JitterCompany/KicadComponents/3D/SRP3212A.stp

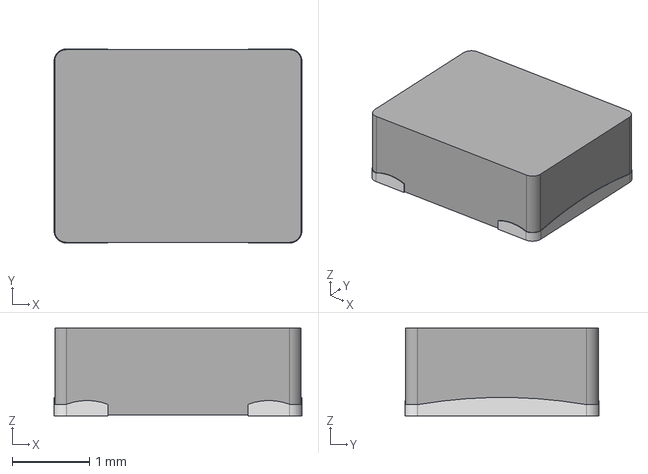
[picture p1: CAD file, 2026-11-06]
3D/SRP3212A.stp
3.22 x 2.52 x 1.14 mm
