JitterCompany/KicadComponents/3D/Hirose_FH12-40S-0.5SH_1x40-1MP_P0.50mm_Horizontal.step

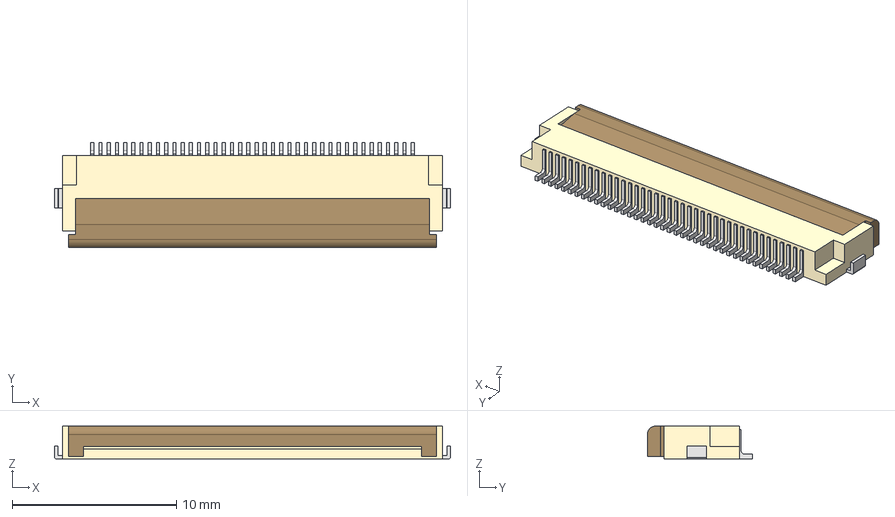
[picture p2: CAD file, 2026-08-26]
3D/Hirose_FH12-40S-0.5SH_1x40-1MP_P0.50mm_Horizontal.step
24.1 x 6.40 x 2.00 mm
lock
pins
