JitterCompany/KicadComponents/3D/Wurth_microSD_693072010801.stp

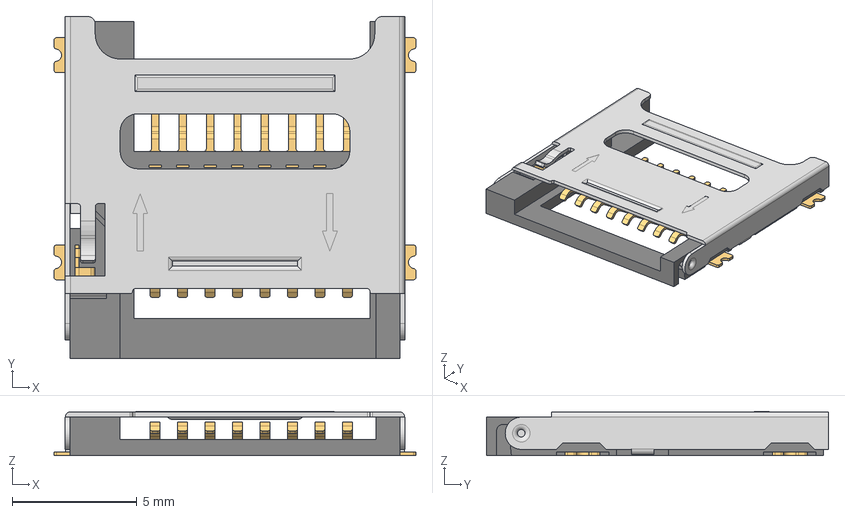
[picture p3: CAD file, 2026-08-25]
3D/Wurth_microSD_693072010801.stp
14.5 x 13.7 x 1.77 mm
693072010801_PIN x 8
693072010801_PATTE x 3
693072010801_CACHE
693072010801_PATTE_SPE
