JitterCompany/KicadComponents/3D/PT-1340P-P10-PQ.step

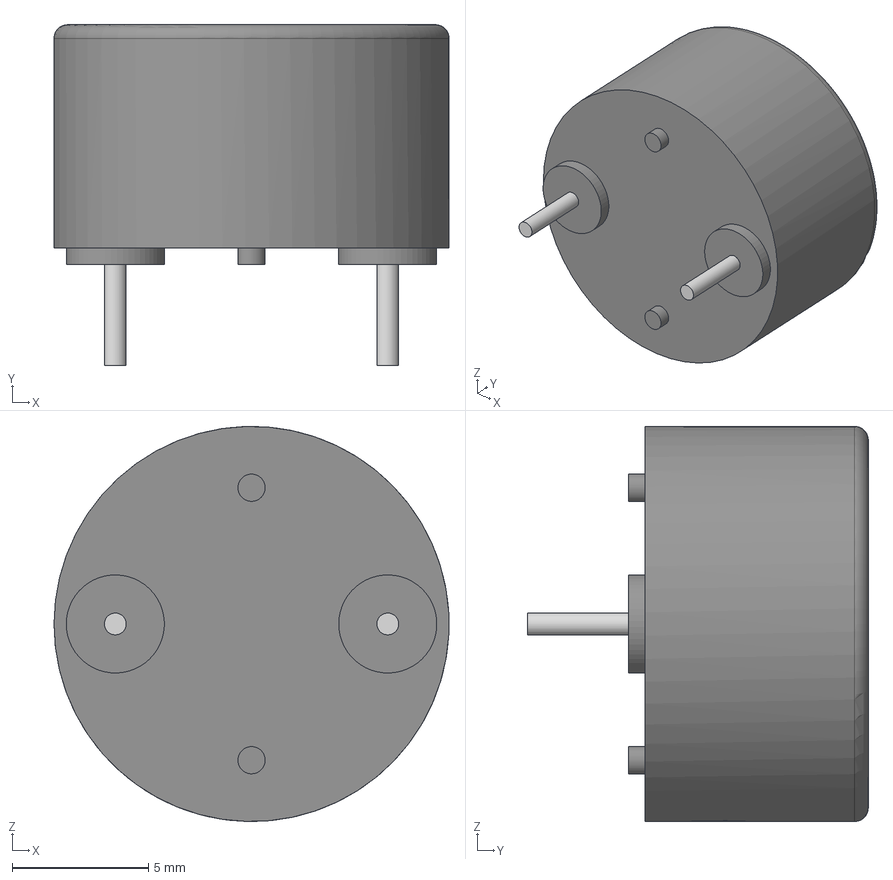
[picture p4: CAD file, 2026-08-25]
3D/PT-1340P-P10-PQ.step
14.5 x 12.5 x 14.5 mm
