JitterCompany/KicadComponents/3D/DHVQFN-14.step

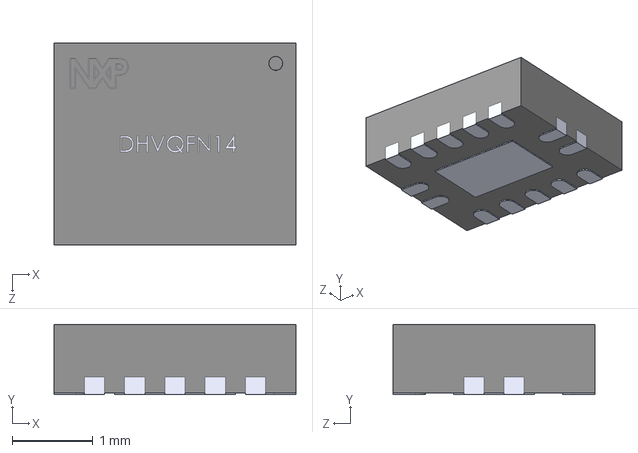
[picture p5: CAD file, 2026-08-25]
3D/DHVQFN-14.step
3.00 x 0.87 x 2.50 mm
