JitterCompany/KicadComponents/3D/M12A-08PFFP-SF8001.stp

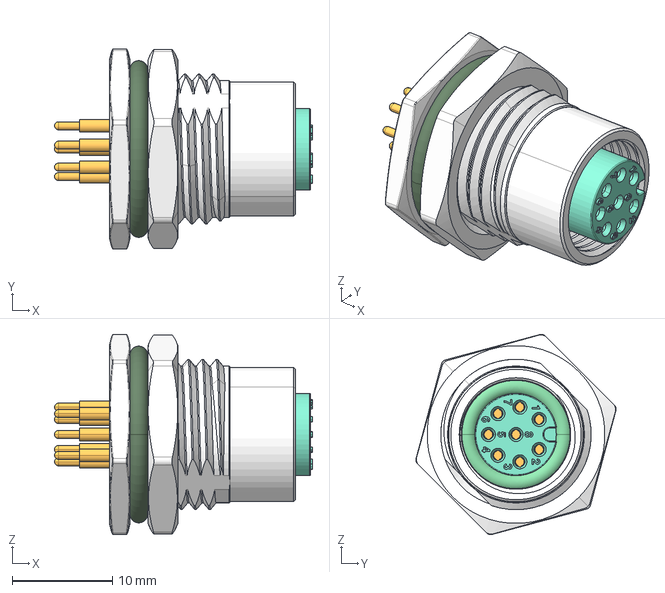
[picture p6: CAD file, 2026-08-17]
3D/M12A-08PFFP-SF8001.stp
25.7 x 20.0 x 20.0 mm
