JitterCompany/KicadComponents/3D/WE-CNSW_1206_CNSW.stp

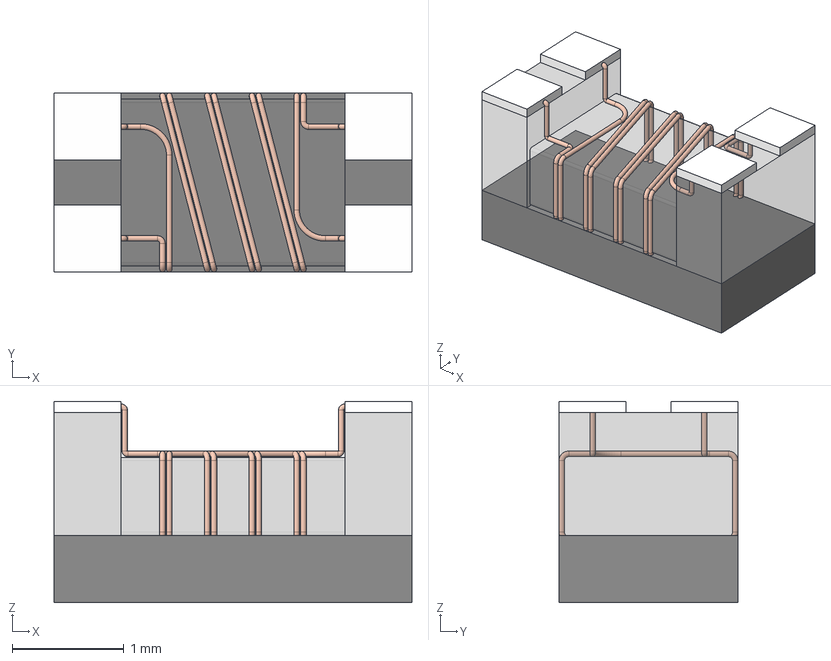
[picture p7: CAD file, 2026-08-17]
3D/WE-CNSW_1206_CNSW.stp
3.20 x 1.60 x 1.80 mm
Gehäuse
Boden
L飆fl踄he x 4
