JitterCompany/KicadComponents/3D/M12A-05PFFP-SF8001.step

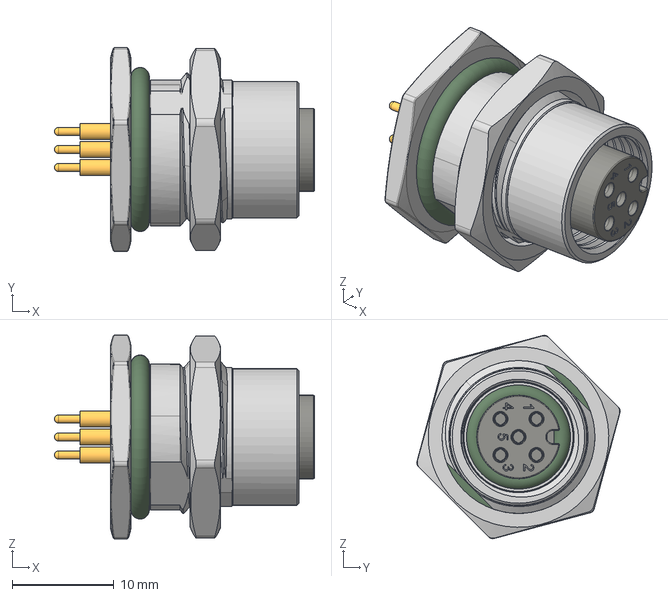
[picture p8: CAD file, 2026-08-17]
3D/M12A-05PFFP-SF8001.step
25.5 x 20.0 x 20.0 mm
