JitterCompany/KicadComponents/3D/U.FL_Hirose_U.FL-R-SMT-1_Vertical.step

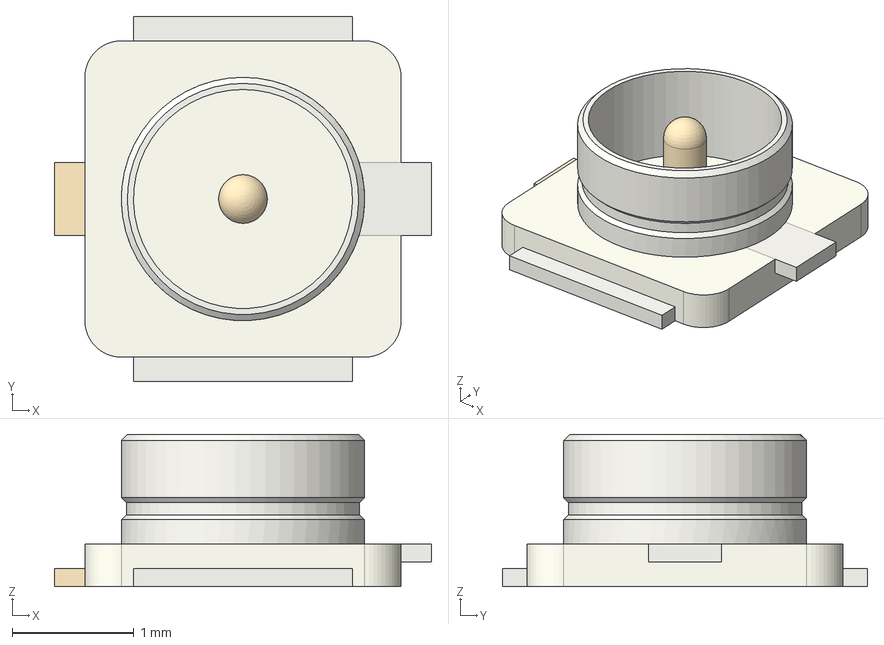
[picture p9: CAD file, 2026-08-17]
3D/U.FL_Hirose_U.FL-R-SMT-1_Vertical.step
3.10 x 3.00 x 1.25 mm
