JitterCompany/KicadComponents/3D/YMCP002AA.step

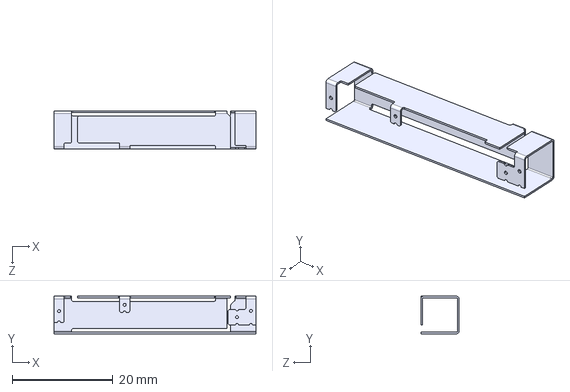
[picture p10: CAD file, 2026-08-17]
3D/YMCP002AA.step
40.0 x 7.43 x 7.60 mm
