JitterCompany/KicadComponents/3D/M12B-05PFFP-SF8001.stp

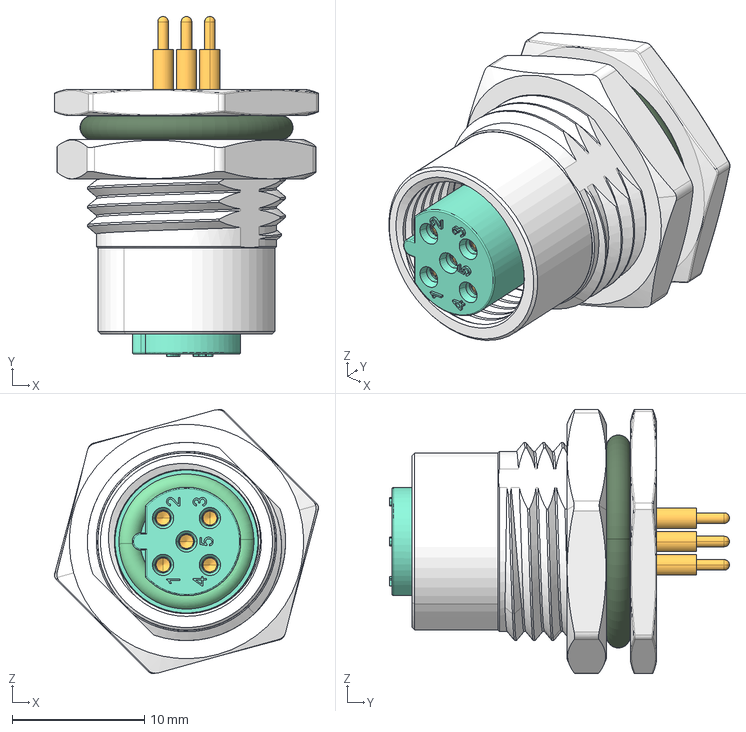
[picture p11: CAD file, 2026-08-17]
3D/M12B-05PFFP-SF8001.stp
20.0 x 25.7 x 20.0 mm
