JitterCompany/KicadComponents/3D/Quectel_EG915N.STEP

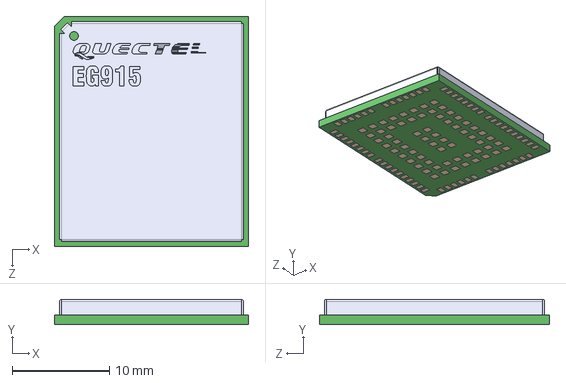
[picture p12: CAD file, 2026-08-17]
3D/Quectel_EG915N.STEP
19.9 x 2.60 x 23.6 mm
