JitterCompany/KicadComponents/3D/WE-MAPI-5030.stp

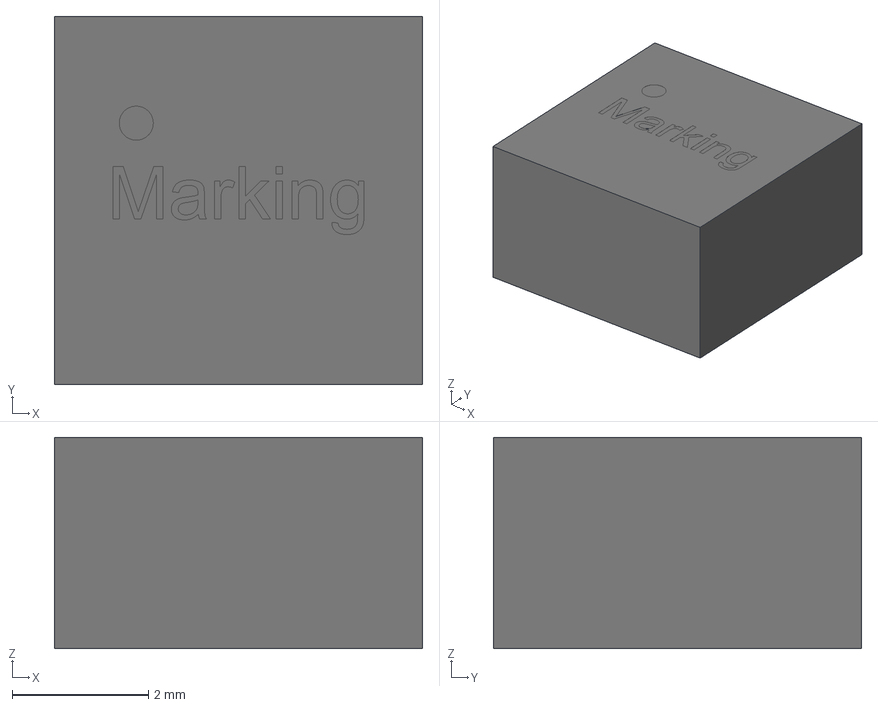
[picture p13: CAD file, 2026-08-17]
3D/WE-MAPI-5030.stp
5.40 x 5.40 x 3.10 mm
body_SSMC_5030
land_pattern x 2
