JitterCompany/KicadComponents/3D/DGN0008G_VSSOP-8_EP.stp

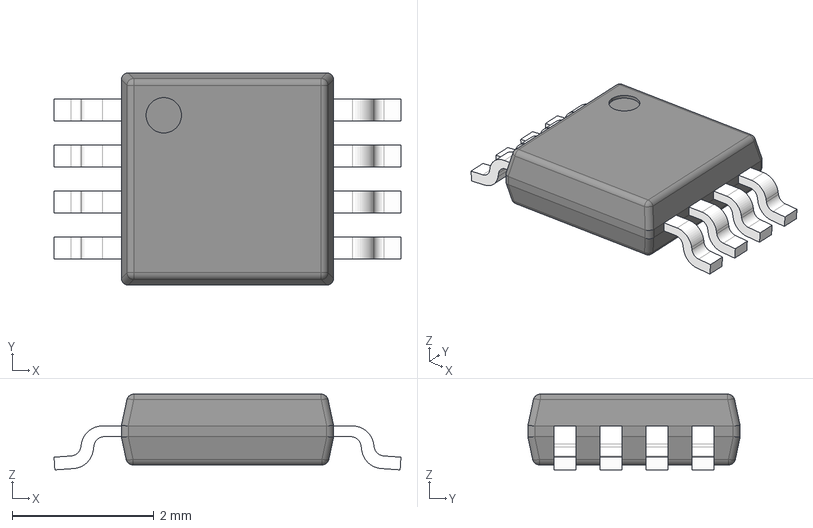
[picture p15: CAD file, 2026-08-17]
3D/DGN0008G_VSSOP-8_EP.stp
4.90 x 3.00 x 1.07 mm
BODY-DGN0008G
LEAD-DGN0008G x 8
PIN1_DGN0008G
DAP_DGN0008G
