JitterCompany/KicadComponents/3D/MSBS-05PFFP-SF8001.stp

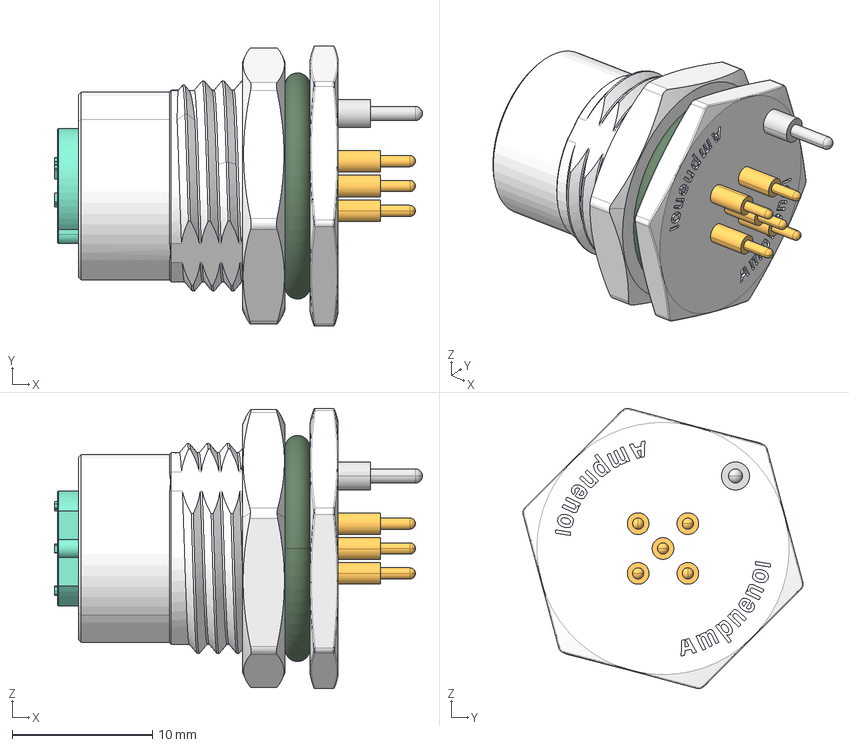
[picture p16: CAD file, 2026-08-17]
3D/MSBS-05PFFP-SF8001.stp
26.2 x 20.0 x 20.0 mm
