JitterCompany/KicadComponents/3D/SOT-363_SC-70-6.step

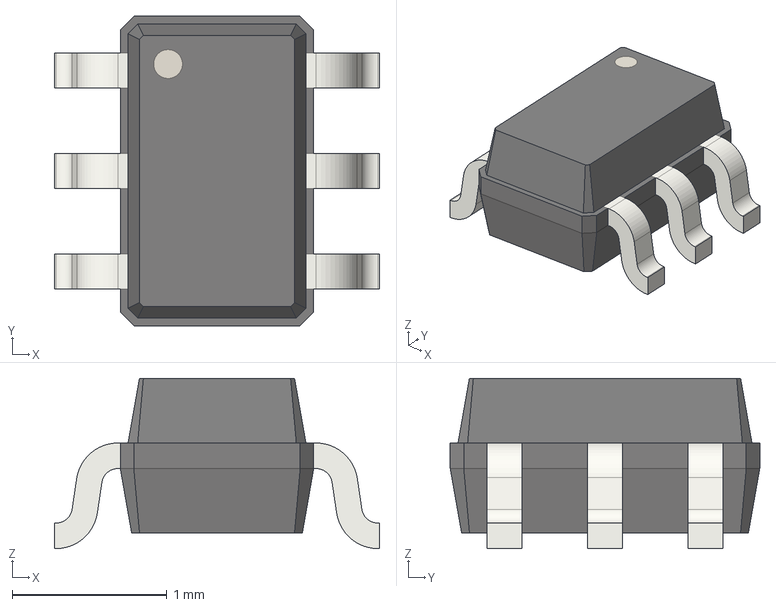
[picture p17: CAD file, 2026-08-17]
3D/SOT-363_SC-70-6.step
2.10 x 2.00 x 1.10 mm
