JitterCompany/KicadComponents/3D/samtec_clm-110-02-l-d.stp

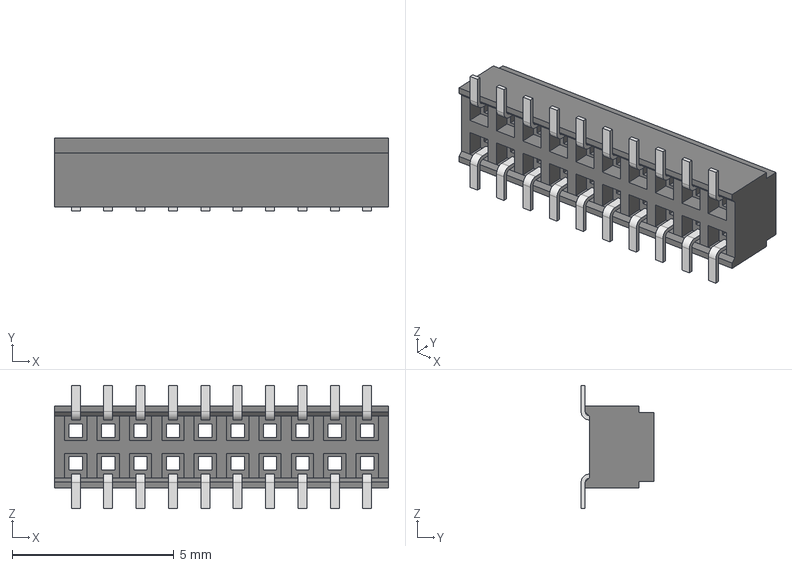
[picture p18: CAD file, 2026-08-17]
3D/samtec_clm-110-02-l-d.stp
10.3 x 2.25 x 3.81 mm
