JitterCompany/KicadComponents/3D/TO-269AA.step

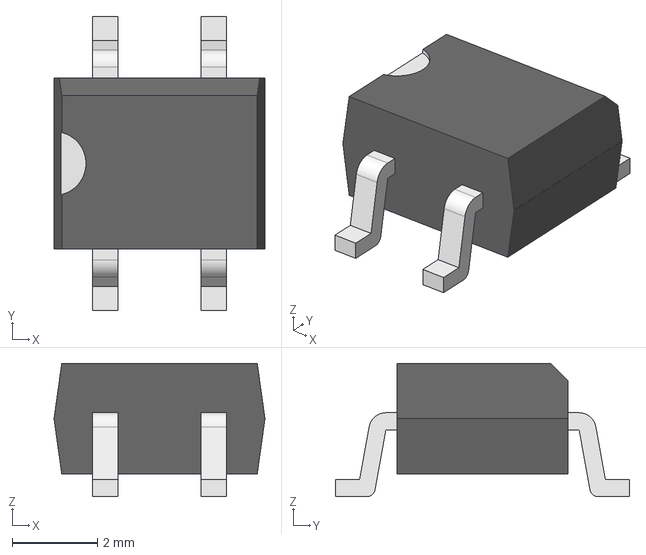
[picture p19: CAD file, 2026-08-17]
3D/TO-269AA.step
4.95 x 6.90 x 3.13 mm
