JitterCompany/KicadComponents/3D/GCT_USB4120-03-C_REVA.step

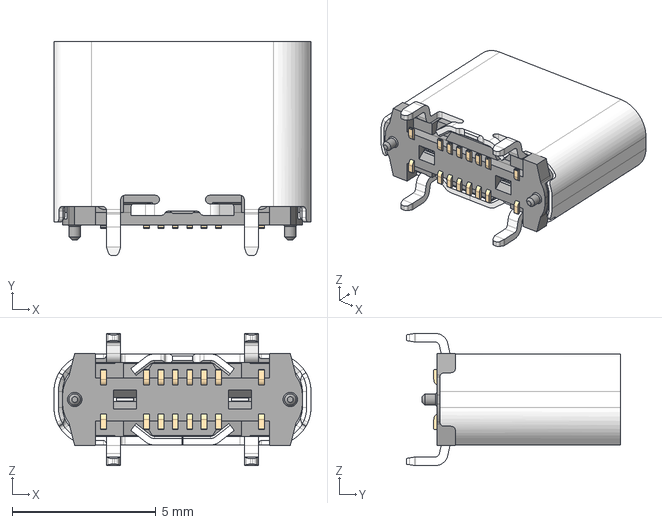
[picture p20: CAD file, 2025-04-25]
3D/GCT_USB4120-03-C_REVA.step
8.94 x 7.45 x 4.60 mm
