JitterCompany/KicadComponents/3D/PreciDip_811_6P.step

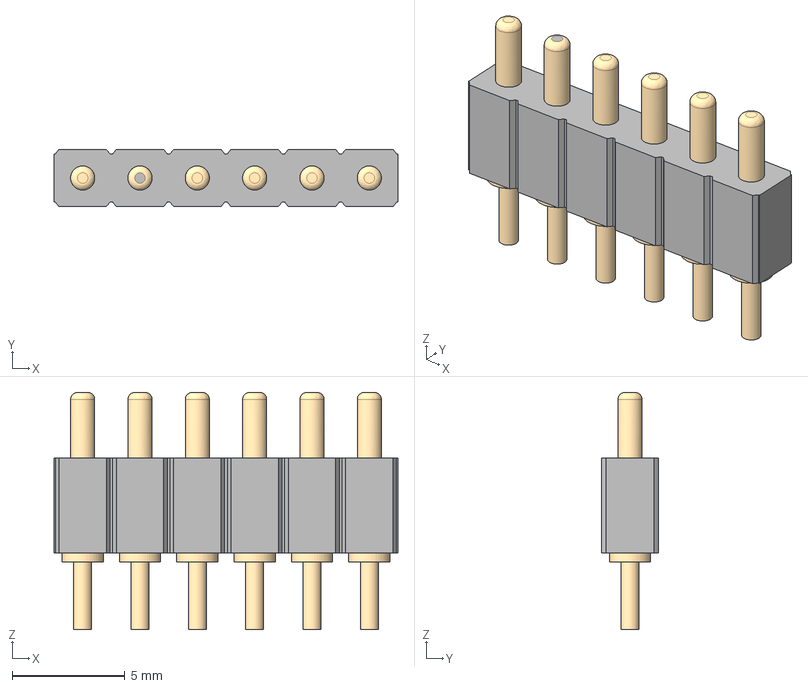
[picture p21: CAD file, 2025-04-25]
3D/PreciDip_811_6P.step
15.2 x 2.54 x 10.5 mm
