JitterCompany/KicadComponents/3D/Wurth_WR_WTB_66100811622_1x08_P2.54mm_Vertical.stp

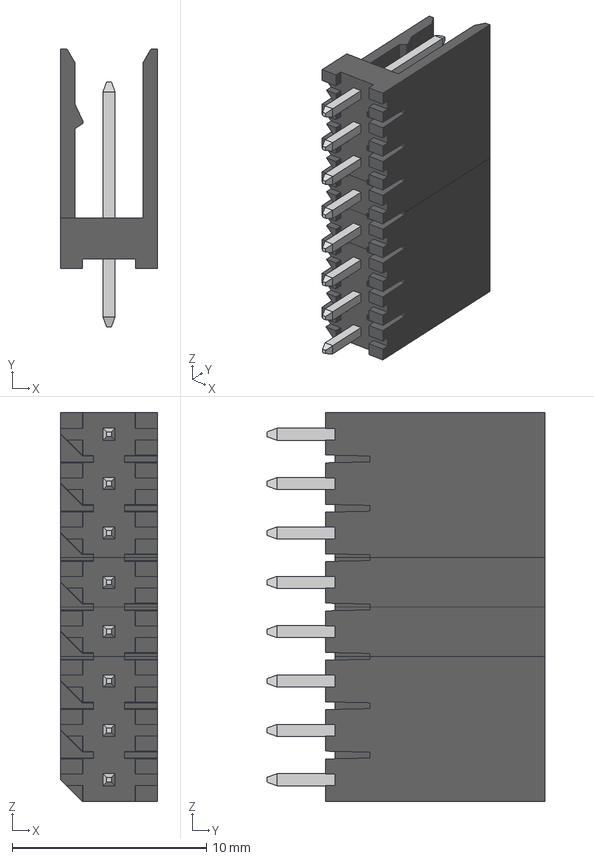
[picture p22: CAD file, 2025-04-25]
3D/Wurth_WR_WTB_66100811622_1x08_P2.54mm_Vertical.stp
5.00 x 14.3 x 20.0 mm
6610xx11622_07_20_DX
6610xx11622_07_20_SX
