JitterCompany/KicadComponents/3D/C&K_KMR7_button.step

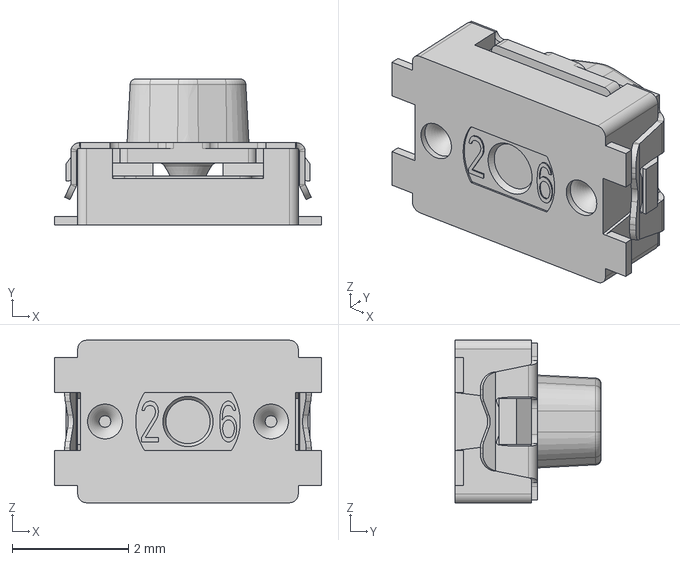
[picture p23: CAD file, 2025-04-25]
3D/C&K_KMR7_button.step
4.60 x 2.52 x 2.80 mm
