JitterCompany/KicadComponents/3D/Wurth_WR_WTB_66100211622_1x02_P2.54mm_Vertical.stp

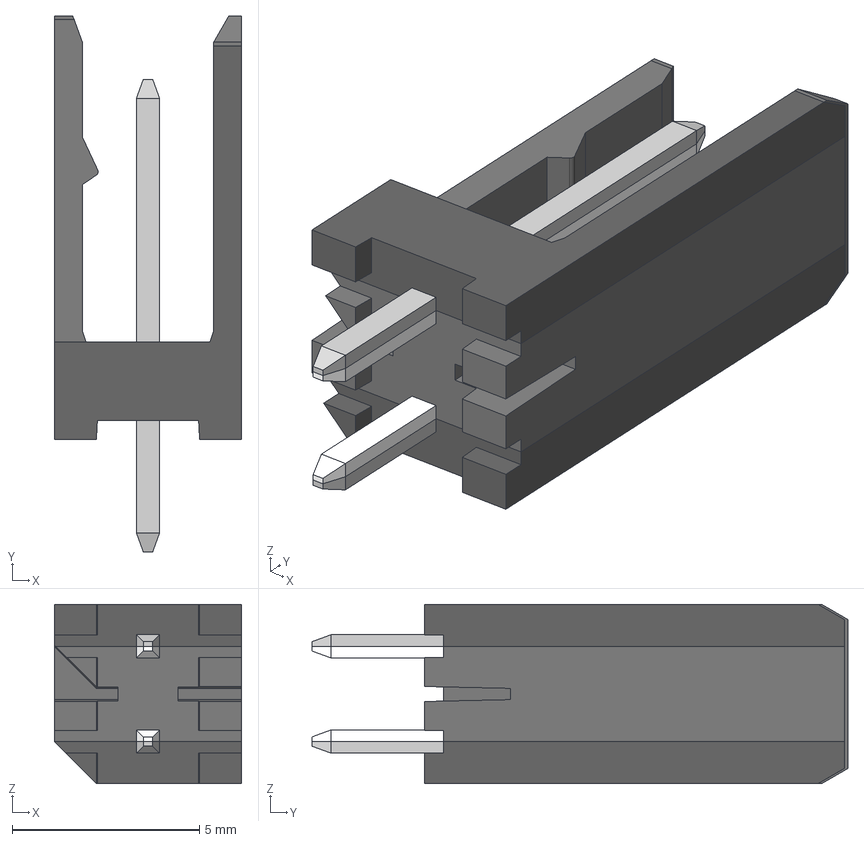
[picture p24: CAD file, 2025-04-25]
3D/Wurth_WR_WTB_66100211622_1x02_P2.54mm_Vertical.stp
5.00 x 14.3 x 4.78 mm
6610xx11622_02_06_DX
6610xx11622_02_06_SX
66100211622_Patch
