JitterCompany/KicadComponents/3D/MDT0320ASHH-MULTI.step

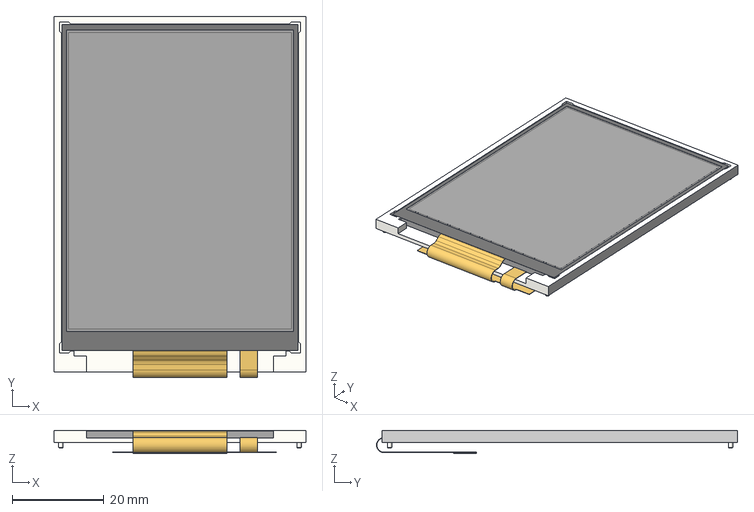
[picture p25: CAD file, 2025-04-25]
3D/MDT0320ASHH-MULTI.step
55.0 x 78.8 x 5.05 mm
