JitterCompany/KicadComponents/3D/WE_691313510002.stp

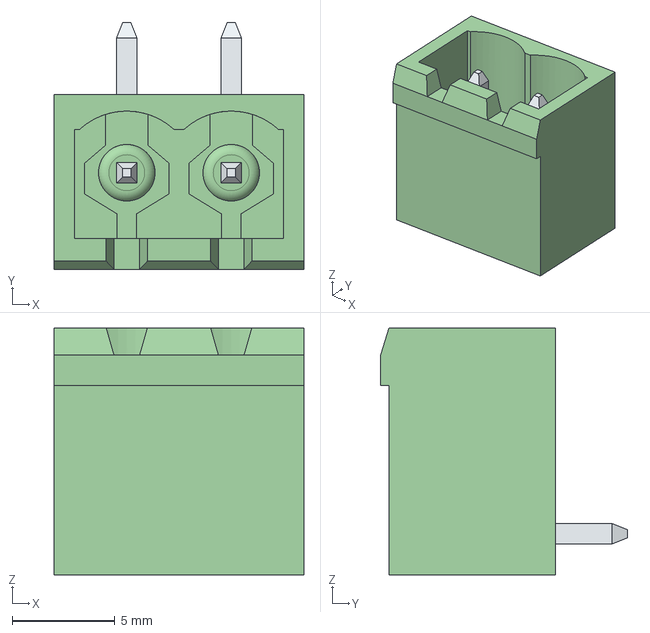
[picture p26: CAD file, 2025-04-25]
3D/WE_691313510002.stp
12.2 x 12.0 x 12.0 mm
6913135100xx_PIN x 2
