JitterCompany/KicadComponents/3D/ABS06-32.768KHZ-T.STEP

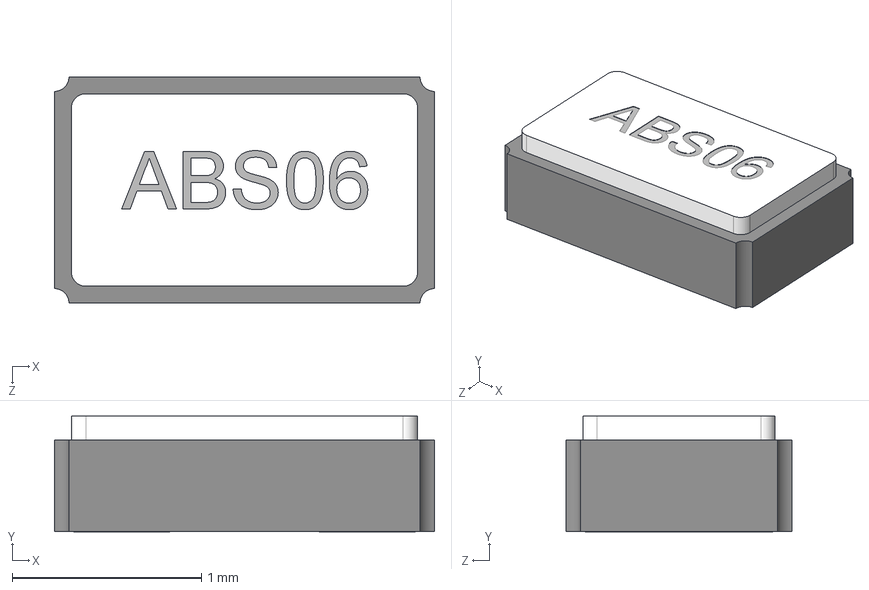
[picture p27: CAD file, 2025-04-25]
3D/ABS06-32.768KHZ-T.STEP
2.01 x 0.612 x 1.19 mm
