JitterCompany/KicadComponents/3D/Wurth_WR_WTB_66100511622_1x05_P2.54mm_Vertical.stp

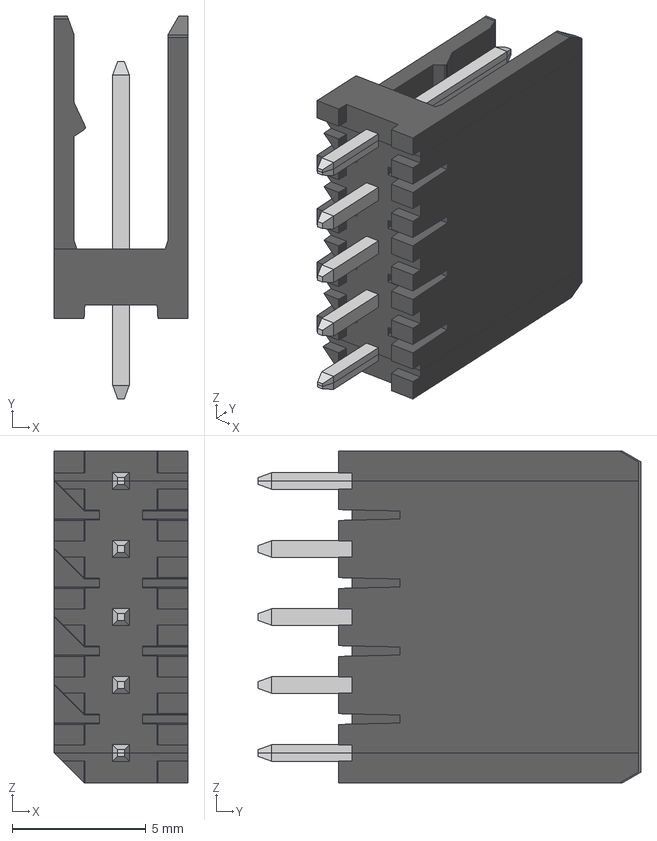
[picture p28: CAD file, 2025-04-25]
3D/Wurth_WR_WTB_66100511622_1x05_P2.54mm_Vertical.stp
5.00 x 14.3 x 12.4 mm
6610xx11622_02_06_DX
6610xx11622_02_06_SX
66100511622_Patch
