JitterCompany/KicadComponents/3D/TISP4015L1AJR-S.stp

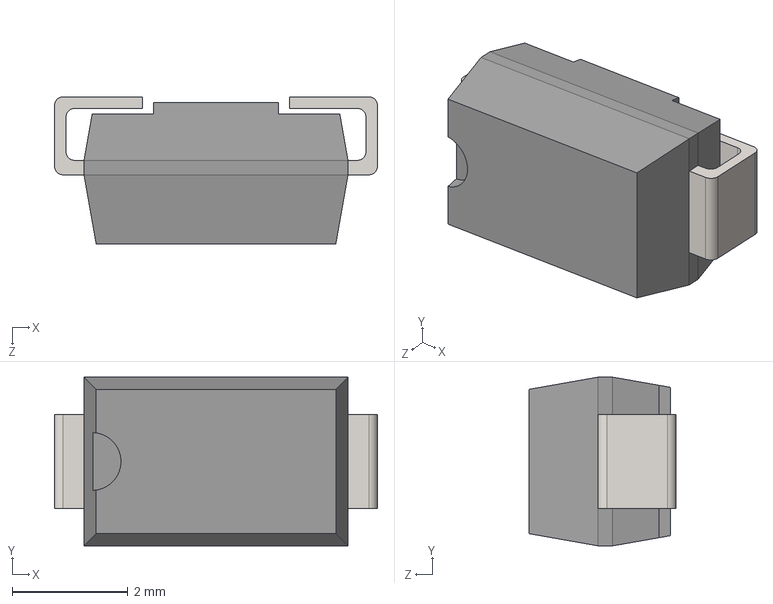
[picture p29: CAD file, 2025-04-25]
3D/TISP4015L1AJR-S.stp
5.59 x 2.92 x 2.55 mm
