JitterCompany/KicadComponents/3D/potmeter_bourns_3352H-1.STEP

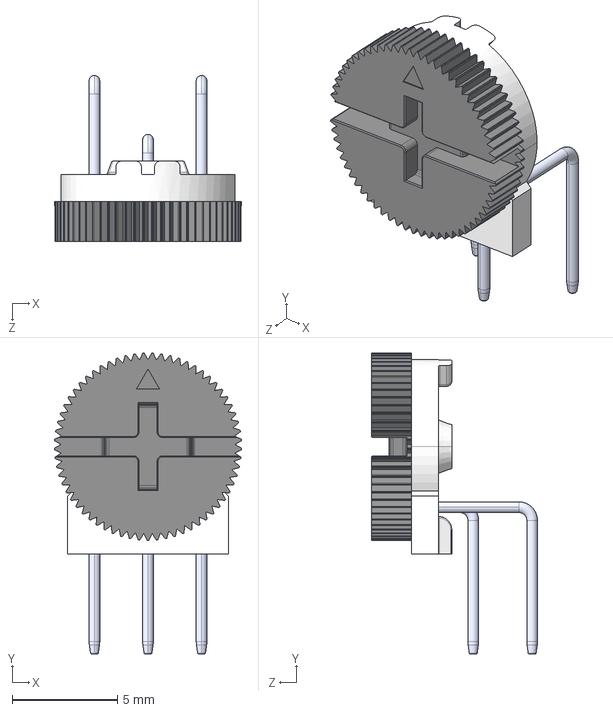
[picture p30: CAD file, 2025-04-25]
3D/potmeter_bourns_3352H-1.STEP
8.89 x 14.3 x 7.87 mm
