JitterCompany/KicadComponents/3D/SRP1050_inductor.step

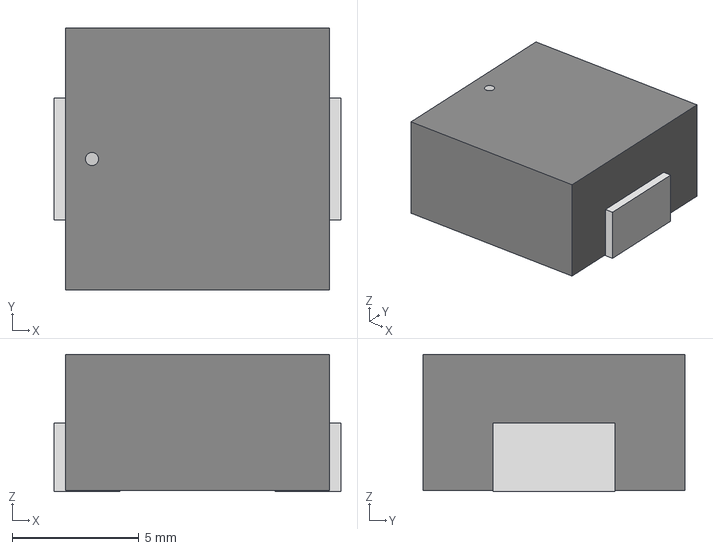
[picture p31: CAD file, 2025-04-25]
3D/SRP1050_inductor.step
11.3 x 10.3 x 5.41 mm
