JitterCompany/KicadComponents/3D/HDMI_A.stp

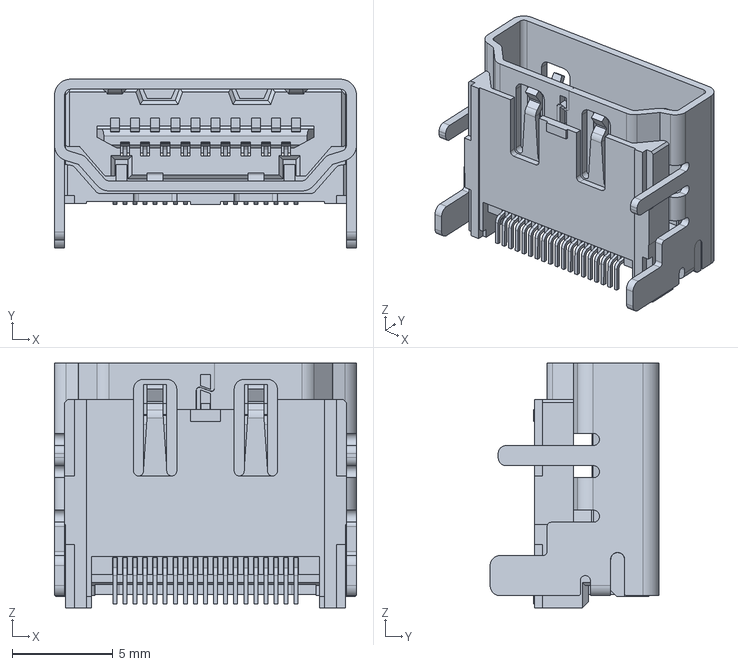
[picture p32: CAD file, 2025-04-25]
3D/HDMI_A.stp
15.0 x 8.38 x 12.2 mm
