JitterCompany/KicadComponents/3D/tqfp32-5x5.step

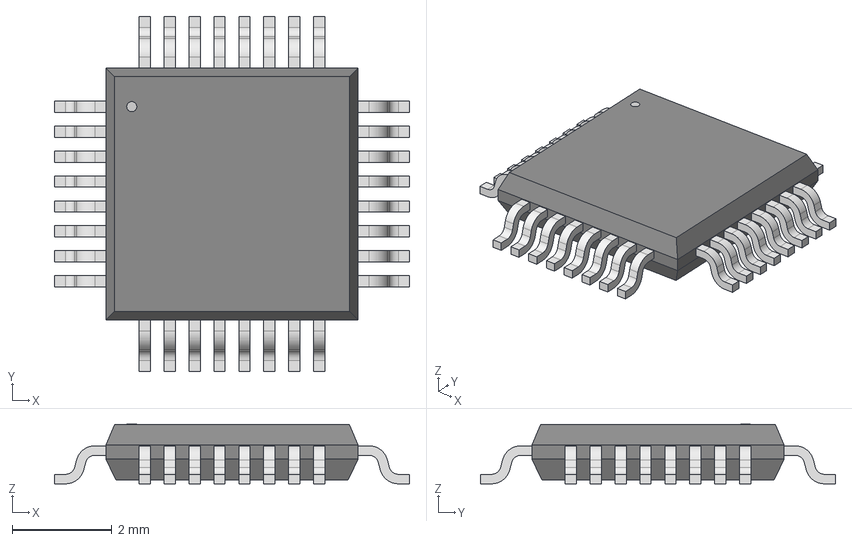
[picture p33: CAD file, 2025-04-25]
3D/tqfp32-5x5.step
7.11 x 7.11 x 1.20 mm
