JitterCompany/KicadComponents/3D/STLINK-V3MODS.stp

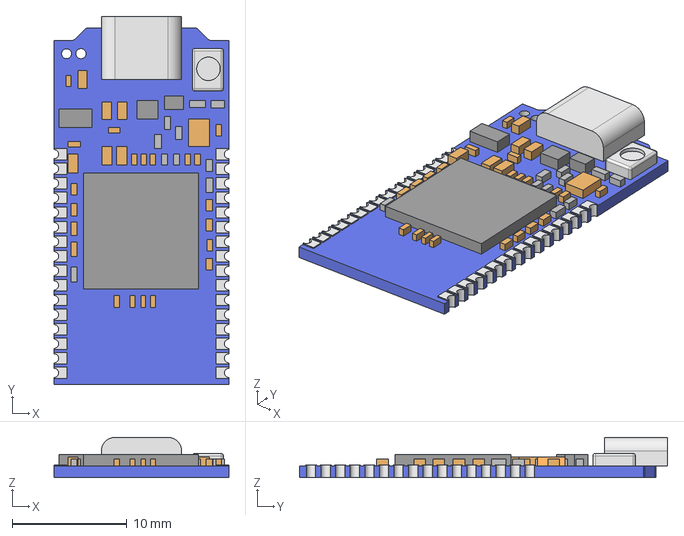
[picture p34: CAD file, 2025-04-25]
3D/STLINK-V3MODS.stp
15.2 x 32.1 x 3.50 mm
