JitterCompany/KicadComponents/3D/sot-323FL.step

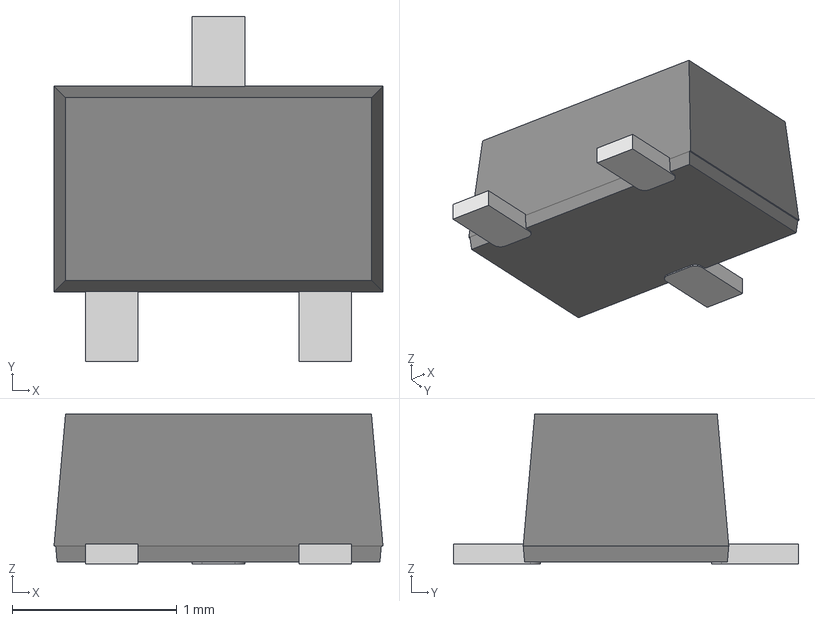
[picture p35: CAD file, 2025-04-25]
3D/sot-323FL.step
2.00 x 2.10 x 0.91 mm
3D_Model_UMT3F-prt0
3D_Model_UMT3F-prt1
3D_Model_UMT3F-prt2
3D_Model_UMT3F-prt3
