JitterCompany/KicadComponents/3D/CON-SMA-EDGE-S.step

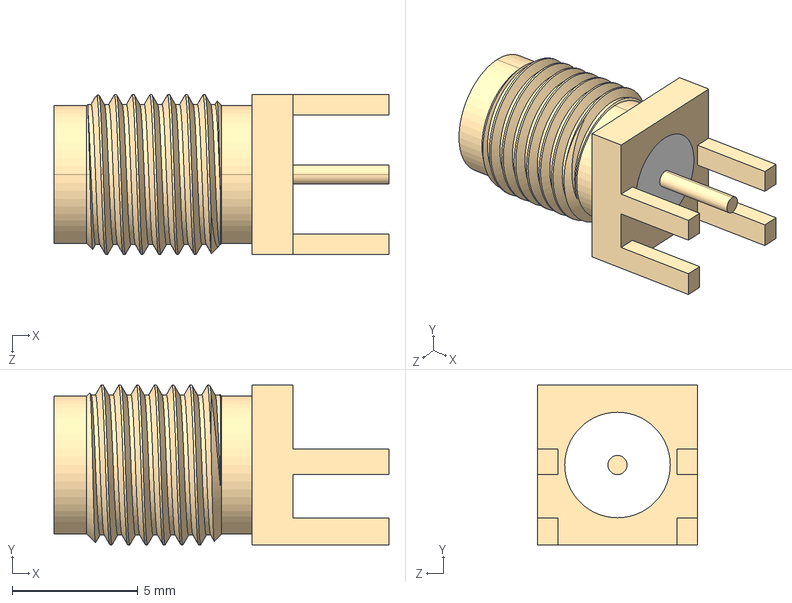
[picture p36: CAD file, 2025-04-25]
3D/CON-SMA-EDGE-S.step
13.3 x 6.35 x 6.35 mm
