JitterCompany/KicadComponents/3D/BatteryHolder_Keystone_PN2894.STEP

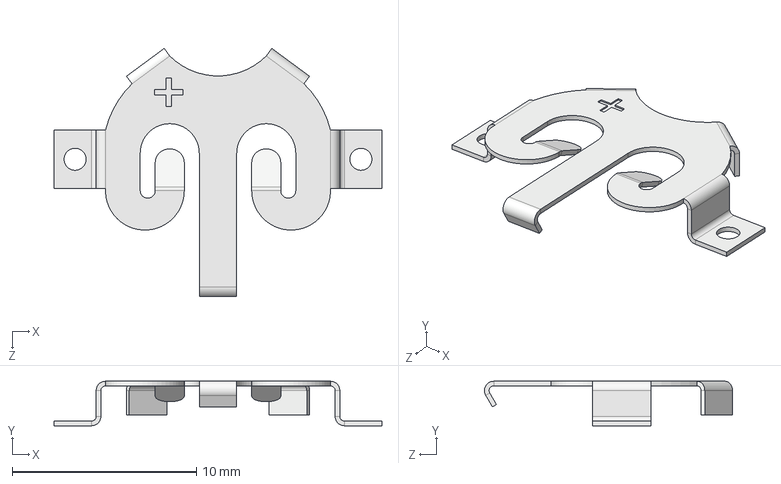
[picture p37: CAD file, 2025-04-25]
3D/BatteryHolder_Keystone_PN2894.STEP
17.8 x 2.42 x 13.5 mm
