JitterCompany/KicadComponents/3D/Stocko_MKS_2853-6-0-303_1x3_P2.50mm_Horizontal.step

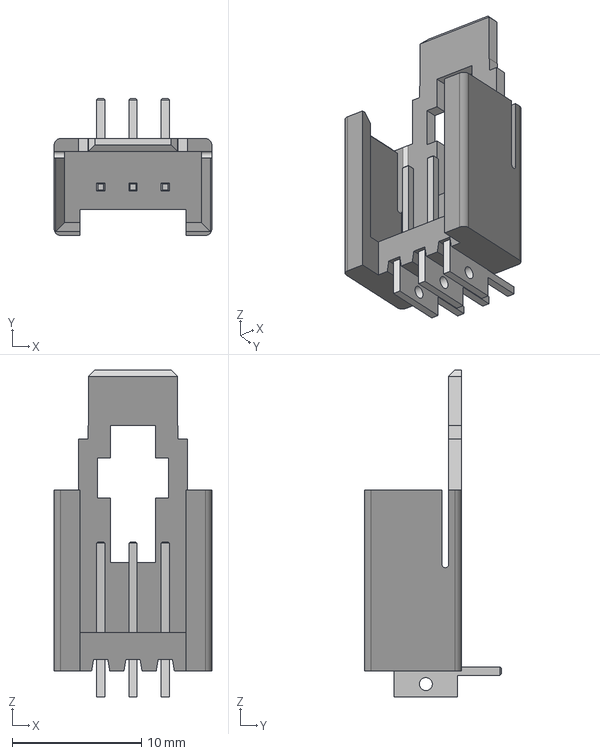
[picture p38: CAD file, 2024-08-22]
3D/Stocko_MKS_2853-6-0-303_1x3_P2.50mm_Horizontal.step
12.2 x 10.6 x 25.3 mm
