JitterCompany/KicadComponents/3D/JST_S10B-PH-SM4-TB.STEP

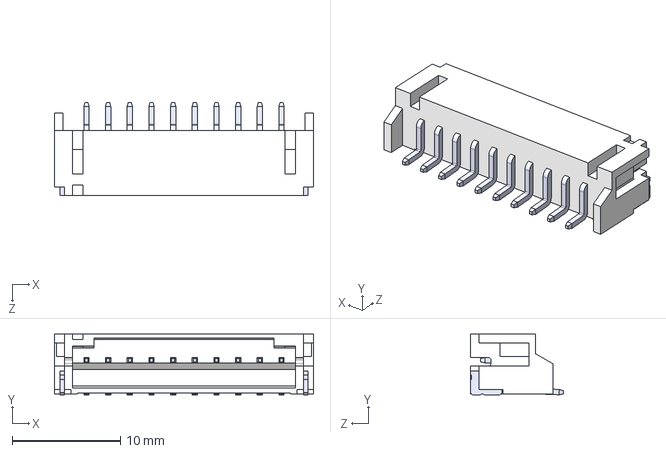
[picture p39: CAD file, 2024-08-22]
3D/JST_S10B-PH-SM4-TB.STEP
23.9 x 5.60 x 8.60 mm
