JitterCompany/KicadComponents/3D/FH12-20S-0.5SV.stp

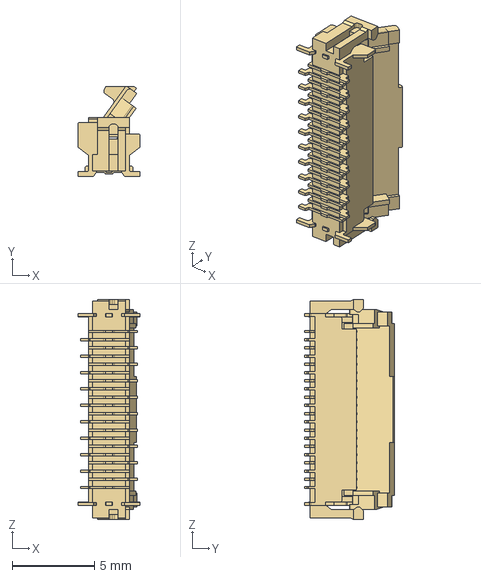
[picture p40: CAD file, 2024-08-22]
3D/FH12-20S-0.5SV.stp
3.80 x 5.50 x 13.4 mm
