JitterCompany/KicadComponents/3D/TE_5499786-1.stp

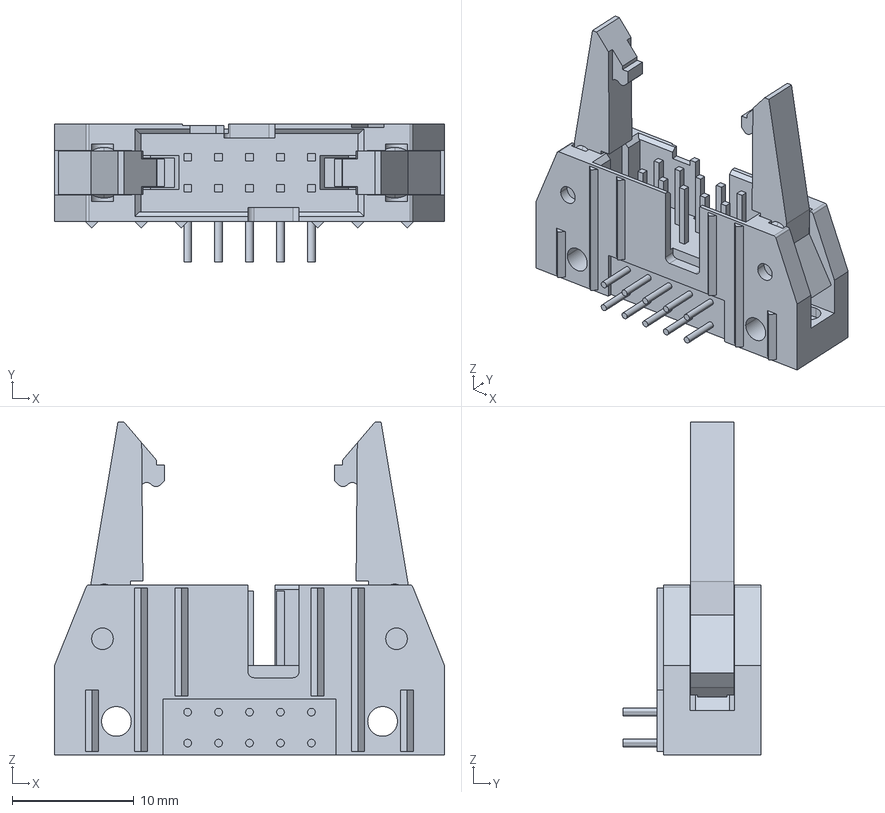
[picture p41: CAD file, 2024-08-13]
3D/TE_5499786-1.stp
32.0 x 11.3 x 27.3 mm
