JitterCompany/KicadComponents/3D/CSP6_BAL-UWB-01E3_STM.step

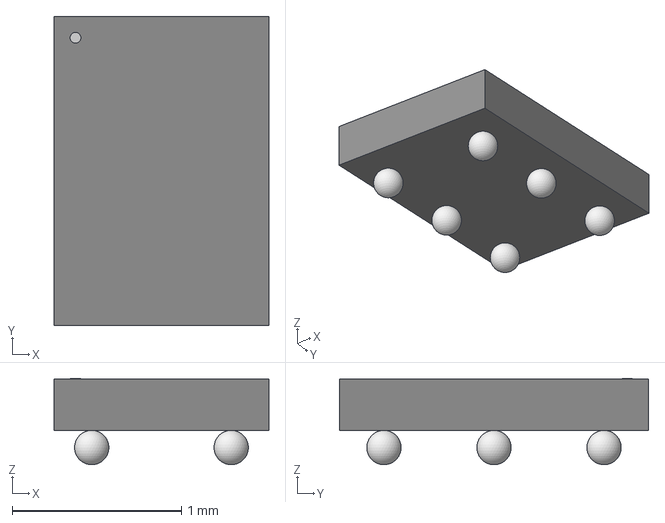
[picture p42: CAD file, 2024-08-13]
3D/CSP6_BAL-UWB-01E3_STM.step
1.27 x 1.83 x 0.511 mm
