JitterCompany/KicadComponents/3D/Stocko_MKS_2862-6-0-1212_1x12_P2.50mm_Horizontal.step

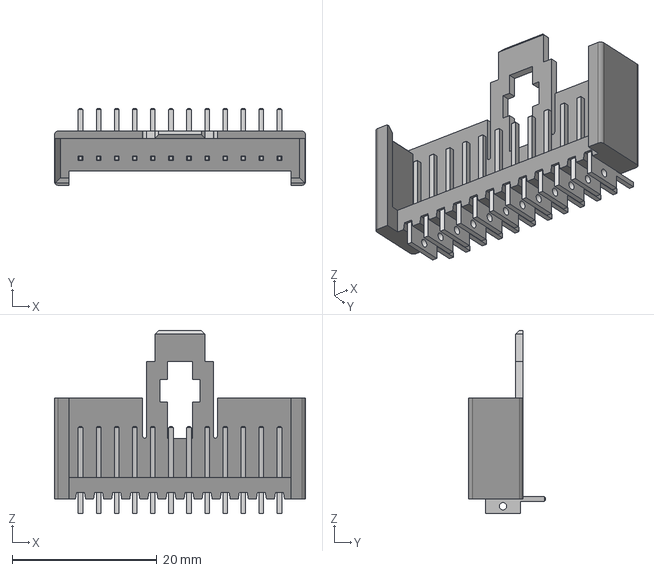
[picture p43: CAD file, 2024-08-13]
3D/Stocko_MKS_2862-6-0-1212_1x12_P2.50mm_Horizontal.step
34.7 x 10.6 x 25.3 mm
