JitterCompany/KicadComponents/3D/PTSM_0.5_2-HH0-2.5-SMD.STEP

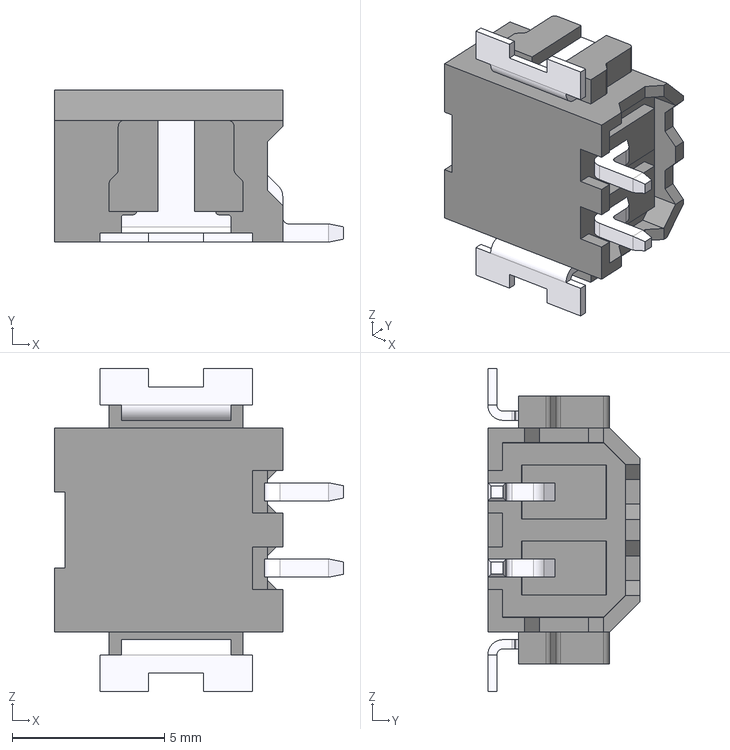
[picture p44: CAD file, 2024-08-13]
3D/PTSM_0.5_2-HH0-2.5-SMD.STEP
9.50 x 5.00 x 10.6 mm
