JitterCompany/KicadComponents/3D/TE_5-520314-5_1x05_P2.54mm_Horizontal.stp

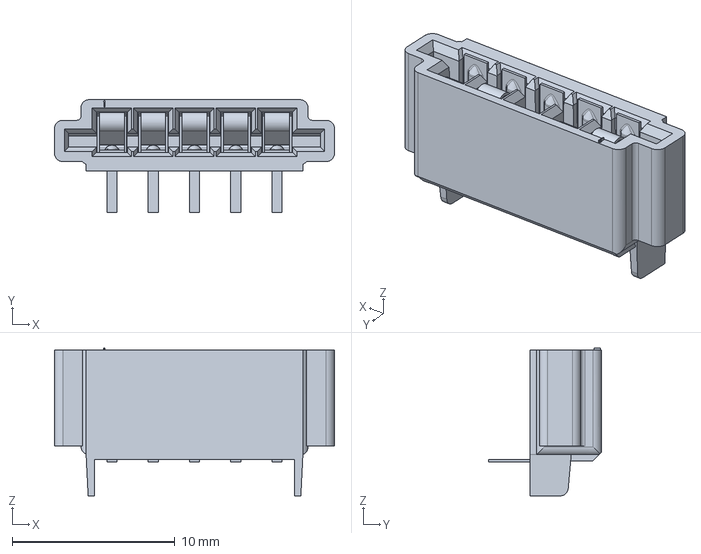
[picture p45: CAD file, 2024-08-13]
3D/TE_5-520314-5_1x05_P2.54mm_Horizontal.stp
17.2 x 6.93 x 9.09 mm
