JitterCompany/KicadComponents/3D/buzzer-sma-21-p17_5.stp

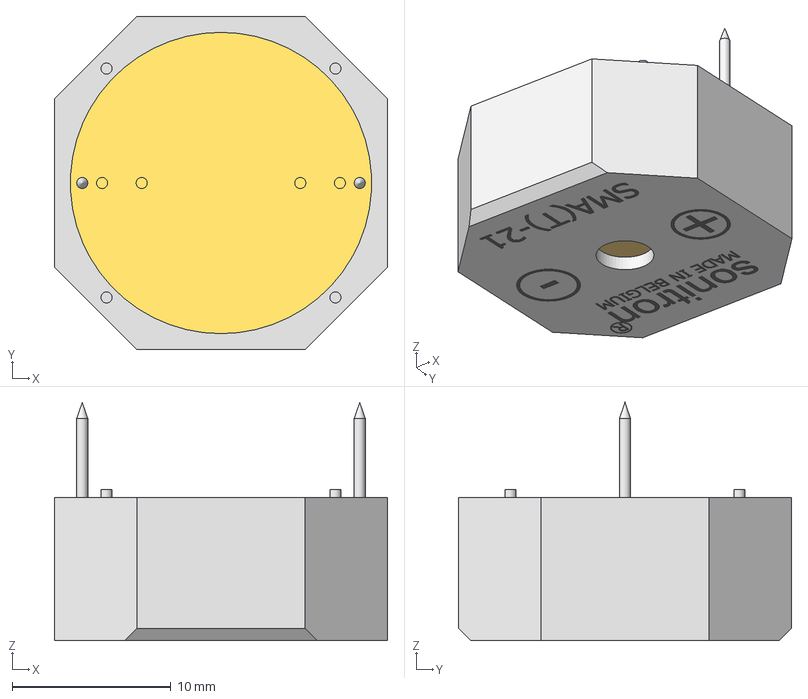
[picture p46: CAD file, 2024-08-13]
3D/buzzer-sma-21-p17_5.stp
21.0 x 21.0 x 15.0 mm
behuizing SMA21
Membraam
Print
Pin x 2
