JitterCompany/KicadComponents/3D/ESP32-S3-WROOM-2-N32R8V--3DModel-STEP-510211.STEP

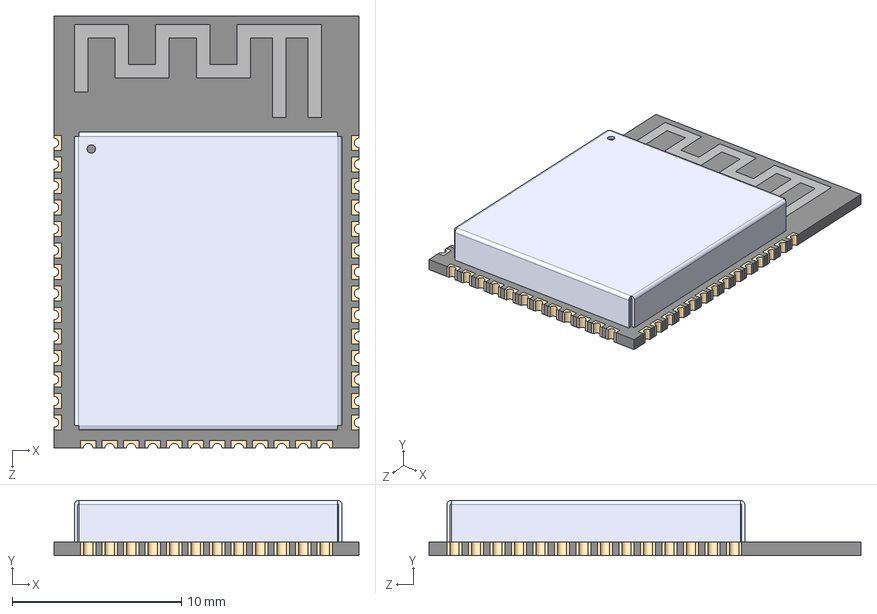
[picture p47: CAD file, 2024-08-13]
3D/ESP32-S3-WROOM-2-N32R8V--3DModel-STEP-510211.STEP
18.0 x 3.25 x 25.5 mm
