JitterCompany/KicadComponents/3D/switch_EVQ-PE104K.step

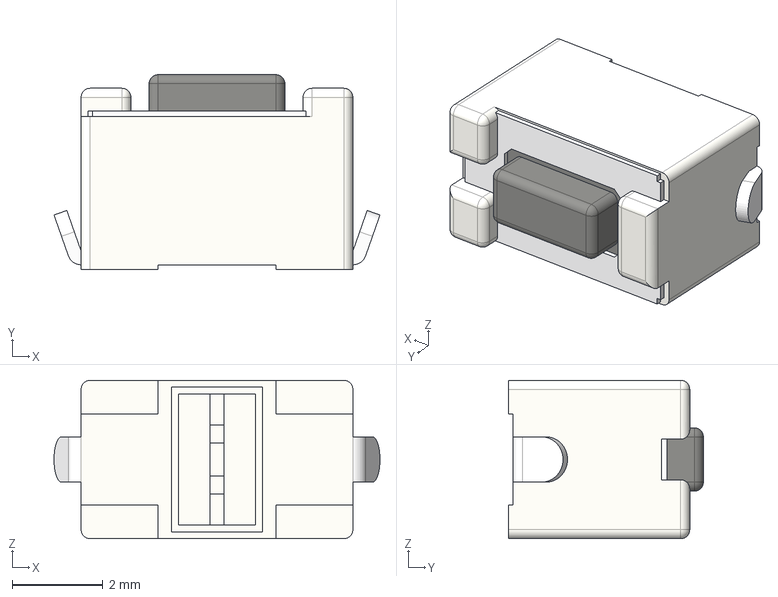
[picture p48: CAD file, 2024-08-13]
3D/switch_EVQ-PE104K.step
7.20 x 4.30 x 3.50 mm
