JitterCompany/KicadComponents/3D/Stocko_MKS_1854-6-0-404_1x4_P2.50mm_Vertical.step

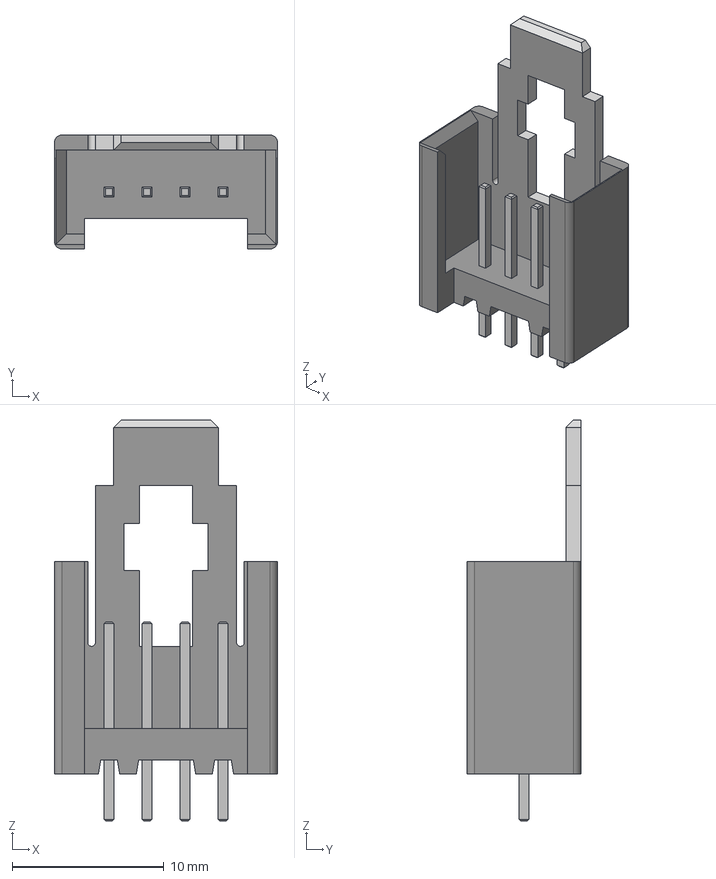
[picture p49: CAD file, 2024-08-13]
3D/Stocko_MKS_1854-6-0-404_1x4_P2.50mm_Vertical.step
14.7 x 7.50 x 26.4 mm
