JitterCompany/KicadComponents/3D/wago_237-102.stp

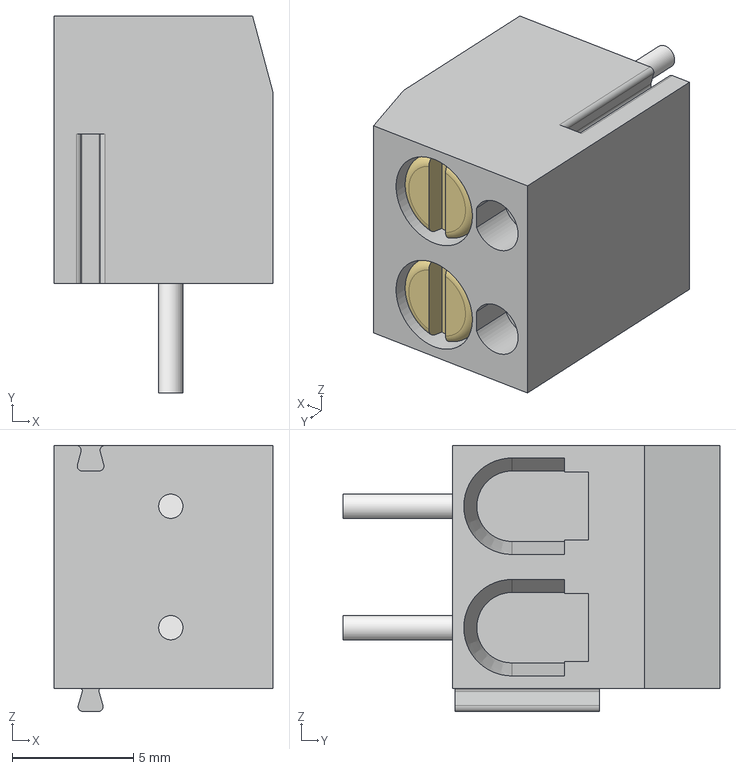
[picture p50: CAD file, 2024-08-13]
3D/wago_237-102.stp
9.00 x 15.5 x 10.9 mm
