JitterCompany/KicadComponents/3D/TE_6-520314-7_1x17_P2.54mm_Horizontal.stp

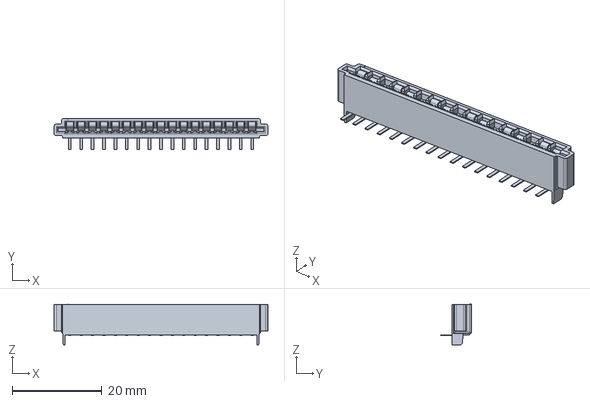
[picture p51: CAD file, 2024-08-13]
3D/TE_6-520314-7_1x17_P2.54mm_Horizontal.stp
47.7 x 6.93 x 9.09 mm
