JitterCompany/KicadComponents/3D/SCF4030-12-02.stp

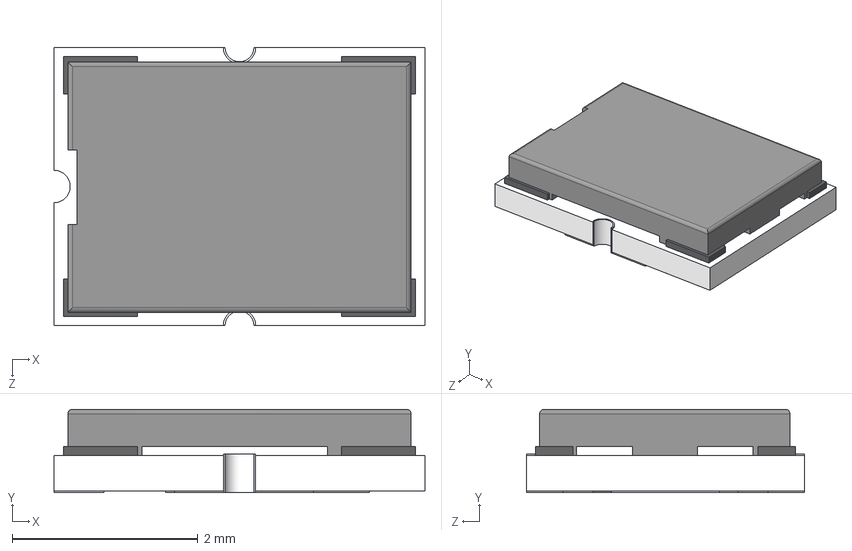
[picture p52: CAD file, 2024-02-19]
3D/SCF4030-12-02.stp
4.00 x 0.9 x 3.00 mm
奻裔
ｱｳｲｿｺｸﾅﾌ
價啣陔
籵謂1
ｱｳｲｿｺｸﾅﾌ2
籵謂2
左右电极背面 (2)
窪蝶1
窪蝶2
窪蝶3
窪蝶4
