JitterCompany/KicadComponents/3D/jitter_batt_clip_18650_clamped.step

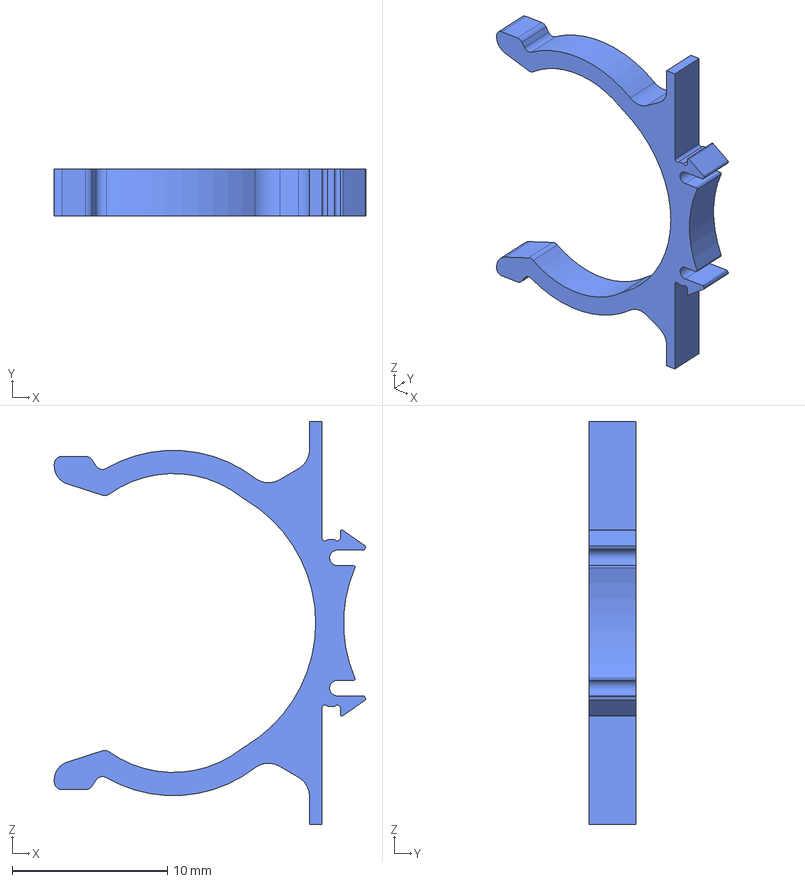
[picture p53: CAD file, 2024-02-19]
3D/jitter_batt_clip_18650_clamped.step
20.1 x 3.00 x 26.0 mm
