JitterCompany/KicadComponents/3D/TCO_Bourns_SA_series.step

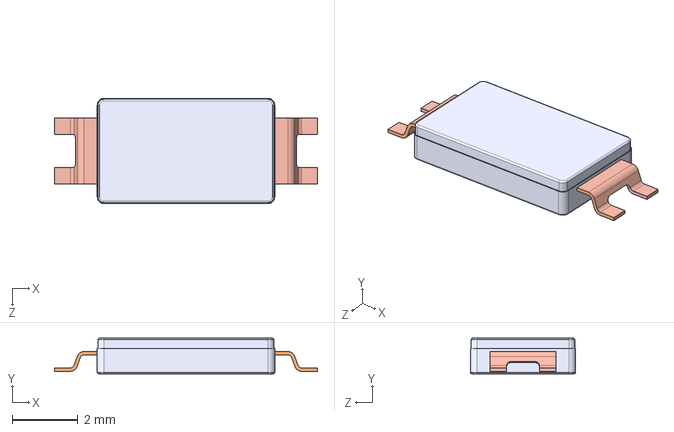
[picture p54: CAD file, 2024-02-19]
3D/TCO_Bourns_SA_series.step
8.00 x 1.09 x 3.20 mm
SA外形
SA外形図用_SA-PAT-01(製品部) x 2
