JitterCompany/KicadComponents/3D/TI_WSON8-DMS.step

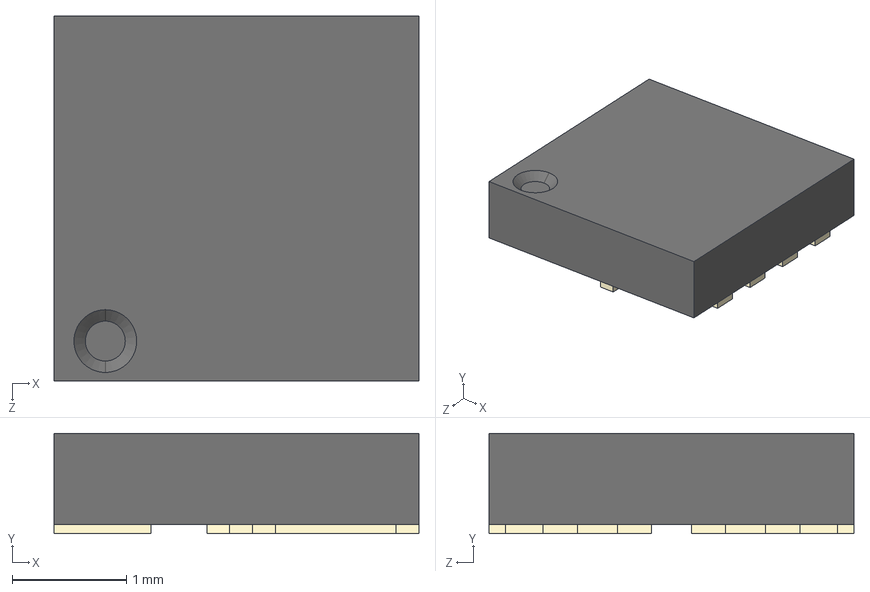
[picture p55: CAD file, 2024-02-19]
3D/TI_WSON8-DMS.step
3.20 x 0.88 x 3.20 mm
