JitterCompany/KicadComponents/3D/TI_VSON8-3x3.stp

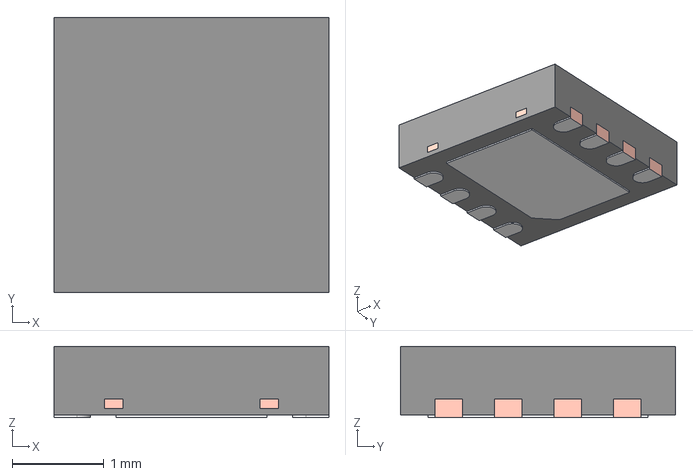
[picture p56: CAD file, 2024-02-19]
3D/TI_VSON8-3x3.stp
3.00 x 3.00 x 0.775 mm
BODY-SON
FRAME-DRB0008B
