JitterCompany/KicadComponents/3D/slc_connector_811-s1-004-30-014101.stp

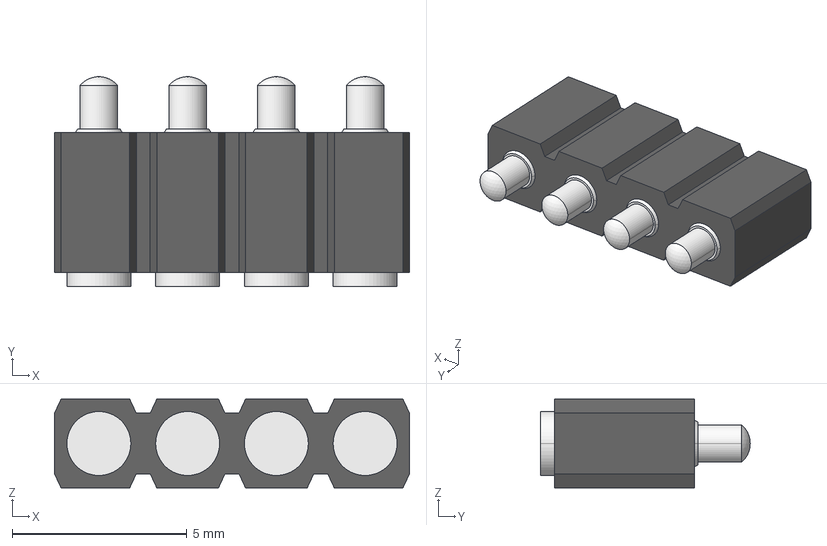
[picture p57: CAD file, 2024-02-19]
3D/slc_connector_811-s1-004-30-014101.stp
10.2 x 6.00 x 2.54 mm
