JitterCompany/KicadComponents/3D/contact_2mm.step

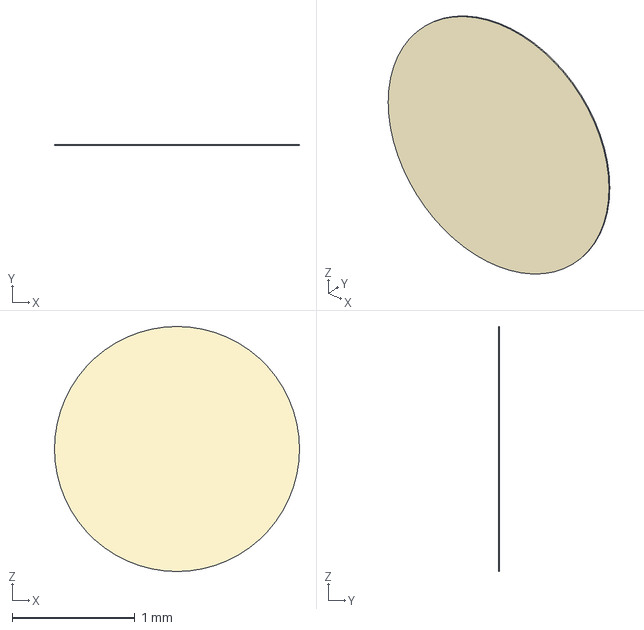
[picture p58: CAD file, 2024-02-19]
3D/contact_2mm.step
2.00 x 0.01 x 2.00 mm
