JitterCompany/KicadComponents/3D/SRP0512.stp

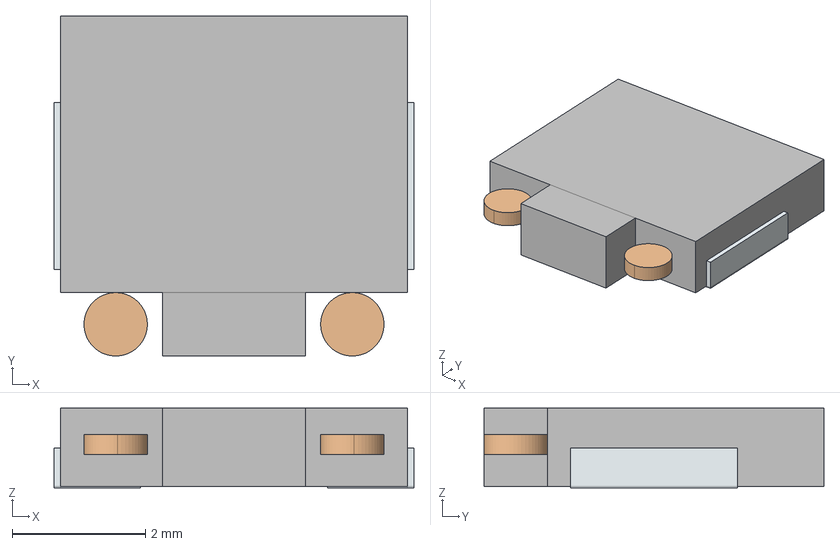
[picture p59: CAD file, 2024-02-02]
3D/SRP0512.stp
5.40 x 5.10 x 1.20 mm
solidBody
solidLead
solidBody1
