JitterCompany/KicadComponents/3D/Laird_BMI-S-202-F.STP

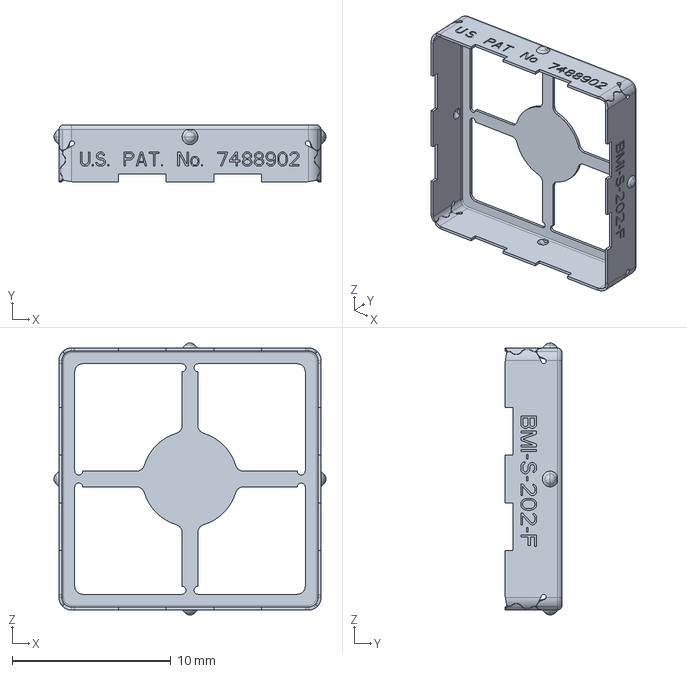
[picture p60: CAD file, 2024-02-02]
3D/Laird_BMI-S-202-F.STP
17.1 x 3.60 x 17.1 mm
