JitterCompany/KicadComponents/3D/TPD6F002DSVR.step

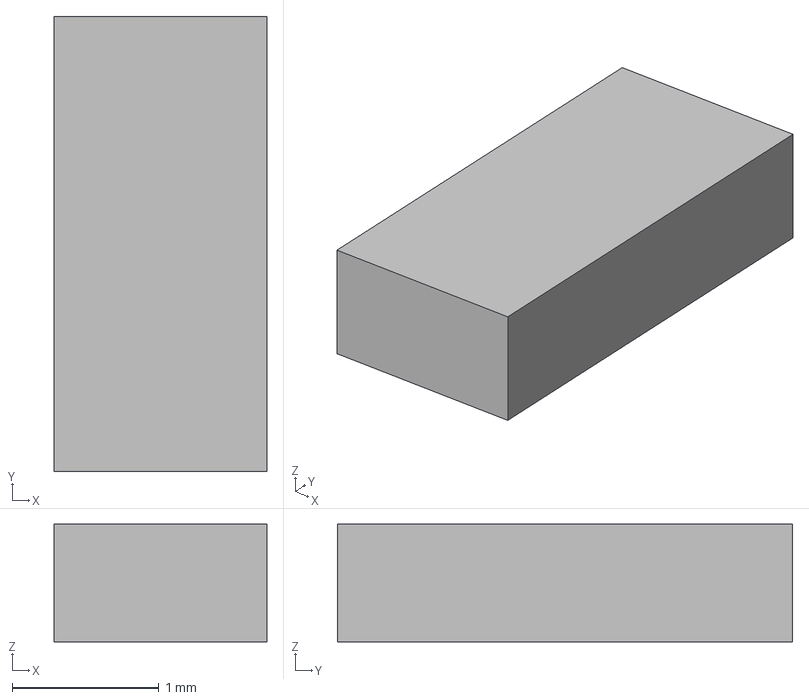
[picture p61: CAD file, 2023-09-15]
3D/TPD6F002DSVR.step
1.45 x 3.10 x 0.8 mm
