JitterCompany/KicadComponents/3D/WSON-12_3x1.35mm_P0.5mm.step

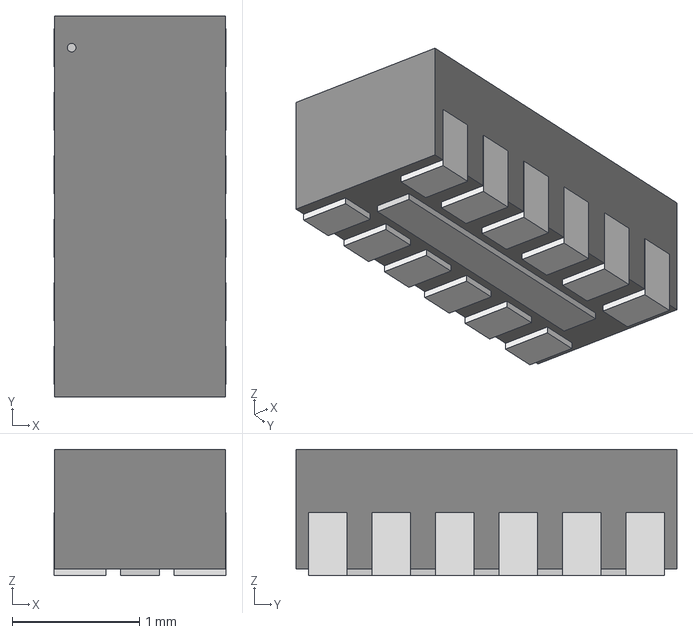
[picture p62: CAD file, 2023-09-15]
3D/WSON-12_3x1.35mm_P0.5mm.step
1.35 x 3.00 x 0.993 mm
