JitterCompany/KicadComponents/3D/vqfn-hr-29.step

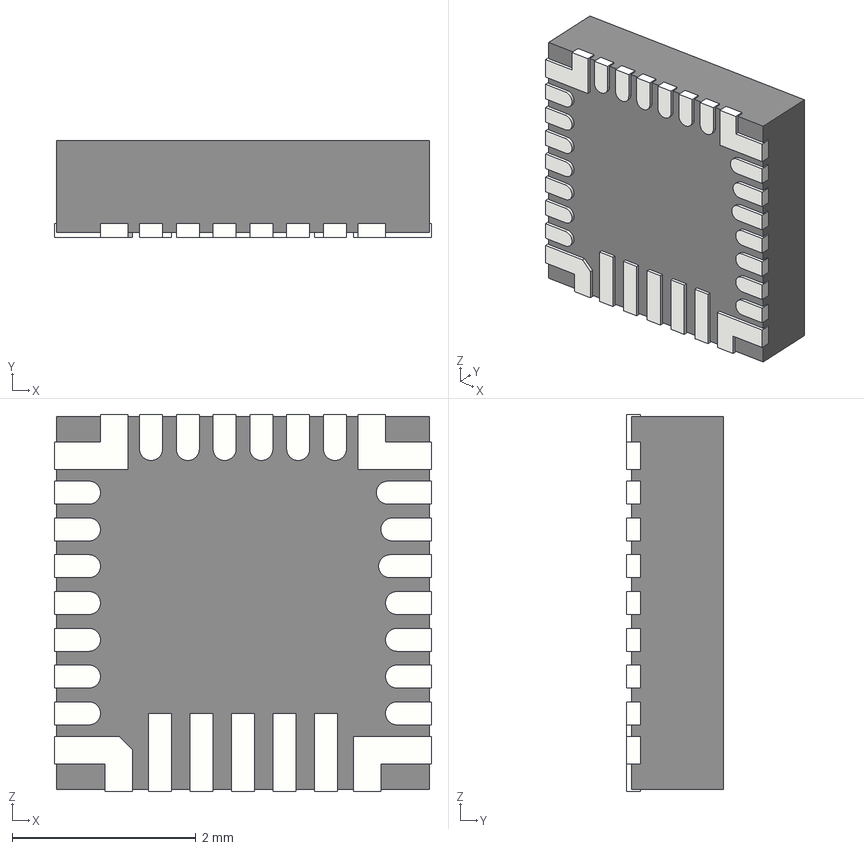
[picture p63: CAD file, 2023-09-11]
3D/vqfn-hr-29.step
4.10 x 1.05 x 4.10 mm
