JitterCompany/KicadComponents/3D/WSON8-8x6.step

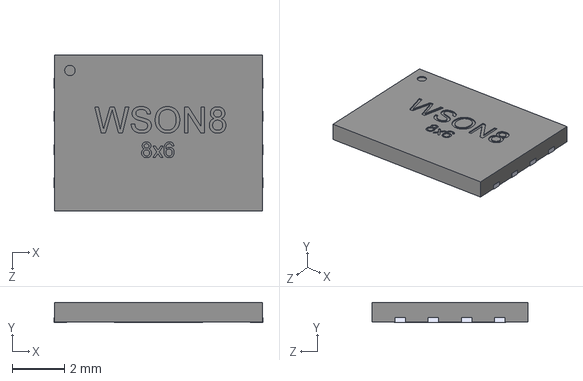
[picture p64: CAD file, 2023-09-11]
3D/WSON8-8x6.step
8.02 x 0.77 x 6.00 mm
