JitterCompany/KicadComponents/3D/Molex_FFC_527461071_1mm_10circuits.stp

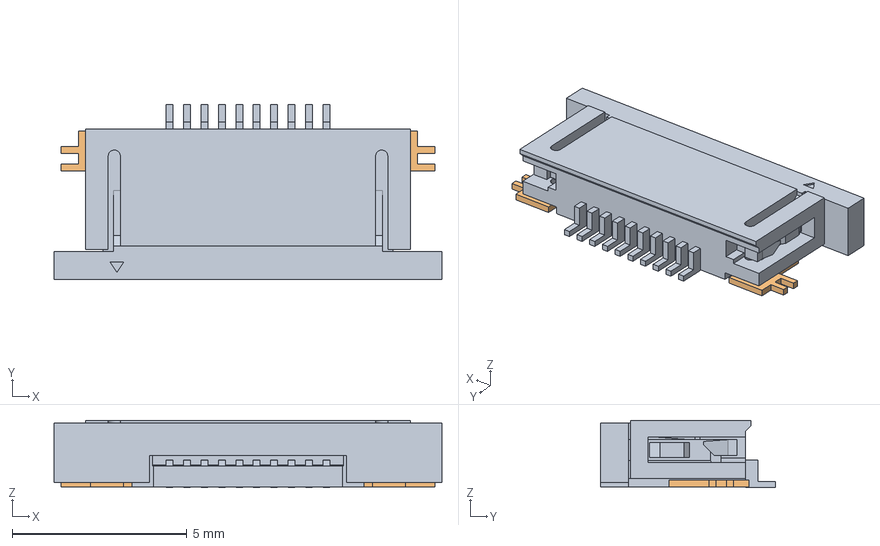
[picture p65: CAD file, 2023-09-11]
3D/Molex_FFC_527461071_1mm_10circuits.stp
11.1 x 5.00 x 1.92 mm
