JitterCompany/KicadComponents/3D/SOT-416.step

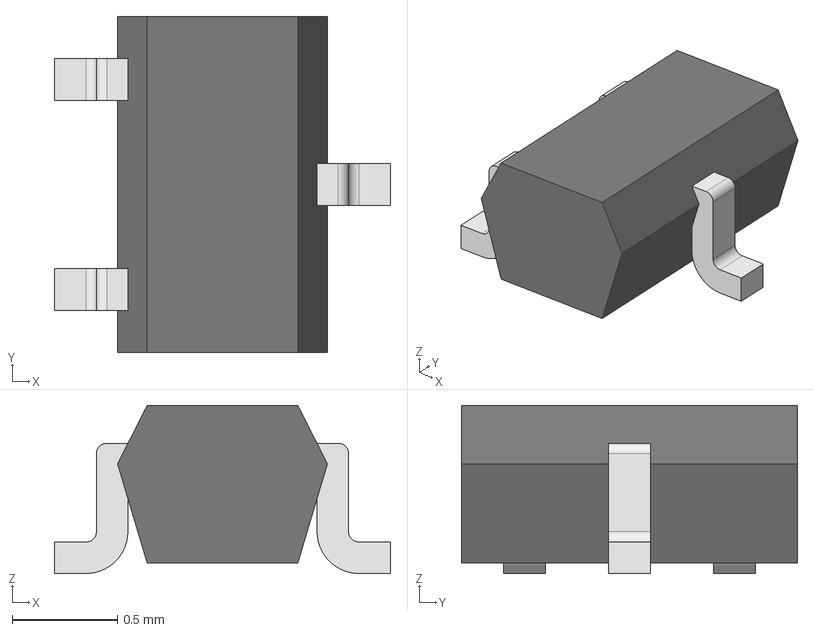
[picture p66: CAD file, 2023-09-11]
3D/SOT-416.step
1.60 x 1.60 x 0.8 mm
