JitterCompany/KicadComponents/3D/Amphenol_FFC_s10051922-1010elf_10circuits_lowprofile.stp

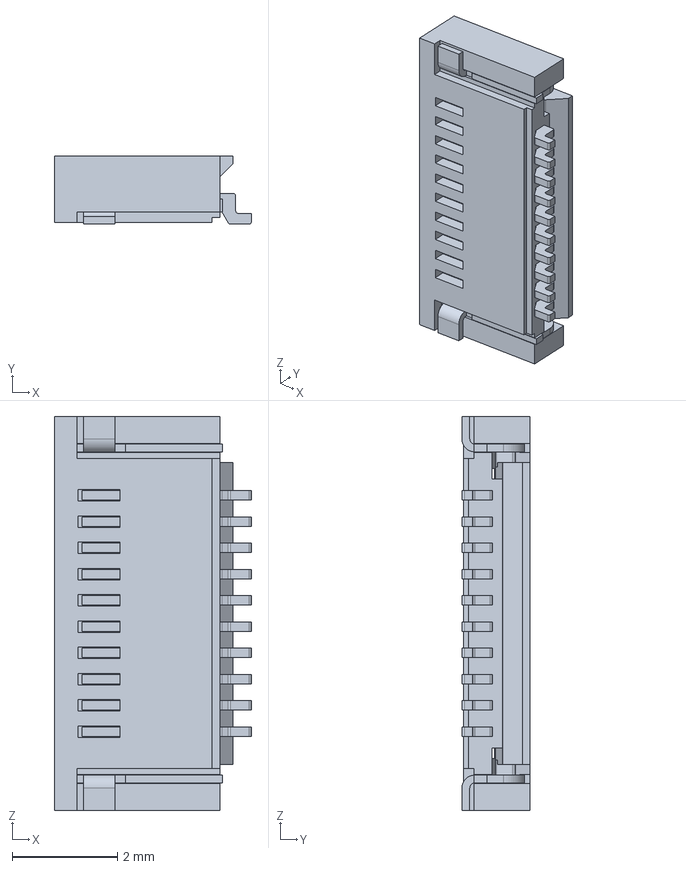
[picture p67: CAD file, 2023-09-11]
3D/Amphenol_FFC_s10051922-1010elf_10circuits_lowprofile.stp
3.75 x 1.30 x 7.50 mm
