JitterCompany/KicadComponents/3D/FH12-30S-0.5SV.stp

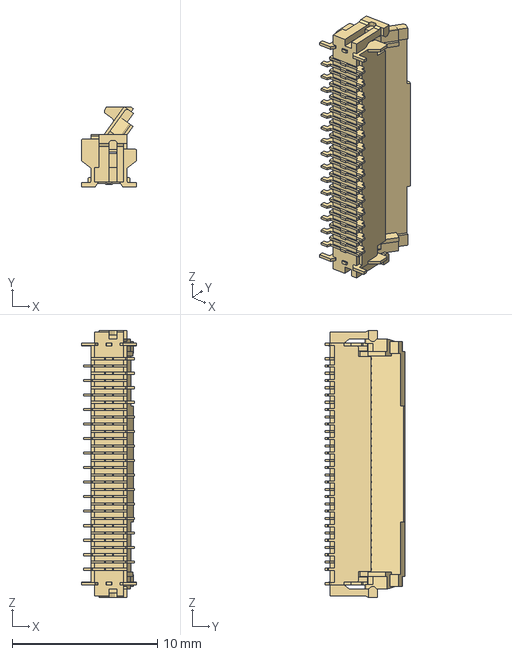
[picture p68: CAD file, 2023-09-11]
3D/FH12-30S-0.5SV.stp
3.80 x 5.50 x 18.4 mm
