JitterCompany/KicadComponents/3D/TE-1717445-6.step

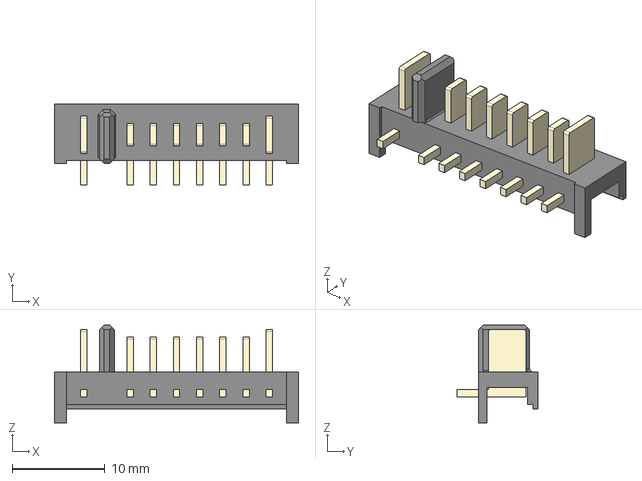
[picture p69: CAD file, 2023-06-01]
3D/TE-1717445-6.step
26.3 x 8.70 x 10.6 mm
