JitterCompany/KicadComponents/3D/Molex_436500304.step

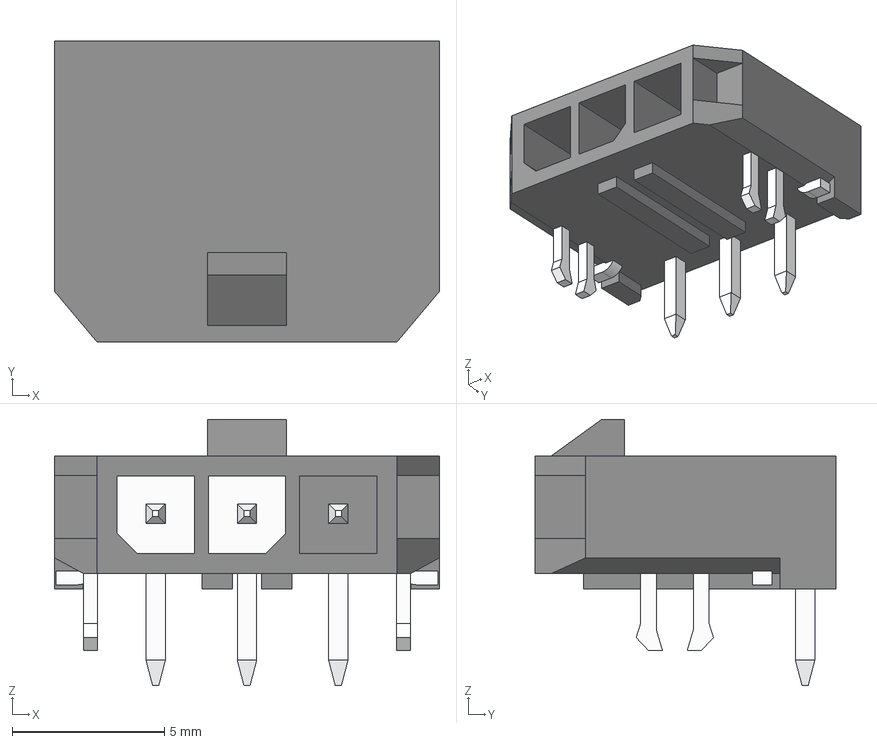
[picture p70: CAD file, 2023-06-01]
3D/Molex_436500304.step
12.7 x 9.90 x 8.75 mm
