JitterCompany/KicadComponents/3D/microSD_Wurth_693071010811.stp

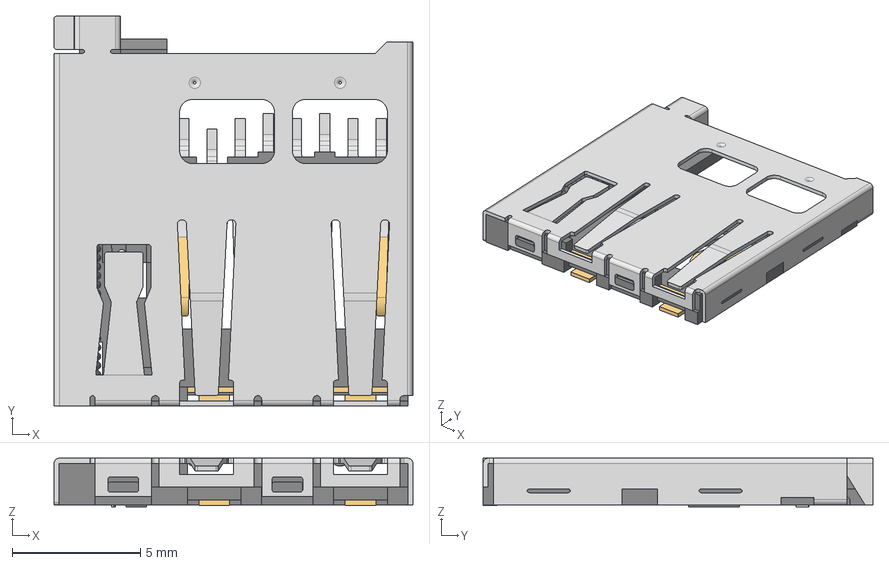
[picture p71: CAD file, 2023-06-01]
3D/microSD_Wurth_693071010811.stp
14.0 x 15.2 x 1.90 mm
693071010811_COULISSEAU
693071010811_CONTACT x 8
693071010811_AGRAPHE
693071010811_RESSORT
693071010811_CACHE
693071010811_LAME
693071010811_MASSE
