JitterCompany/KicadComponents/3D/MicroSD.stp

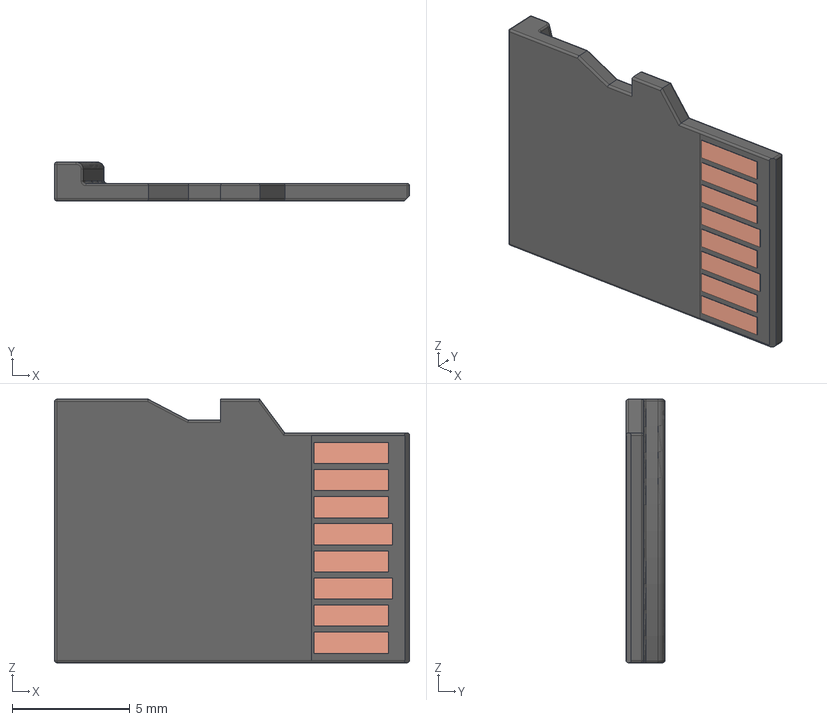
[picture p72: CAD file, 2023-06-01]
3D/MicroSD.stp
15.1 x 1.65 x 11.2 mm
