JitterCompany/KicadComponents/3D/PV2F240xx.stp

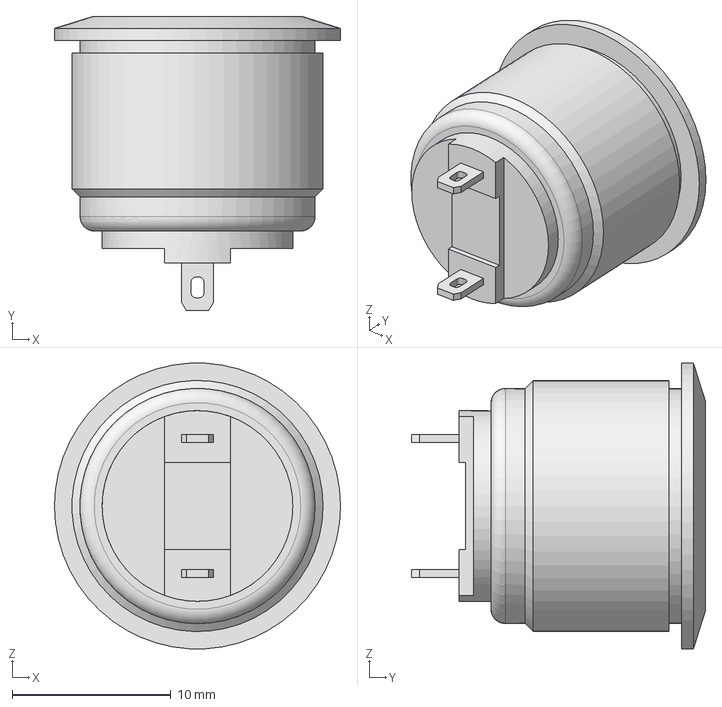
[picture p73: CAD file, 2023-05-31]
3D/PV2F240xx.stp
18.0 x 18.5 x 18.0 mm
