JitterCompany/KicadComponents/3D/harting_0919520X824741.STP

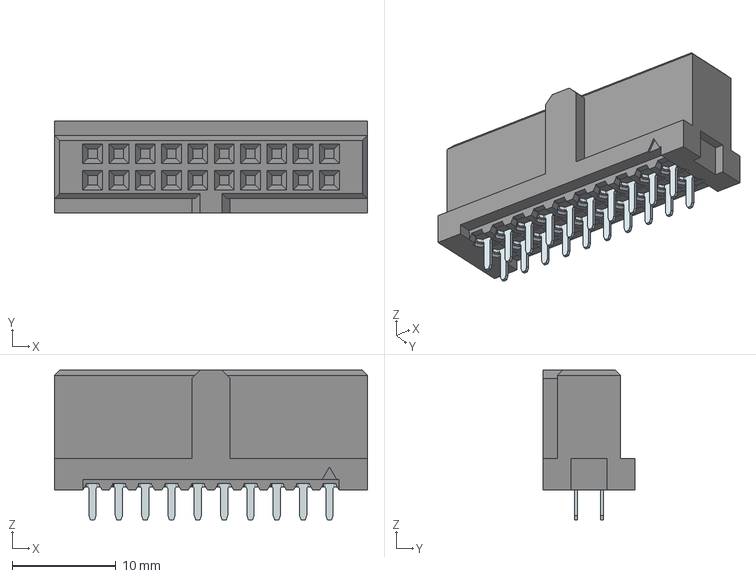
[picture p74: CAD file, 2023-05-31]
3D/harting_0919520X824741.STP
30.2 x 8.90 x 14.5 mm
