JitterCompany/KicadComponents/3D/Harting_09185206324.STP

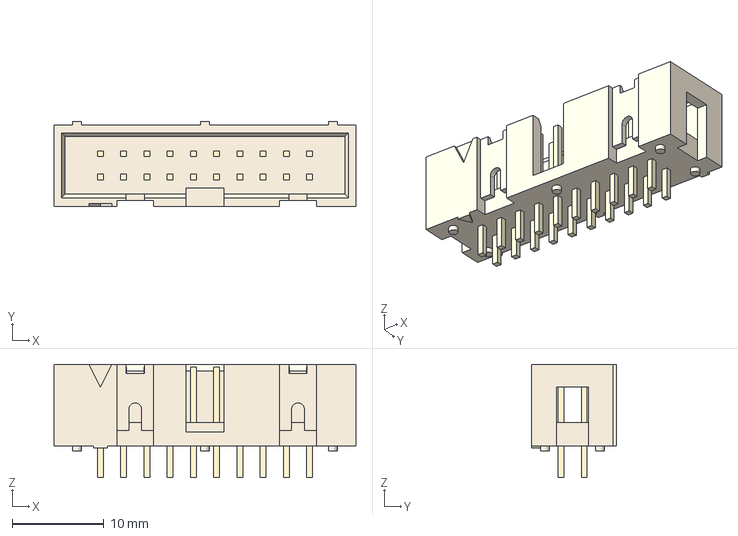
[picture p75: CAD file, 2023-05-31]
3D/Harting_09185206324.STP
33.0 x 9.30 x 12.3 mm
