JitterCompany/KicadComponents/3D/Harting_09185066324.STP

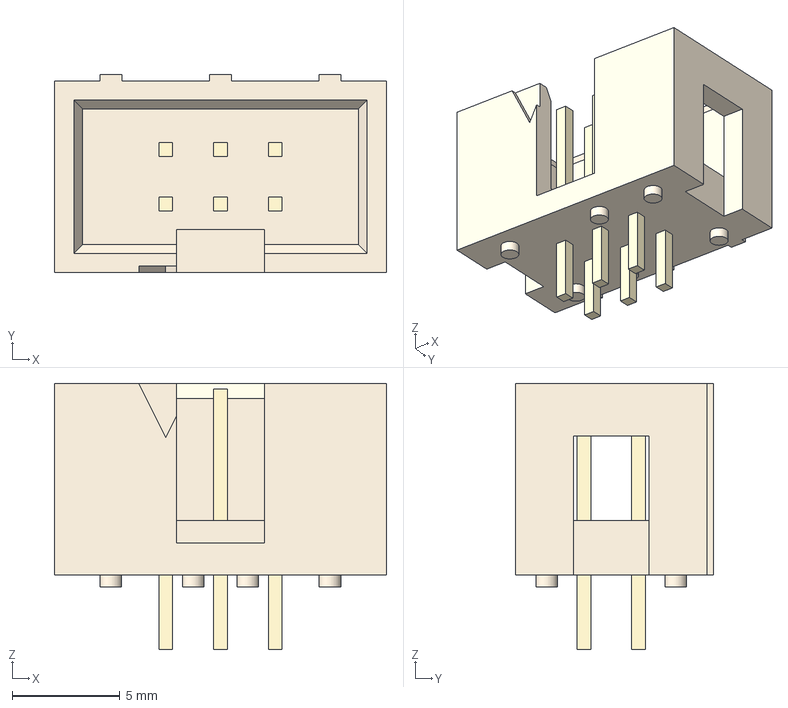
[picture p76: CAD file, 2023-05-31]
3D/Harting_09185066324.STP
15.4 x 9.20 x 12.3 mm
