JitterCompany/KicadComponents/3D/keystone_54_batteryclip_18650.step

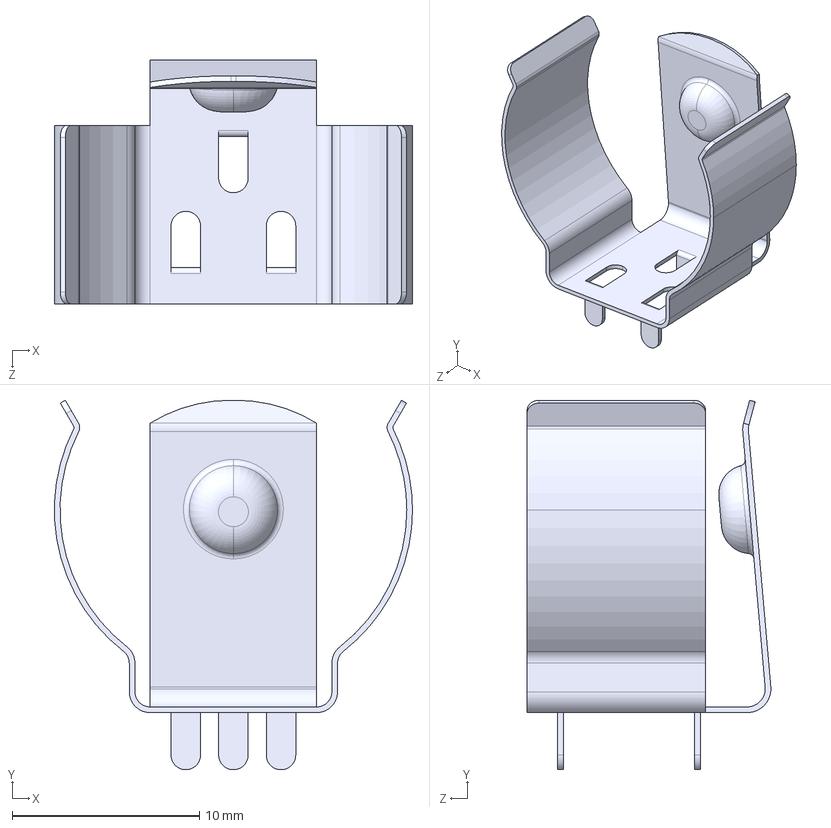
[picture p77: CAD file, 2023-05-12]
3D/keystone_54_batteryclip_18650.step
19.1 x 19.7 x 13.0 mm
