JitterCompany/KicadComponents/3D/keystone_57_re_preloaded.step

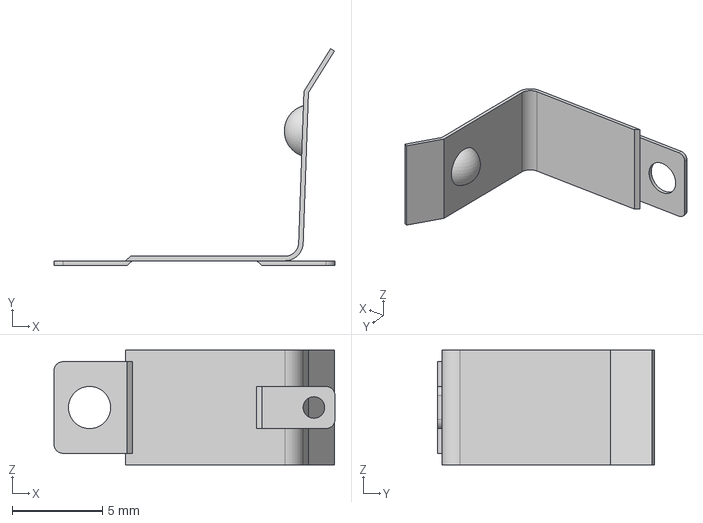
[picture p78: CAD file, 2023-05-12]
3D/keystone_57_re_preloaded.step
15.6 x 12.0 x 6.35 mm
