JitterCompany/KicadComponents/3D/FH12-30S-0.5SH.stp

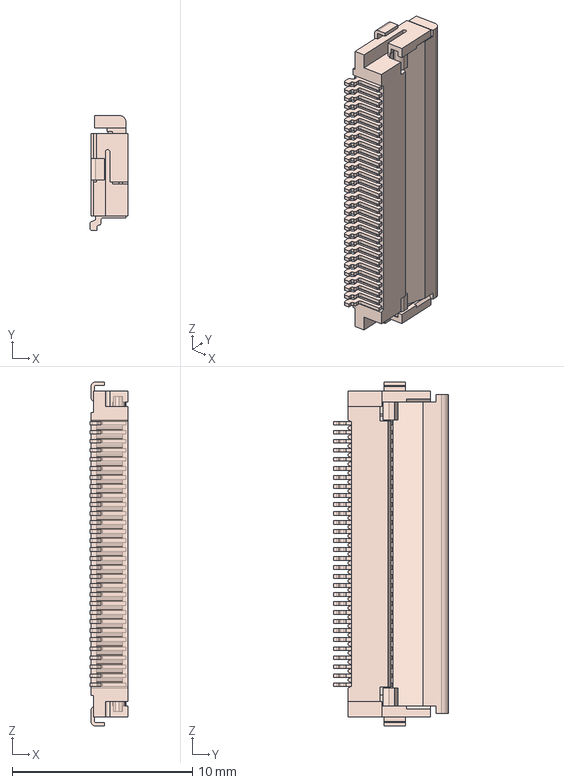
[picture p79: CAD file, 2023-05-12]
3D/FH12-30S-0.5SH.stp
2.10 x 6.40 x 19.1 mm
