JitterCompany/KicadComponents/3D/SIM8060-6-1-14-00-A.stp

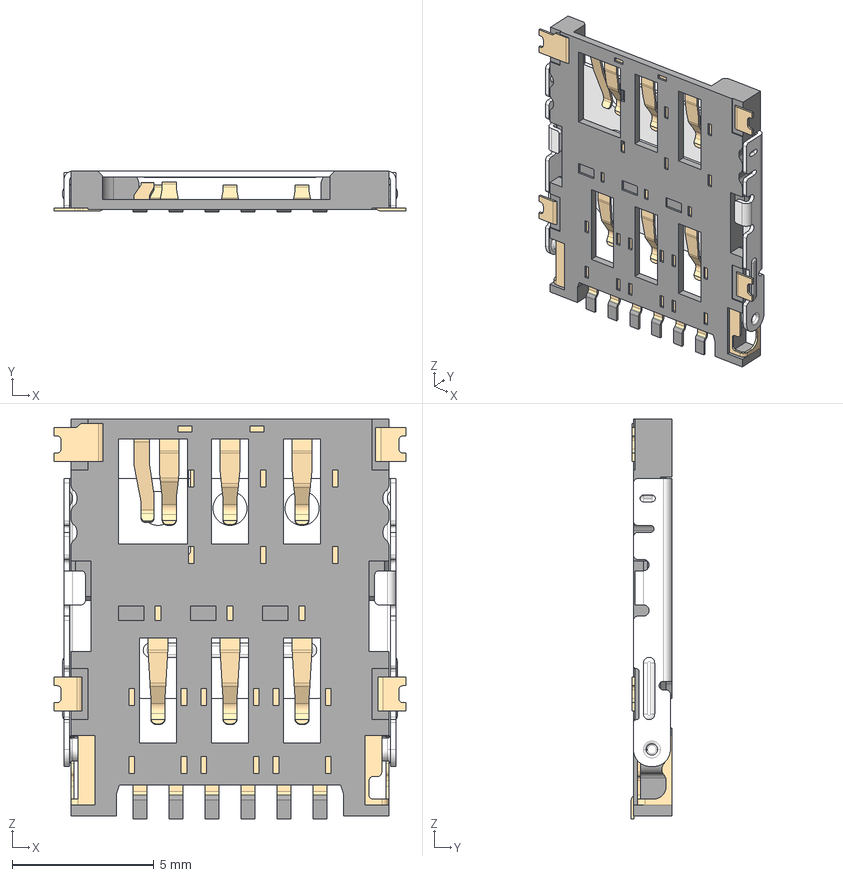
[picture p80: CAD file, 2023-02-02]
3D/SIM8060-6-1-14-00-A.stp
12.4 x 1.43 x 14.1 mm
SIM8060-6-1-14-00-A_PART2
SIM8060-6-1-14-00-A_PART1
