JitterCompany/KicadComponents/3D/relay_CUI__PR24-24V-900-1C.step

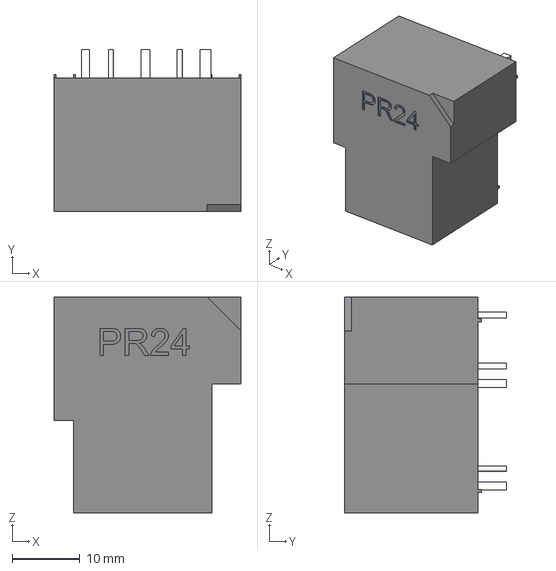
[picture p81: CAD file, 2023-02-02]
3D/relay_CUI__PR24-24V-900-1C.step
27.7 x 24.0 x 32.0 mm
