JitterCompany/KicadComponents/3D/Stocko_MKS_1853-6-0-303_1x3_P2.50mm_Vertical.step

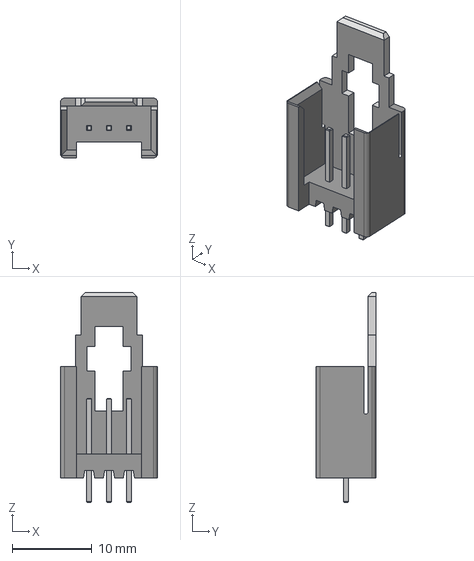
[picture p82: CAD file, 2023-02-02]
3D/Stocko_MKS_1853-6-0-303_1x3_P2.50mm_Vertical.step
12.2 x 7.50 x 26.4 mm
