JitterCompany/KicadComponents/3D/molex_705430003.stp

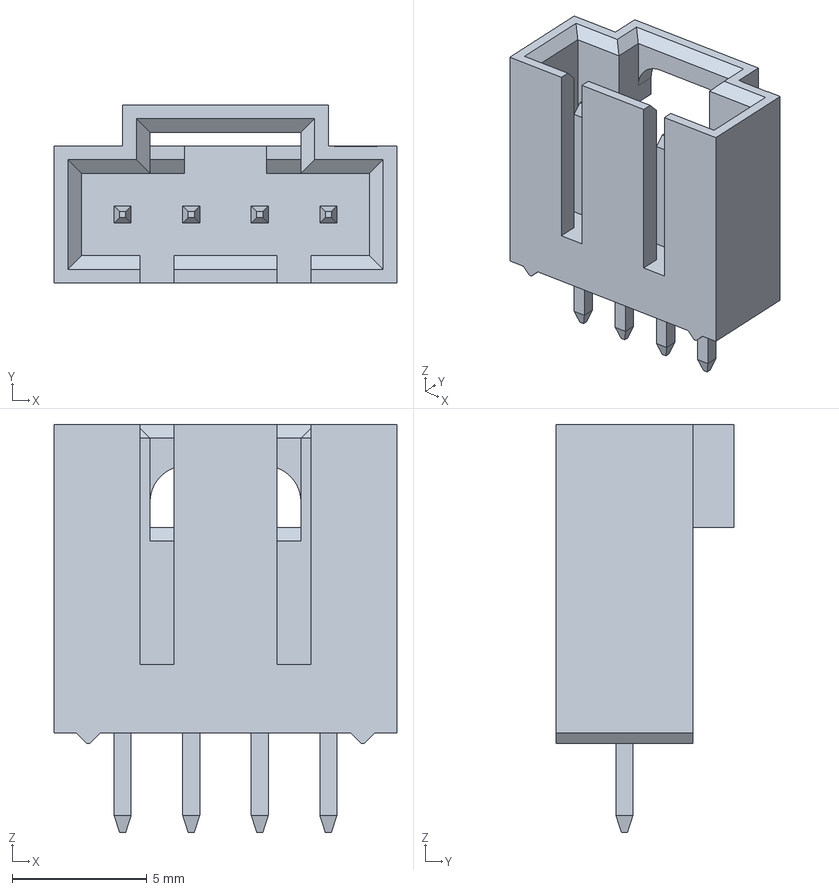
[picture p83: CAD file, 2023-02-02]
3D/molex_705430003.stp
12.7 x 6.60 x 15.1 mm
