JitterCompany/KicadComponents/3D/TE_8-188275-4.step

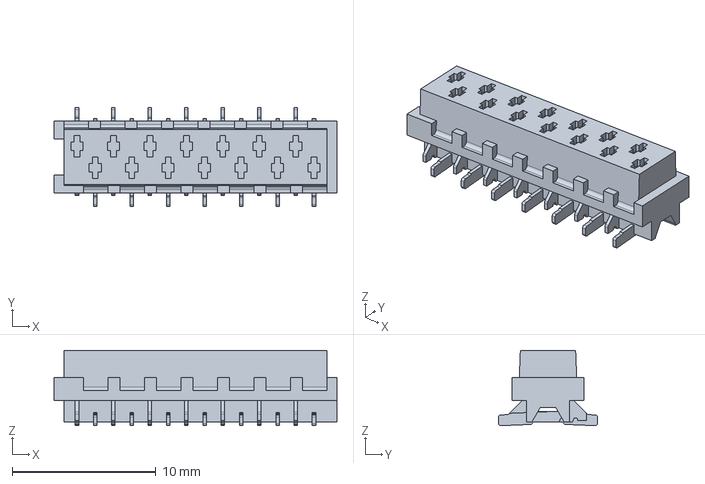
[picture p84: CAD file, 2023-02-02]
3D/TE_8-188275-4.step
19.7 x 6.90 x 5.25 mm
