JitterCompany/KicadComponents/3D/TE_640456-8.step

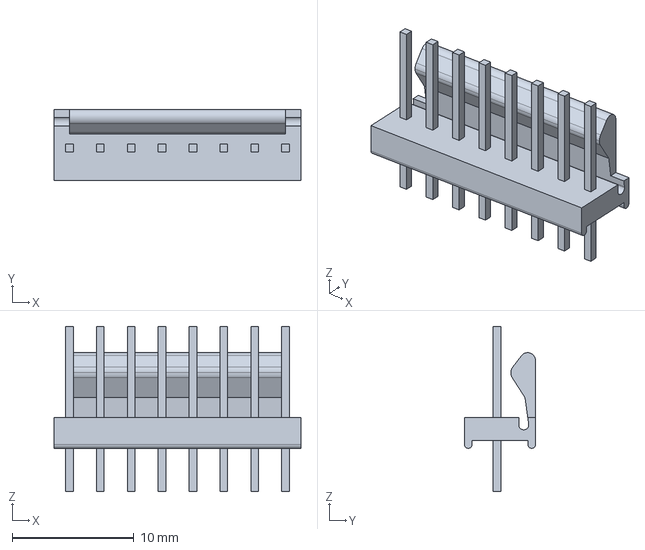
[picture p85: CAD file, 2023-02-02]
3D/TE_640456-8.step
20.3 x 5.84 x 13.6 mm
