JitterCompany/KicadComponents/3D/WE-TPC_5828.stp

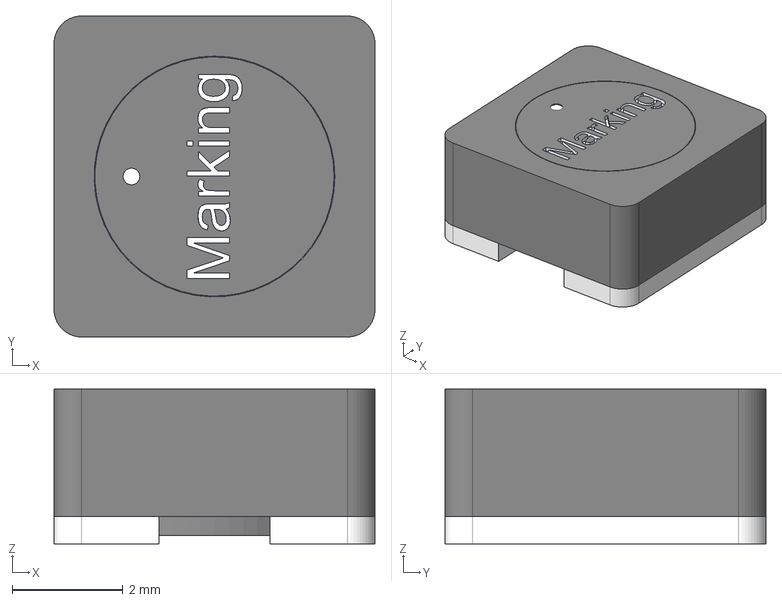
[picture p86: CAD file, 2023-02-02]
3D/WE-TPC_5828.stp
5.80 x 5.80 x 2.80 mm
