JitterCompany/KicadComponents/3D/ADS1284IRHFT.stp

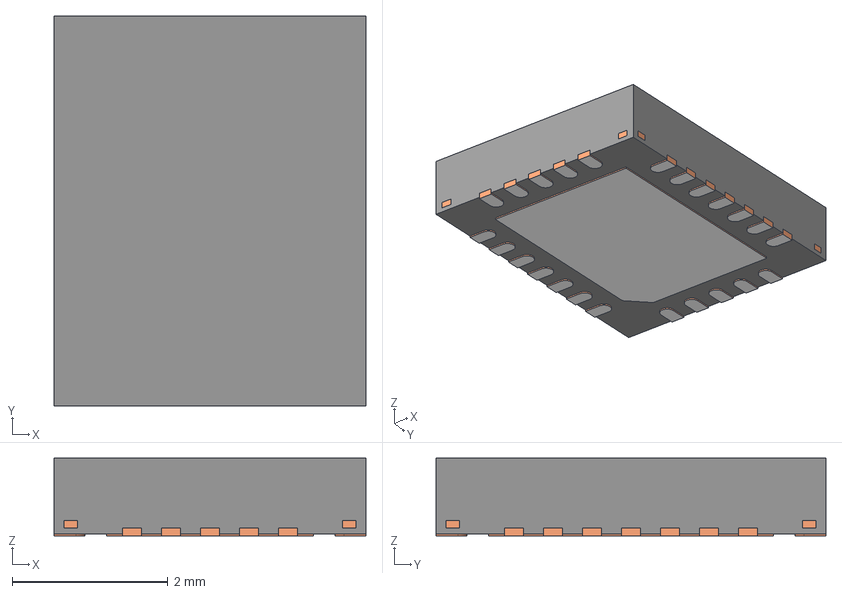
[picture p87: CAD file, 2022-12-05]
3D/ADS1284IRHFT.stp
4.00 x 5.00 x 1.00 mm
BODY-QFN
FRAME-RHF0024A
PIN1-ID
