JitterCompany/KicadComponents/3D/SN74LV125AD.step

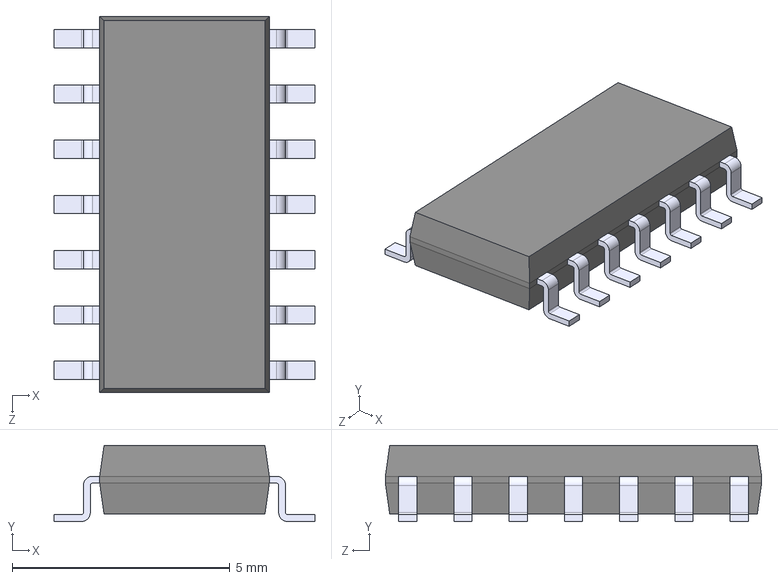
[picture p88: CAD file, 2022-12-05]
3D/SN74LV125AD.step
6.00 x 1.75 x 8.65 mm
