JitterCompany/KicadComponents/3D/SI1003.stp

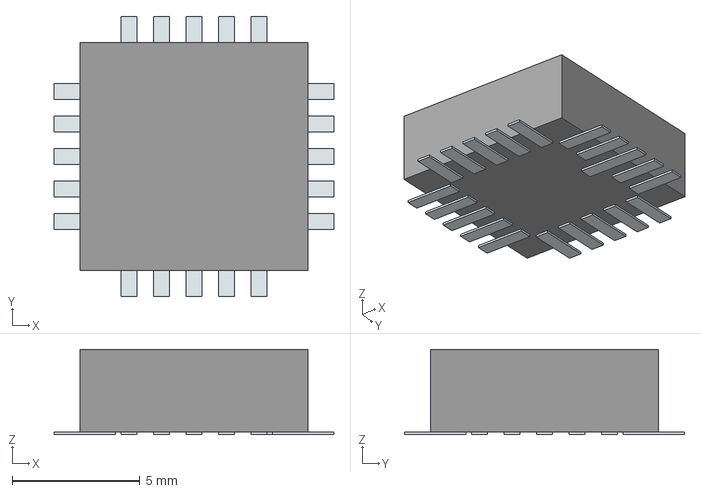
[picture p89: CAD file, 2022-12-05]
3D/SI1003.stp
10.9 x 10.9 x 3.34 mm
Pins
