JitterCompany/KicadComponents/3D/keystone_254_batteryclip_18650.STEP

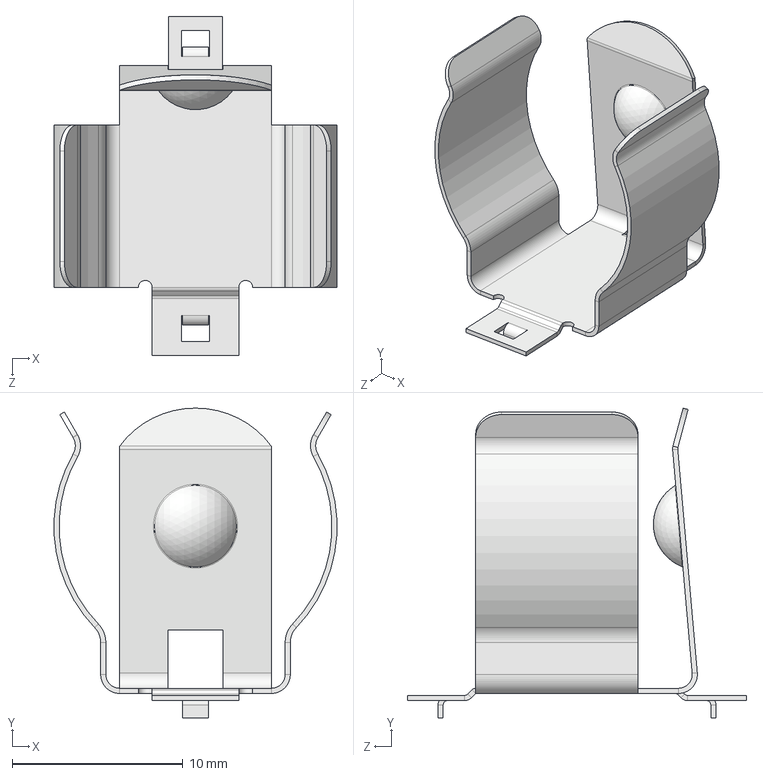
[picture p90: CAD file, 2022-09-07]
3D/keystone_254_batteryclip_18650.STEP
16.6 x 18.2 x 19.9 mm
