JitterCompany/KicadComponents/3D/MRJ-5381-M1.step

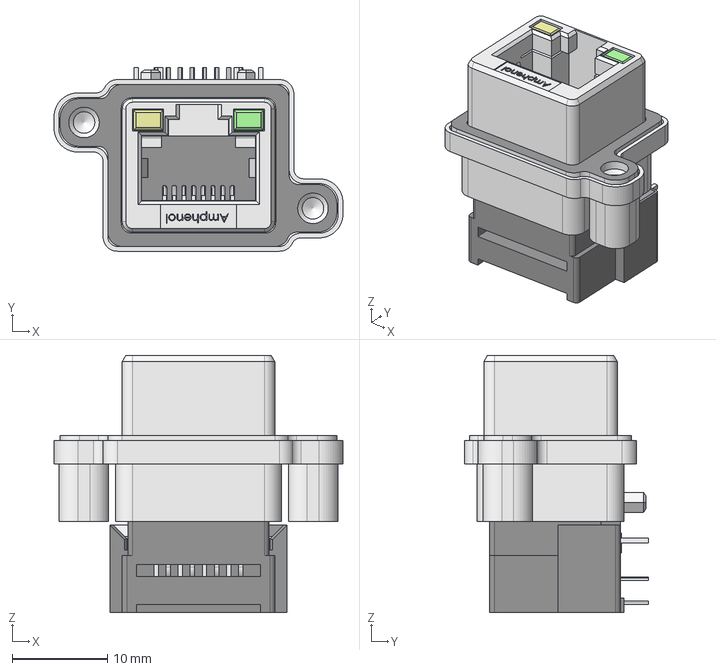
[picture p91: CAD file, 2022-09-07]
3D/MRJ-5381-M1.step
30.3 x 19.2 x 27.0 mm
