JitterCompany/KicadComponents/3D/DLM0NSN900HY2D_choke.STEP

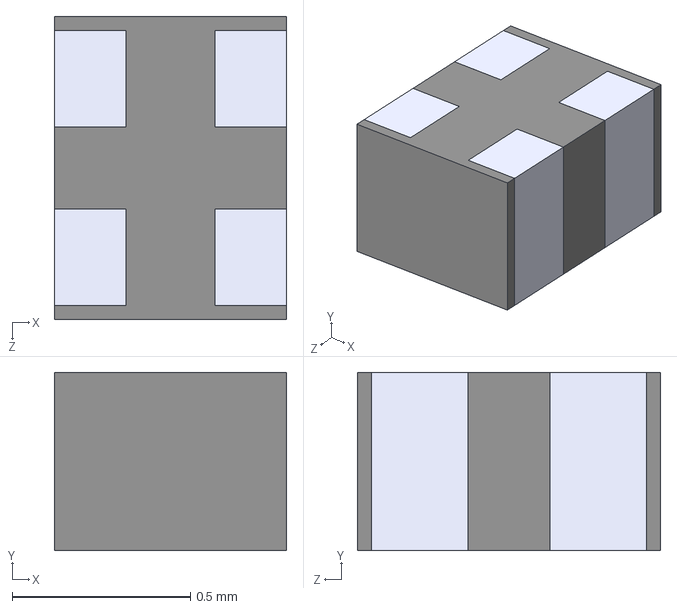
[picture p92: CAD file, 2022-09-07]
3D/DLM0NSN900HY2D_choke.STEP
0.65 x 0.5 x 0.85 mm
