JitterCompany/KicadComponents/3D/TE-1717478-1.stp

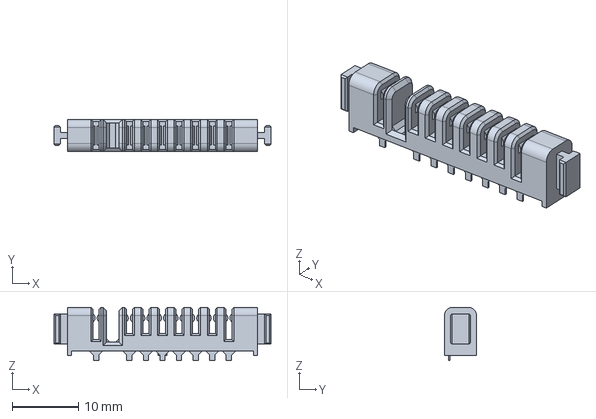
[picture p93: CAD file, 2022-09-07]
3D/TE-1717478-1.stp
32.7 x 4.80 x 8.05 mm
