JitterCompany/KicadComponents/3D/tdfn8-1.5x2.step

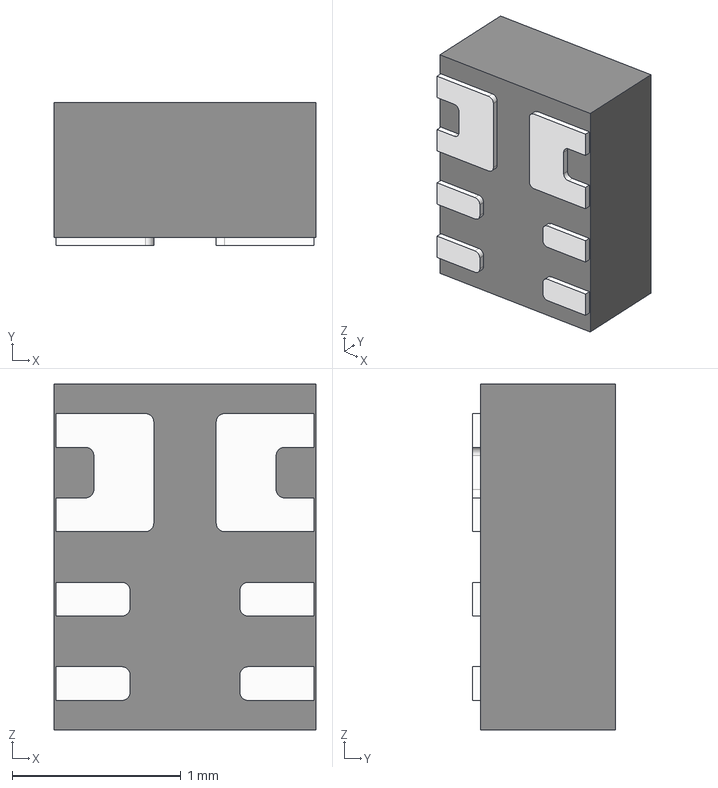
[picture p94: CAD file, 2022-07-07]
3D/tdfn8-1.5x2.step
1.55 x 0.85 x 2.05 mm
