JitterCompany/KicadComponents/3D/CUI_V78E05-500-SMT.step

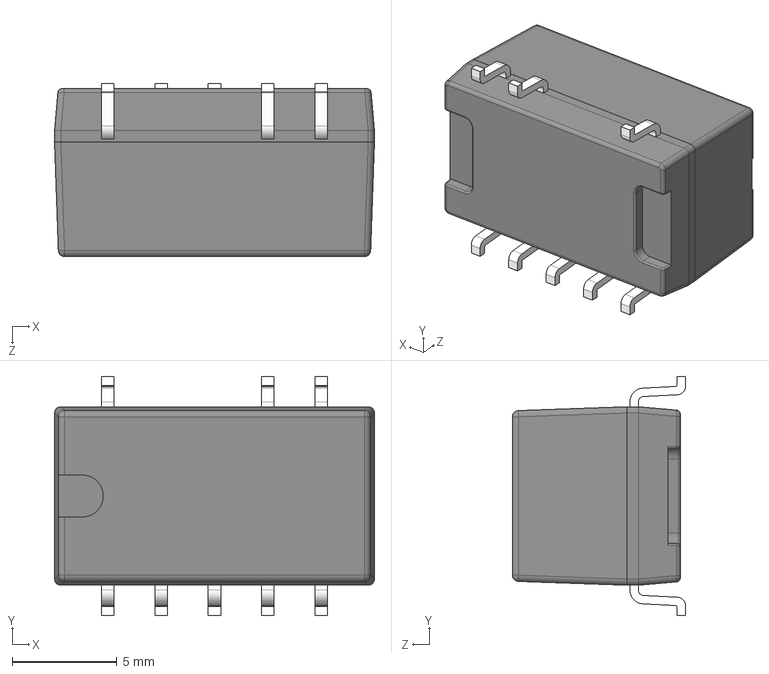
[picture p95: CAD file, 2022-07-07]
3D/CUI_V78E05-500-SMT.step
15.2 x 11.4 x 8.25 mm
