JitterCompany/KicadComponents/3D/Transformer_Ethernet_Wuerth_749020100A.stp

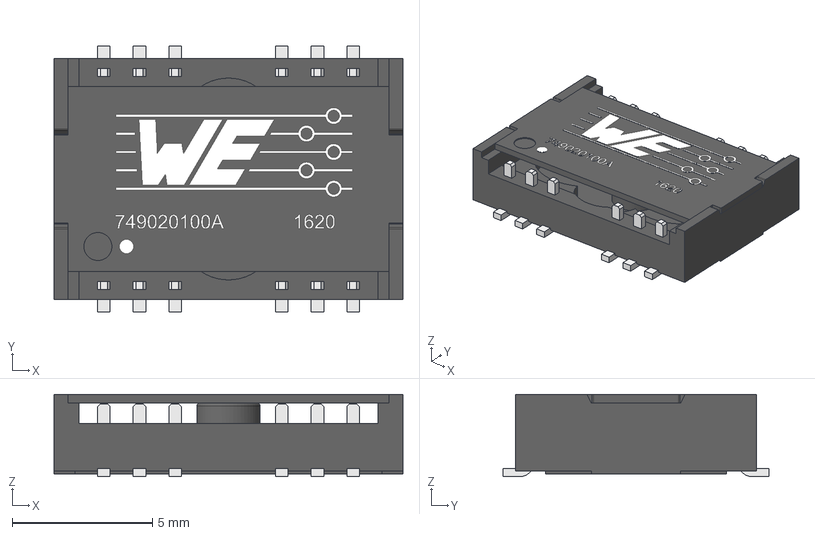
[picture p96: CAD file, 2022-07-07]
3D/Transformer_Ethernet_Wuerth_749020100A.stp
12.5 x 9.50 x 2.94 mm
Pins
Housing
Cover
