JitterCompany/KicadComponents/3D/WE-LHMI_8040.stp

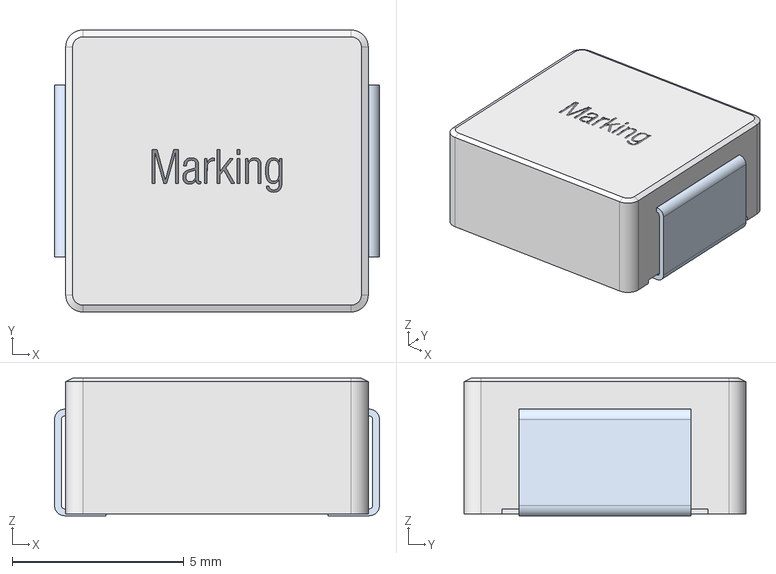
[picture p97: CAD file, 2022-07-07]
3D/WE-LHMI_8040.stp
9.45 x 8.20 x 4.00 mm
base
pin
