JitterCompany/KicadComponents/3D/WE-CNSW_0805_CNSW.stp

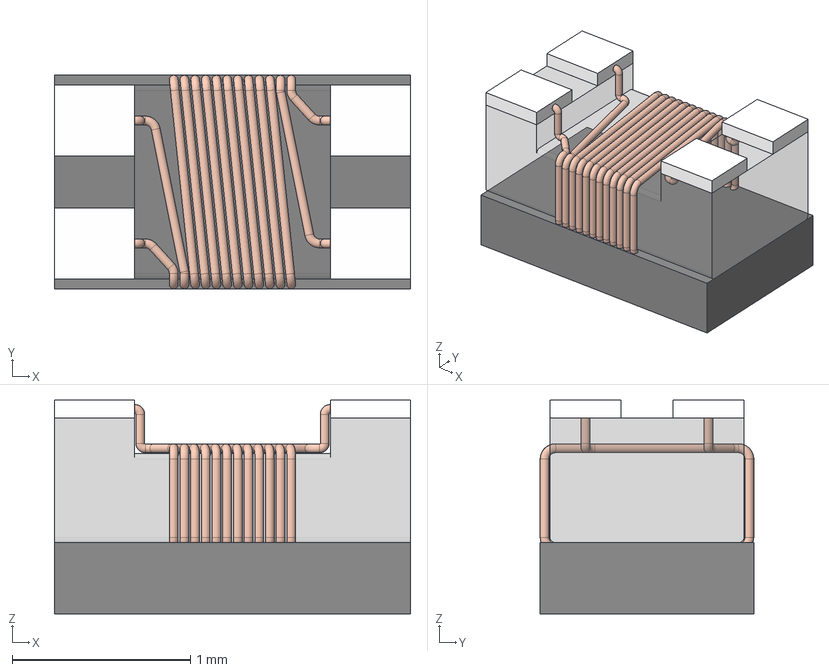
[picture p98: CAD file, 2022-04-29]
3D/WE-CNSW_0805_CNSW.stp
2.00 x 1.20 x 1.20 mm
Gehäuse
Boden
L飆fl踄he x 4
