JitterCompany/KicadComponents/3D/TE_T4141012051-000.stp

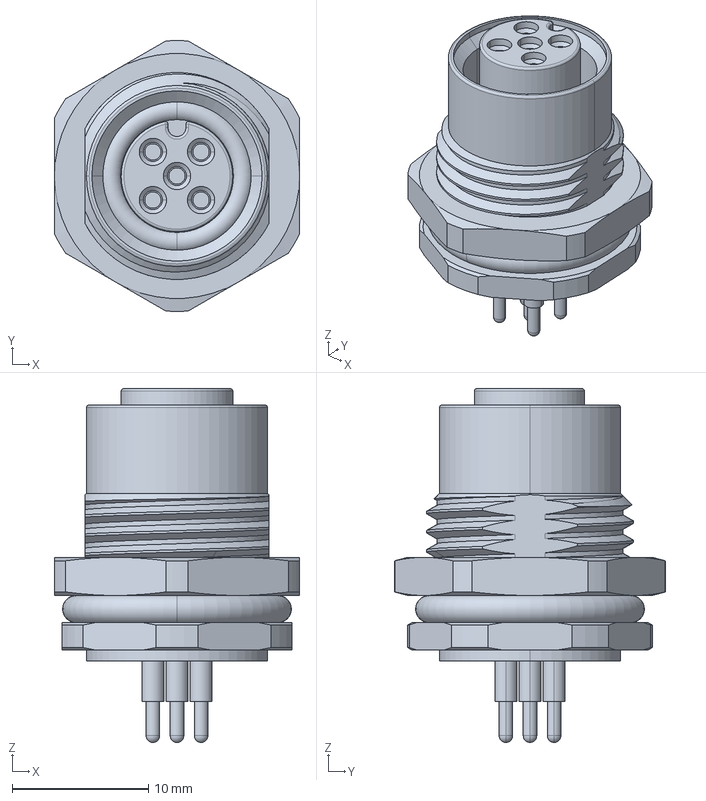
[picture p99: CAD file, 2022-04-29]
3D/TE_T4141012051-000.stp
18.0 x 19.9 x 26.0 mm
