JitterCompany/KicadComponents/3D/TBU-DFxxx.STP

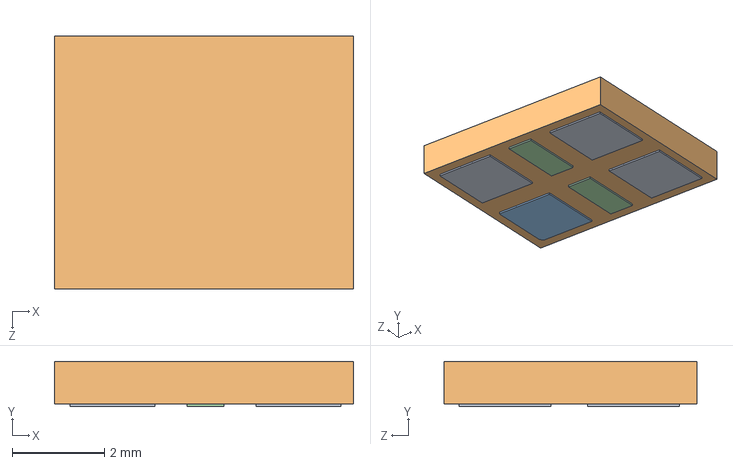
[picture p100: CAD file, 2022-04-29]
3D/TBU-DFxxx.STP
6.50 x 0.98 x 5.50 mm
