JitterCompany/KicadComponents/3D/B8PS-VH.STEP

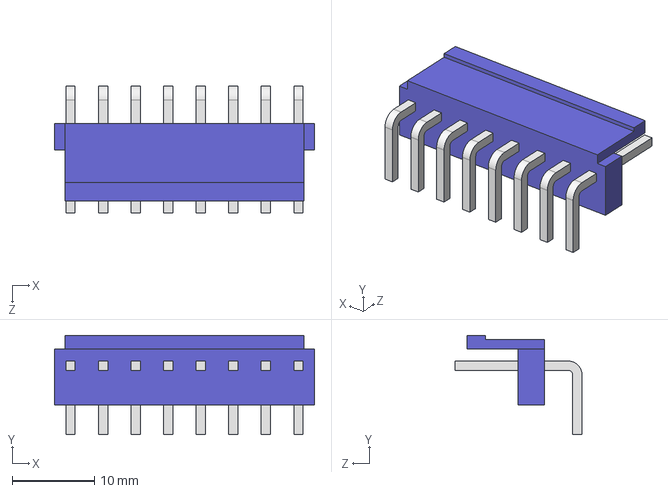
[picture p101: CAD file, 2022-04-29]
3D/B8PS-VH.STEP
31.6 x 12.1 x 15.5 mm
