JitterCompany/KicadComponents/3D/mf-r400.stp

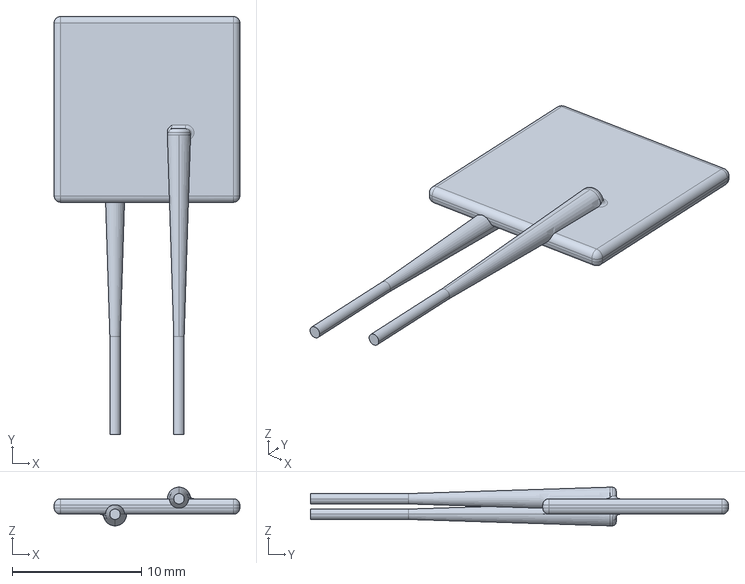
[picture p102: CAD file, 2022-04-29]
3D/mf-r400.stp
14.4 x 32.4 x 3.00 mm
