JitterCompany/KicadComponents/3D/Crystal_SMD5032.step

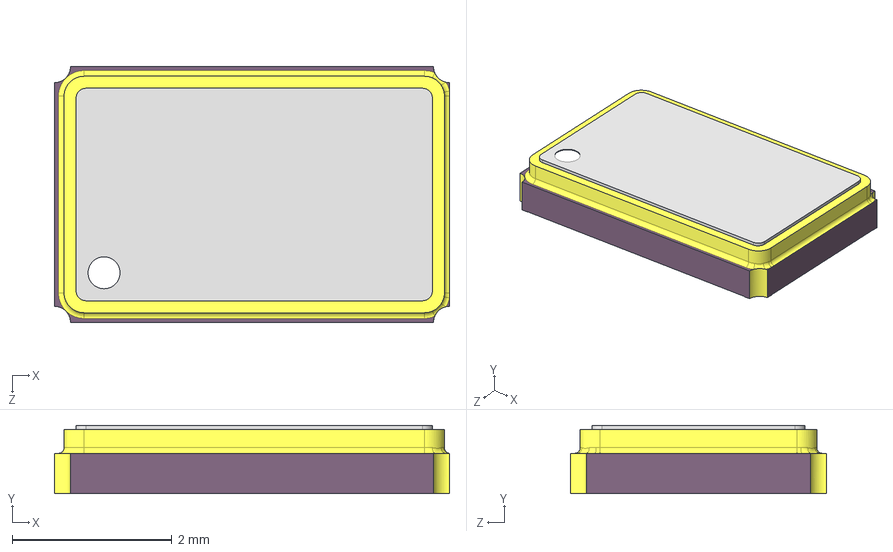
[picture p103: CAD file, 2022-04-29]
3D/Crystal_SMD5032.step
4.94 x 0.855 x 3.20 mm
