JitterCompany/KicadComponents/3D/WE-WL-SBRW-1205.stp

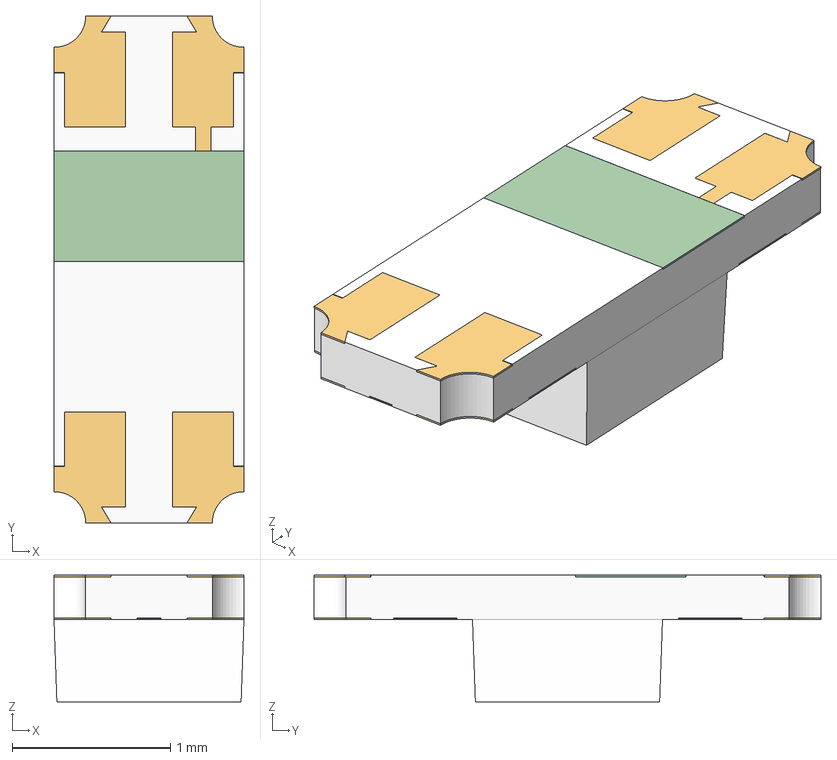
[picture p104: CAD file, 2022-02-28]
3D/WE-WL-SBRW-1205.stp
1.20 x 3.20 x 0.8 mm
Pins_top x 5
Pins_Bottom x 4
