JitterCompany/KicadComponents/3D/PTSM_0.5_8-HH0-2.5-SMD.STEP

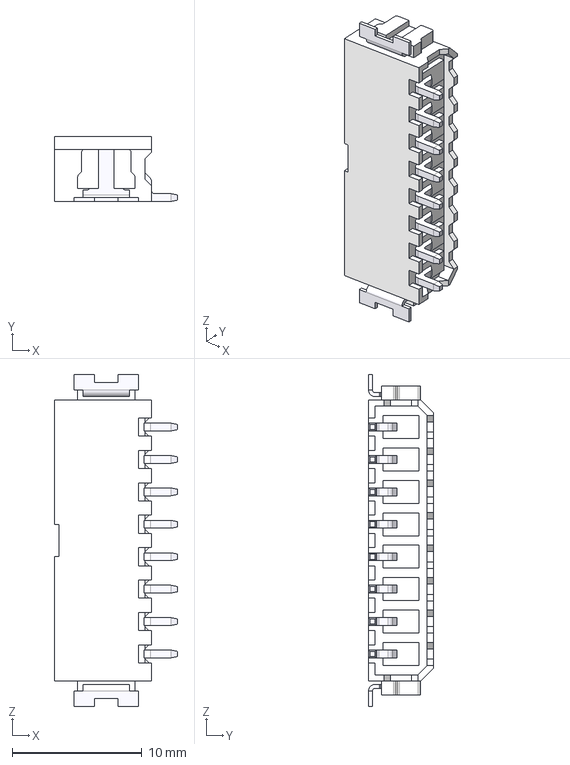
[picture p105: CAD file, 2022-02-28]
3D/PTSM_0.5_8-HH0-2.5-SMD.STEP
9.50 x 5.00 x 25.6 mm
