JitterCompany/KicadComponents/3D/jst-b4b-xh-a-1.step

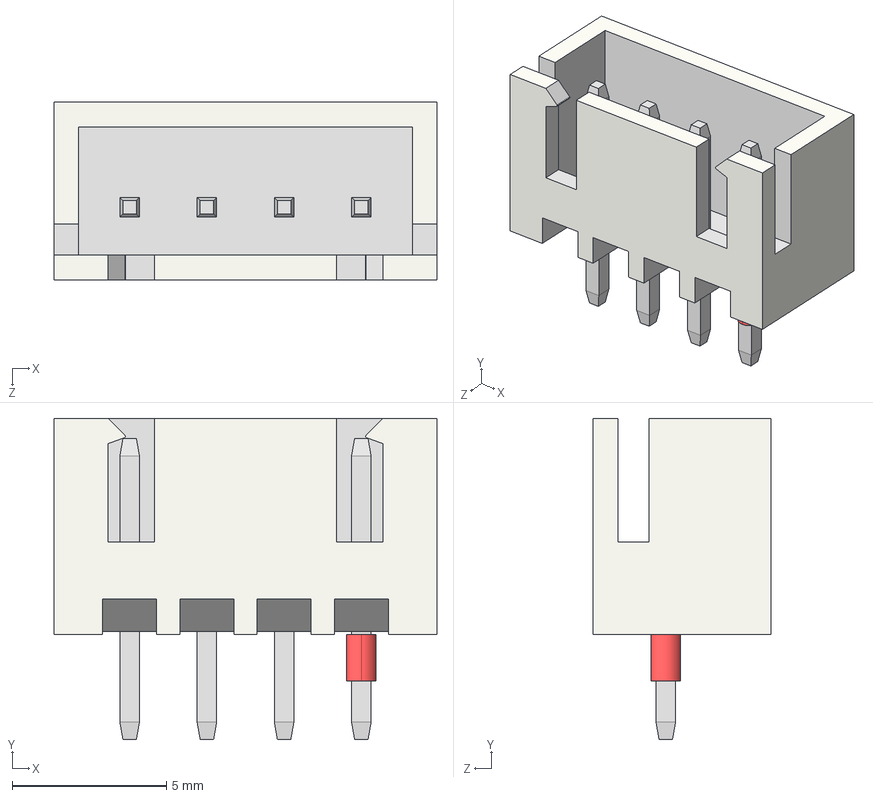
[picture p106: CAD file, 2022-02-28]
3D/jst-b4b-xh-a-1.step
12.4 x 10.4 x 5.75 mm
