JitterCompany/KicadComponents/3D/B10B-PH-SM4-TB.STEP

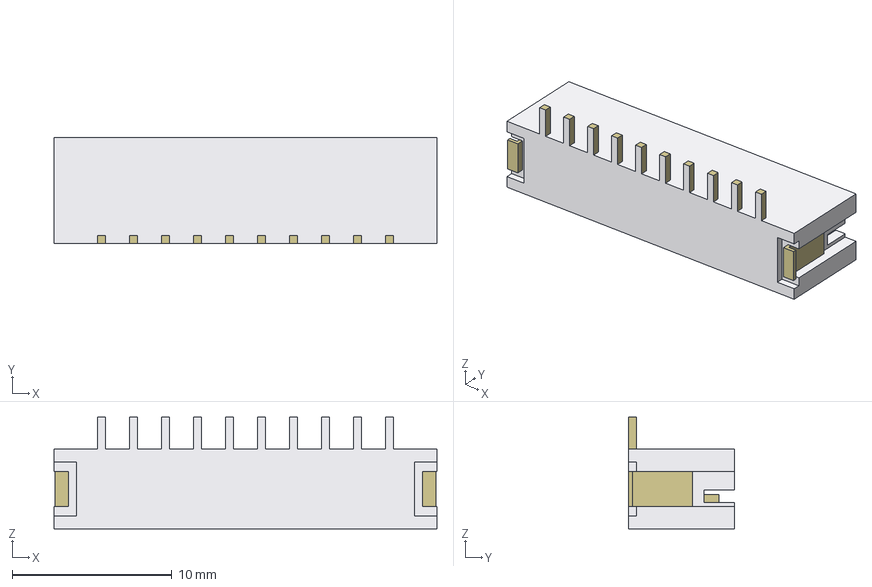
[picture p107: CAD file, 2022-02-28]
3D/B10B-PH-SM4-TB.STEP
24.0 x 6.60 x 7.00 mm
