JitterCompany/KicadComponents/3D/Honeywell_ABP2-L-SN_SMT_leadles.step

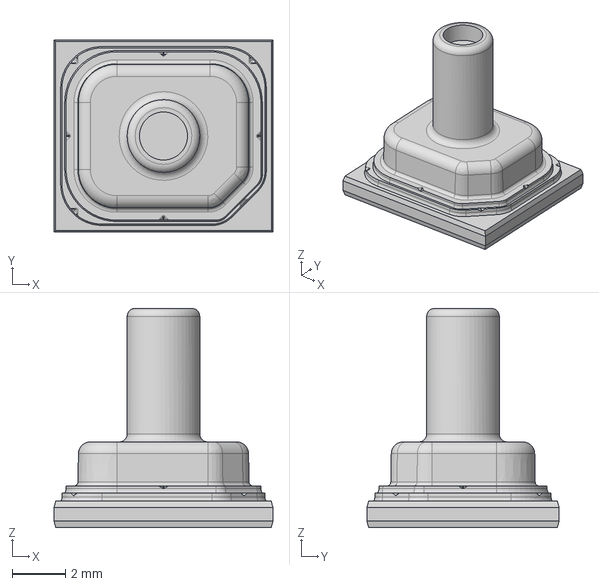
[picture p108: CAD file, 2021-11-19]
3D/Honeywell_ABP2-L-SN_SMT_leadles.step
8.20 x 7.20 x 8.21 mm
