JitterCompany/KicadComponents/3D/Honeywell_ABP2-RR_SMT.step

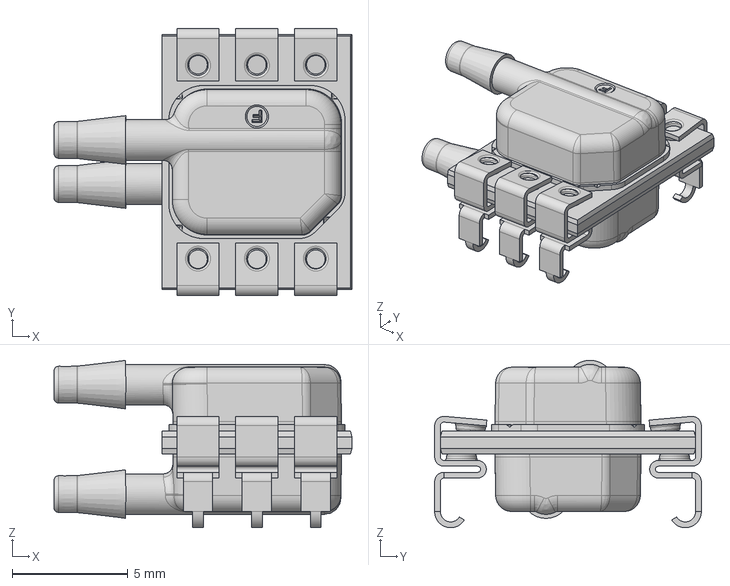
[picture p109: CAD file, 2021-11-19]
3D/Honeywell_ABP2-RR_SMT.step
12.8 x 11.5 x 7.22 mm
