JitterCompany/KicadComponents/3D/CONEC_43-01197.stp

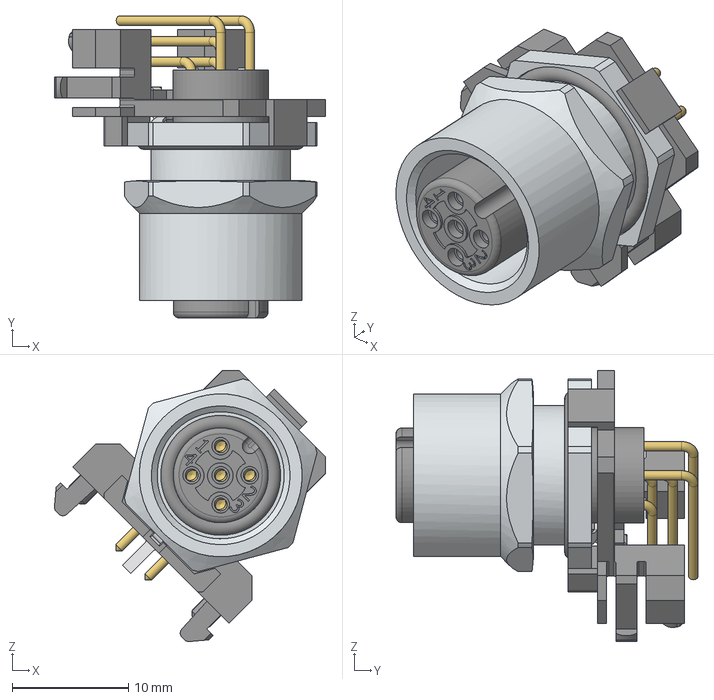
[picture p110: CAD file, 2021-11-19]
3D/CONEC_43-01197.stp
23.3 x 26.0 x 23.3 mm
