JitterCompany/KicadComponents/3D/WE-MAPI-5020.stp

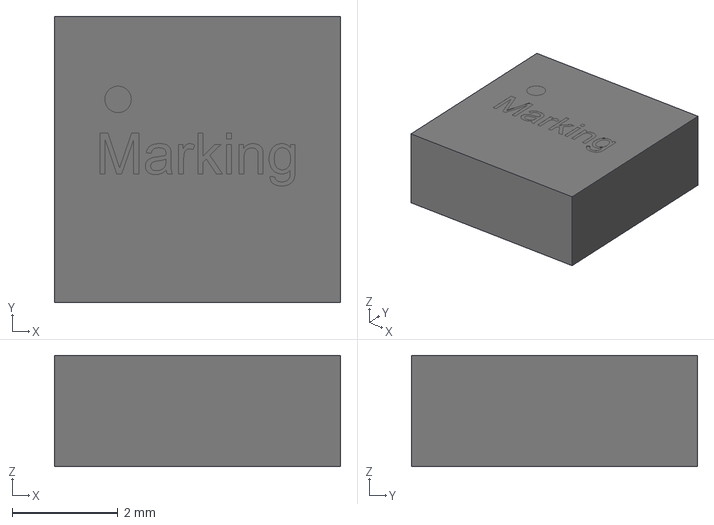
[picture p111: CAD file, 2021-11-19]
3D/WE-MAPI-5020.stp
5.40 x 5.40 x 2.10 mm
body_SSMC_5020
land_pattern x 2
