JitterCompany/KicadComponents/3D/FH12-15S-0.5SH.stp

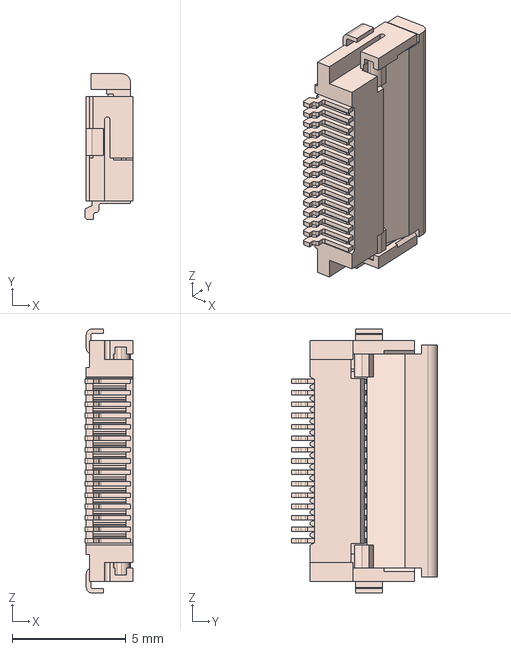
[picture p113: CAD file, 2021-11-19]
3D/FH12-15S-0.5SH.stp
2.10 x 6.40 x 11.6 mm
