JitterCompany/KicadComponents/3D/CONEC_43-02639.stp

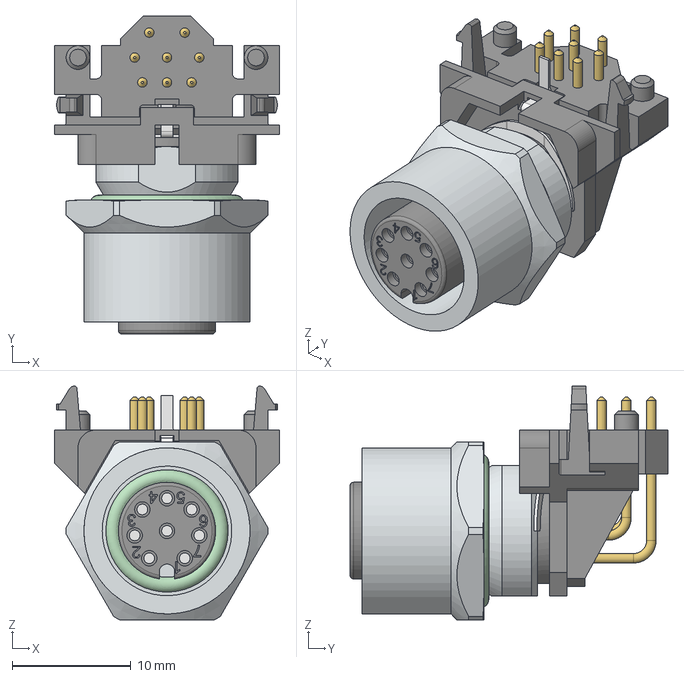
[picture p114: CAD file, 2021-11-19]
3D/CONEC_43-02639.stp
19.0 x 26.8 x 19.7 mm
