JitterCompany/KicadComponents/3D/spacer_M2.5x1.5mm_Wurth_9774015151R.step

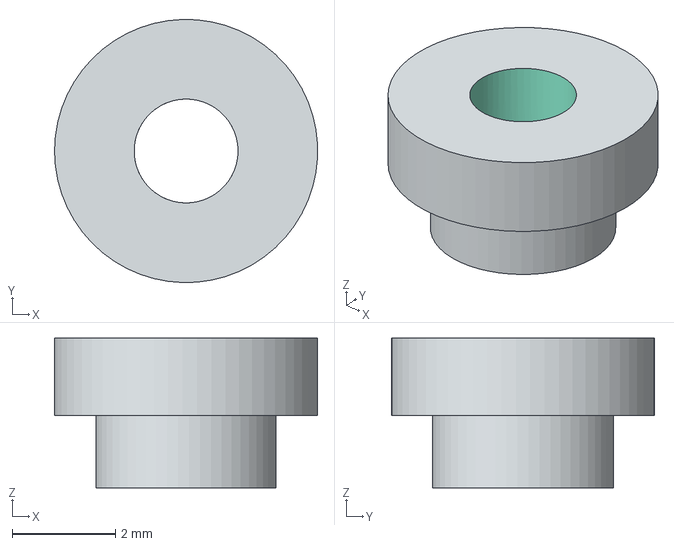
[picture p115: CAD file, 2021-11-19]
3D/spacer_M2.5x1.5mm_Wurth_9774015151R.step
5.10 x 5.10 x 2.90 mm
