JitterCompany/KicadComponents/3D/Vishay_PowerPAK_MLP55_27L.step

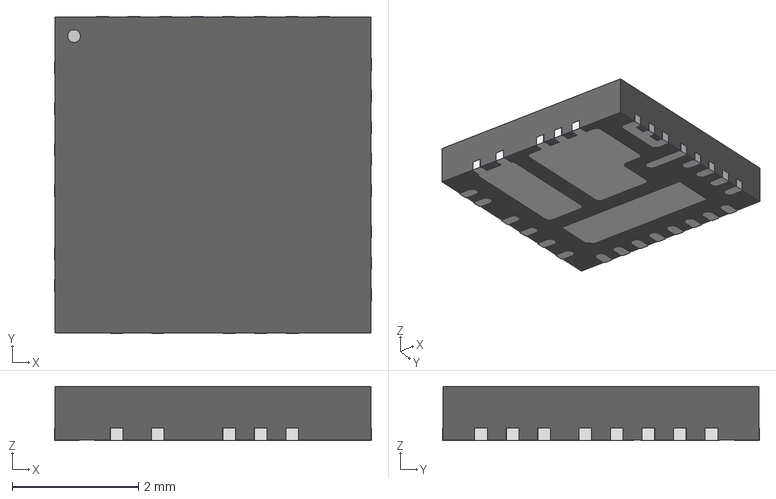
[picture p116: CAD file, 2021-11-19]
3D/Vishay_PowerPAK_MLP55_27L.step
5.02 x 5.02 x 0.86 mm
