JitterCompany/KicadComponents/3D/BGA-6_1x1.5mm_2x3p0.4 v2.step

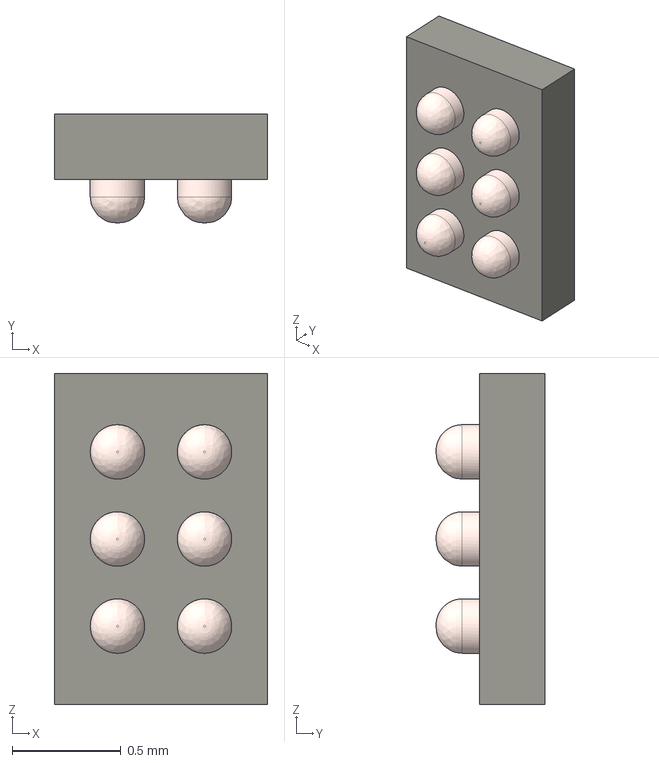
[picture p117: CAD file, 2021-11-19]
3D/BGA-6_1x1.5mm_2x3p0.4 v2.step
0.98 x 0.5 x 1.52 mm
