JitterCompany/KicadComponents/3D/FH12-6S-0.5SV.step

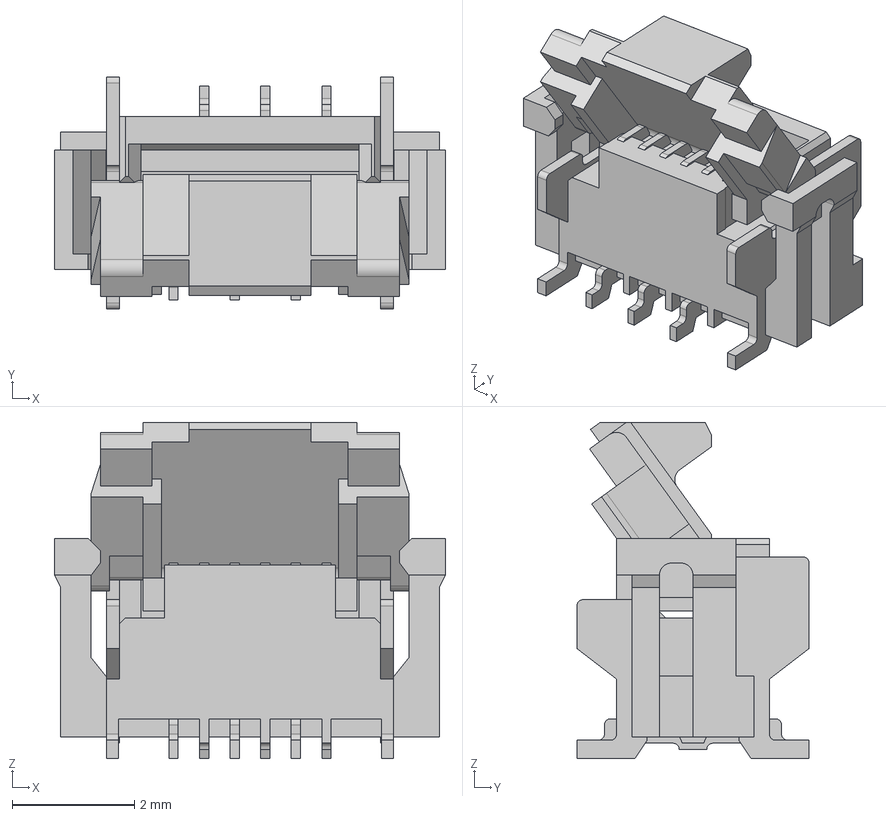
[picture p118: CAD file, 2021-11-19]
3D/FH12-6S-0.5SV.step
6.40 x 3.80 x 5.50 mm
