JitterCompany/KicadComponents/3D/VQFN-HR-08 2x2.step

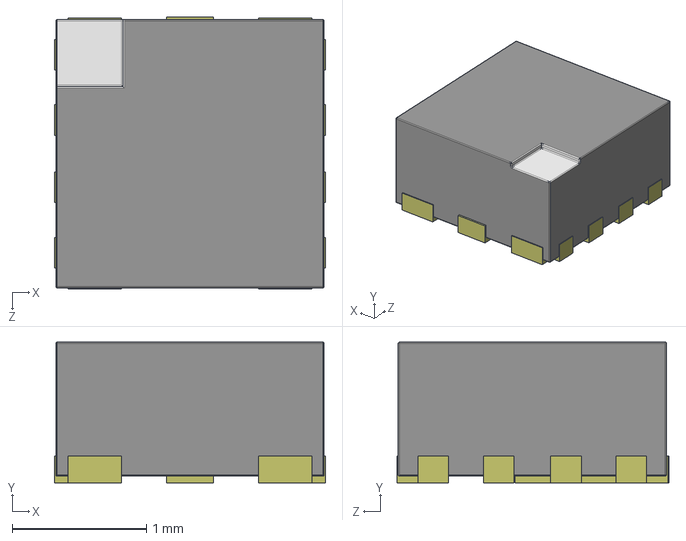
[picture p119: CAD file, 2021-11-19]
3D/VQFN-HR-08 2x2.step
2.02 x 1.05 x 2.03 mm
