JitterCompany/KicadComponents/3D/JST-S8B-PH-SM4-TB.step

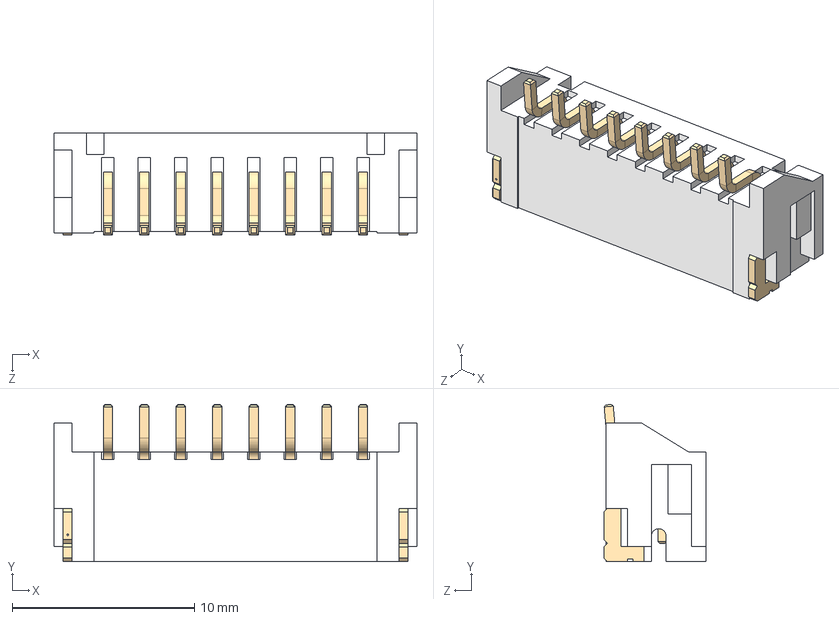
[picture p120: CAD file, 2021-07-19]
3D/JST-S8B-PH-SM4-TB.step
19.9 x 8.61 x 5.61 mm
