JitterCompany/KicadComponents/3D/WE-LQFS-4828.stp

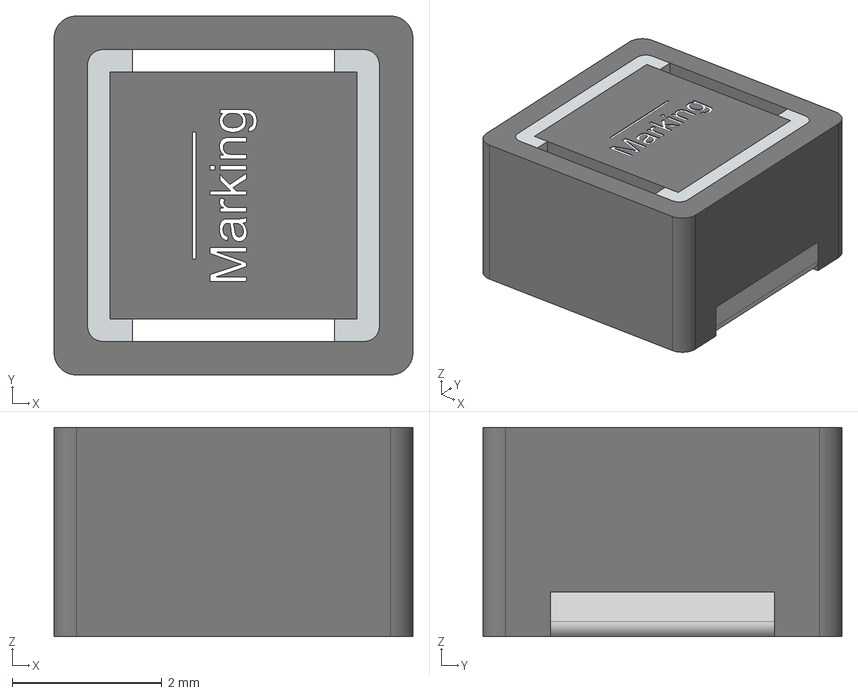
[picture p121: CAD file, 2021-07-15]
3D/WE-LQFS-4828.stp
4.80 x 4.80 x 2.80 mm
Glue L
Glue R
4828_74406043_Housing
4828_74406043_Pads x 2
