JitterCompany/KicadComponents/3D/WE-TPC_4818.stp

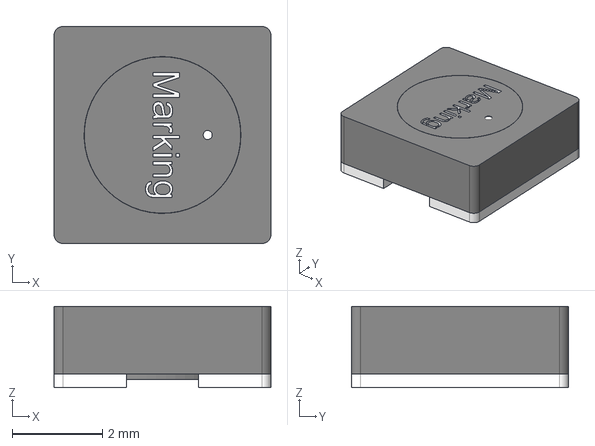
[picture p122: CAD file, 2021-07-15]
3D/WE-TPC_4818.stp
4.80 x 4.80 x 1.80 mm
