JitterCompany/KicadComponents/3D/PESD3V3L5UY,115.stp

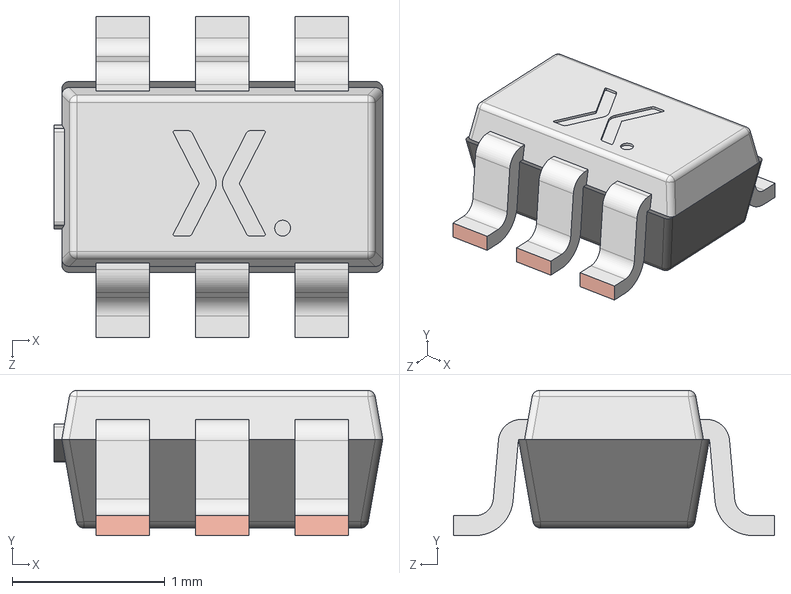
[picture p123: CAD file, 2021-07-15]
3D/PESD3V3L5UY,115.stp
2.15 x 0.95 x 2.10 mm
SOT353 Lower body
SOT353 Lead x 6
SOT353 Upper body
