JitterCompany/KicadComponents/3D/TLV4333IPWR.stp

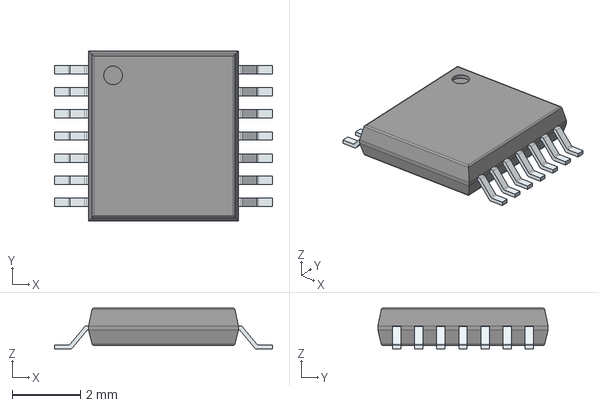
[picture p124: CAD file, 2021-07-09]
3D/TLV4333IPWR.stp
6.40 x 5.00 x 1.20 mm
PinsArrayLR
