JitterCompany/KicadComponents/3D/EEEFPV680XAV.stp

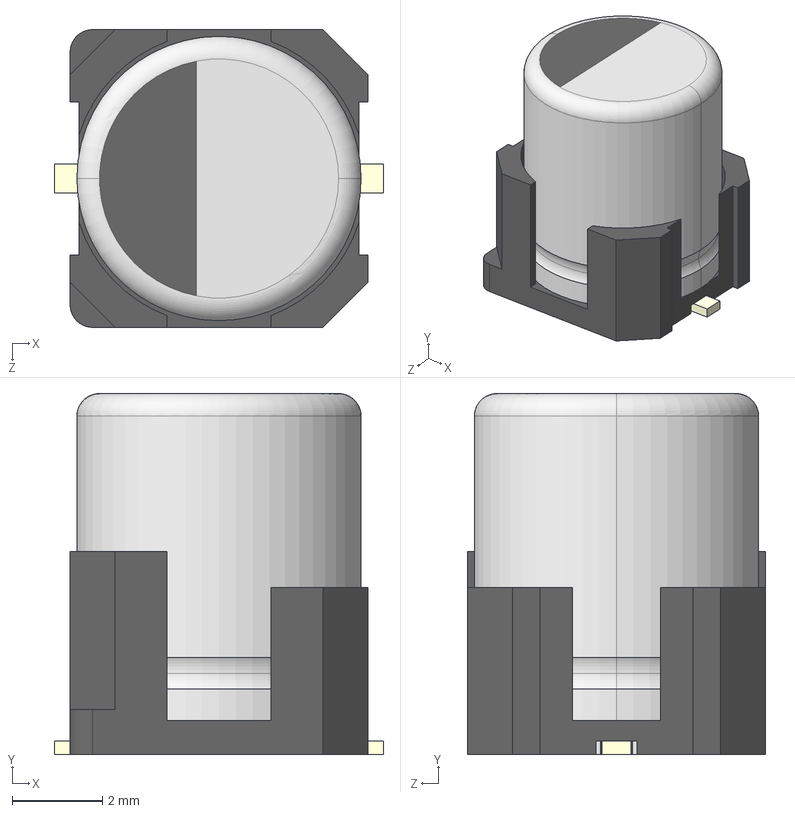
[picture p125: CAD file, 2021-07-09]
3D/EEEFPV680XAV.stp
7.30 x 8.00 x 6.60 mm
SIZE CODE D8-001
SIZE CODE D8-002
SIZE CODE D8-003 x 2
SIZE CODE D8-004 x 2
