JitterCompany/KicadComponents/3D/LMV339IRUCR.stp

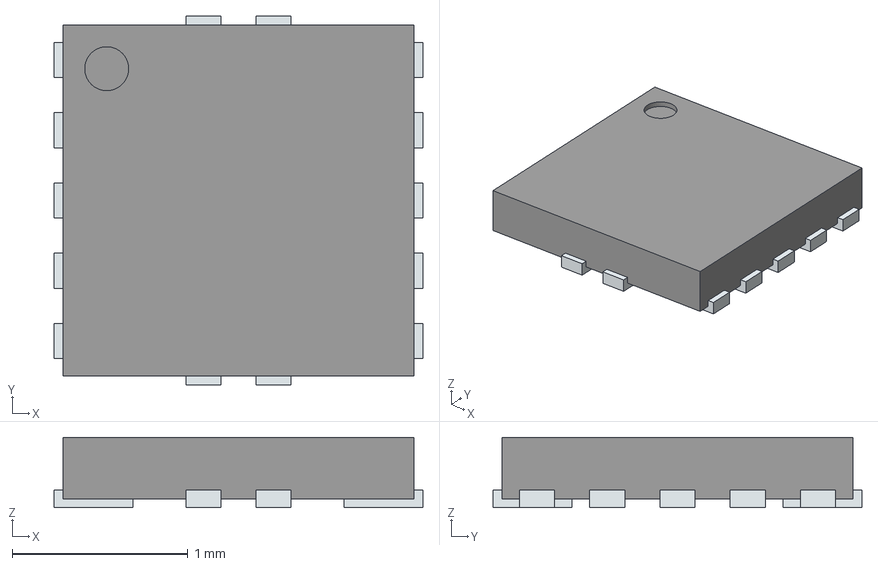
[picture p126: CAD file, 2021-07-09]
3D/LMV339IRUCR.stp
2.10 x 2.10 x 0.4 mm
PinsArrayLR
PinsArrayTB
