JitterCompany/KicadComponents/3D/PESD3V3L5UF115.STEP

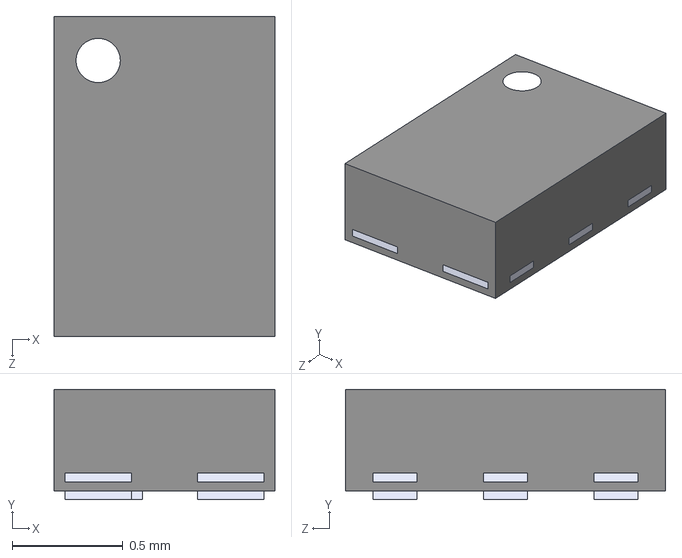
[picture p127: CAD file, 2021-07-09]
3D/PESD3V3L5UF115.STEP
1.00 x 0.5 x 1.45 mm
