JitterCompany/KicadComponents/3D/MAX6160EUS-T.step

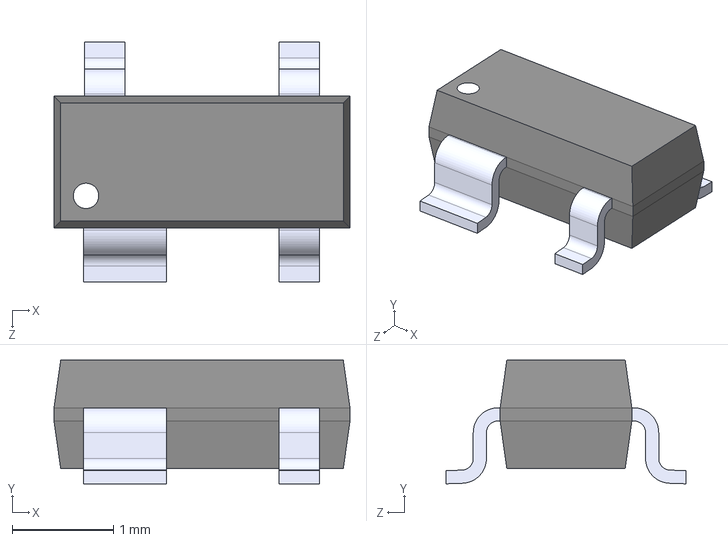
[picture p128: CAD file, 2021-07-05]
3D/MAX6160EUS-T.step
2.92 x 1.22 x 2.37 mm
