JitterCompany/KicadComponents/3D/JST-B5B-PH-K-S.step

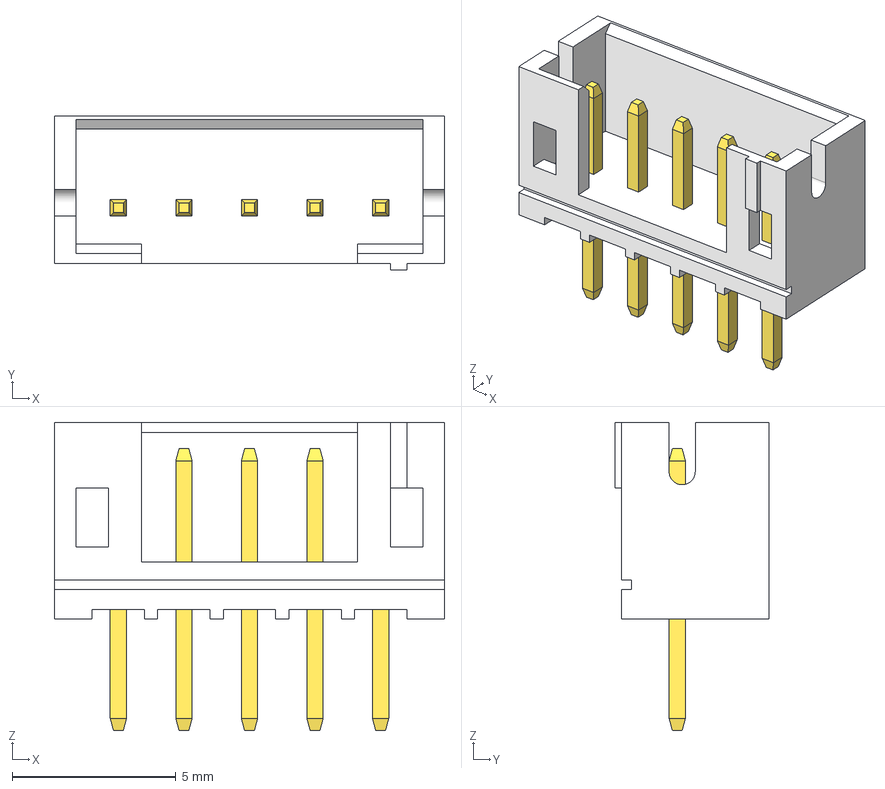
[picture p129: CAD file, 2021-07-02]
3D/JST-B5B-PH-K-S.step
11.9 x 4.70 x 9.40 mm
