JitterCompany/KicadComponents/3D/JST-B5B-PH-SM4-TB.step

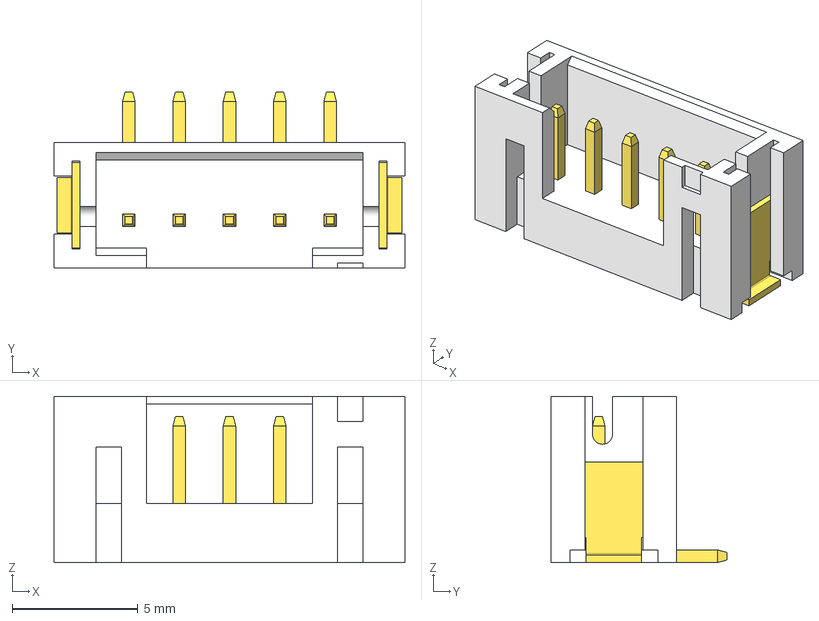
[picture p130: CAD file, 2021-07-02]
3D/JST-B5B-PH-SM4-TB.step
13.9 x 7.00 x 6.60 mm
