JitterCompany/KicadComponents/3D/JST-B15B-PH-SM4-TB.step

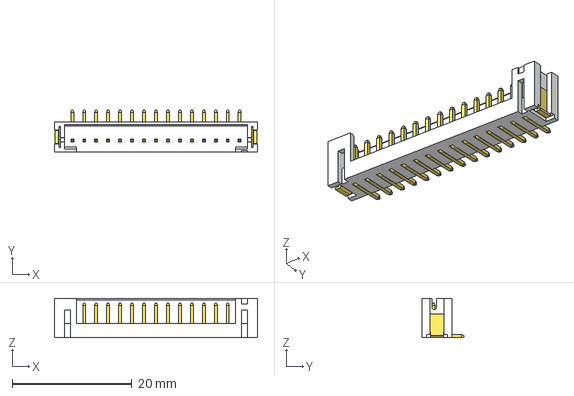
[picture p131: CAD file, 2021-07-02]
3D/JST-B15B-PH-SM4-TB.step
34.0 x 7.00 x 6.60 mm
