JitterCompany/KicadComponents/3D/JST-B6B-PH-SM4-TB.step

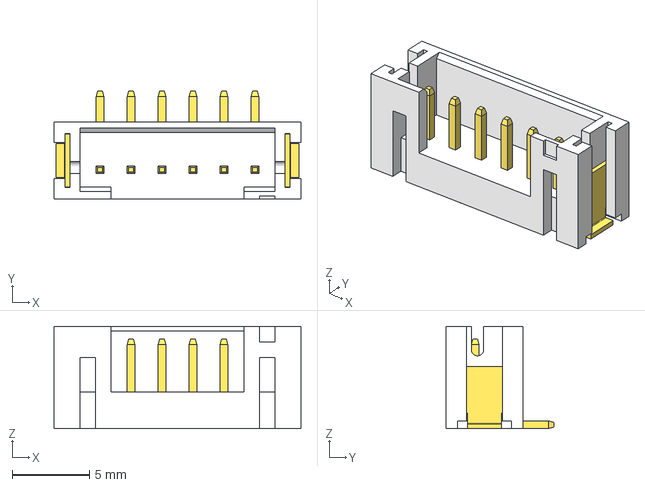
[picture p132: CAD file, 2021-07-02]
3D/JST-B6B-PH-SM4-TB.step
15.9 x 7.00 x 6.60 mm
