JitterCompany/KicadComponents/3D/JST-B16B-PH-K-S.step

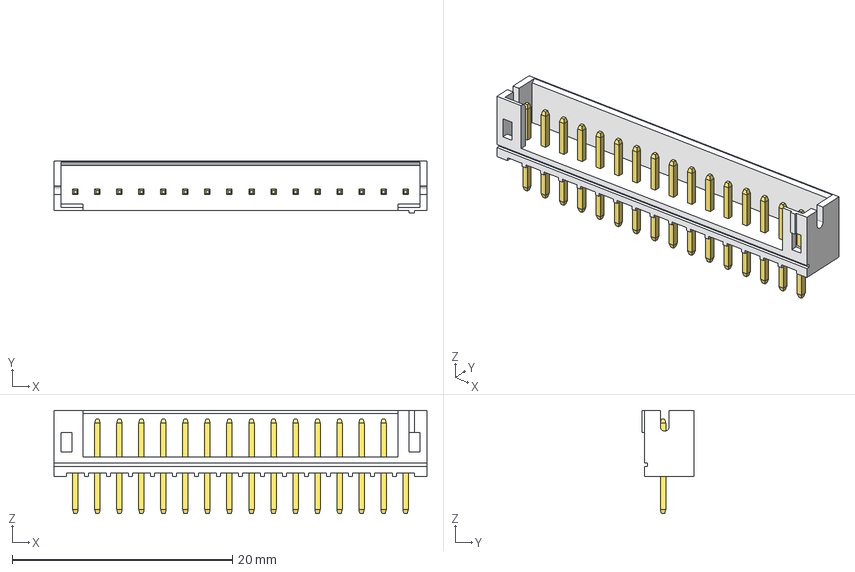
[picture p133: CAD file, 2021-07-02]
3D/JST-B16B-PH-K-S.step
33.9 x 4.70 x 9.40 mm
