JitterCompany/KicadComponents/3D/JST-B13B-PH-K-S.step

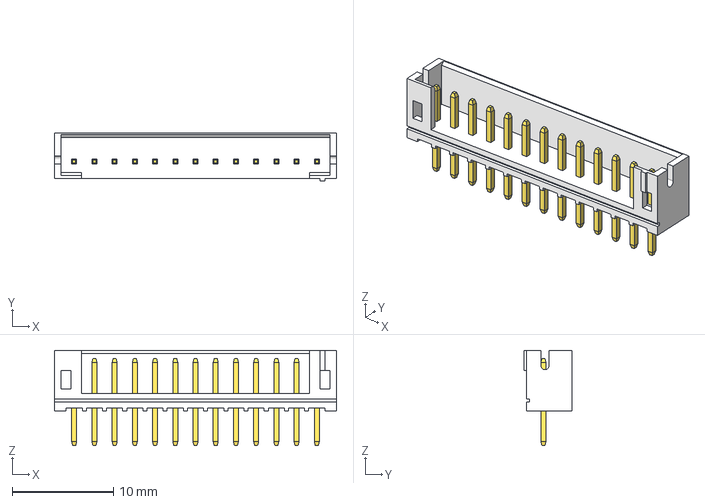
[picture p134: CAD file, 2021-07-02]
3D/JST-B13B-PH-K-S.step
27.9 x 4.70 x 9.40 mm
