JitterCompany/KicadComponents/3D/JST-B10B-PH-K-S.step

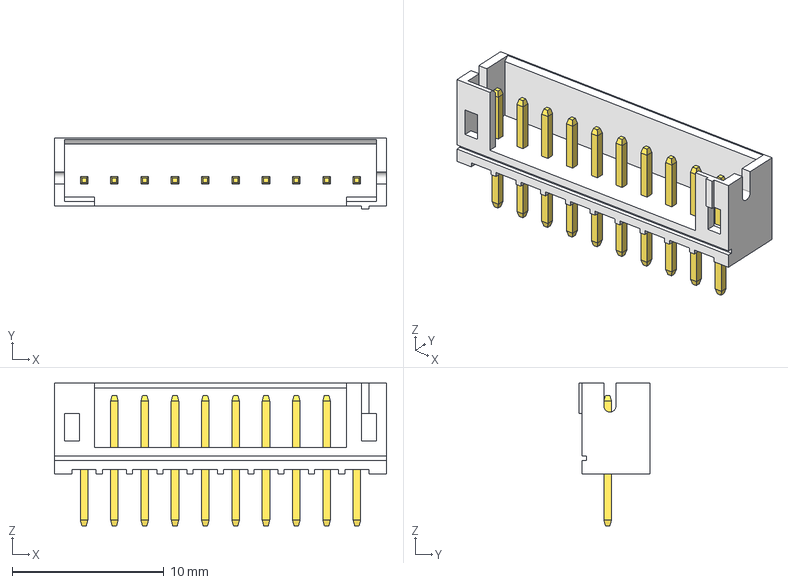
[picture p135: CAD file, 2021-07-02]
3D/JST-B10B-PH-K-S.step
21.9 x 4.70 x 9.40 mm
