JitterCompany/KicadComponents/3D/JST-B11B-PH-K-S.step

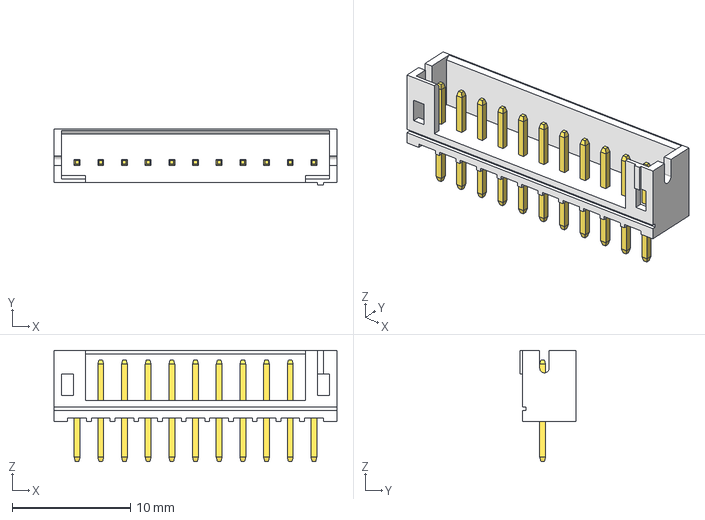
[picture p136: CAD file, 2021-07-02]
3D/JST-B11B-PH-K-S.step
23.9 x 4.70 x 9.40 mm
