JitterCompany/KicadComponents/3D/JST-B4B-PH-SM4-TB.step

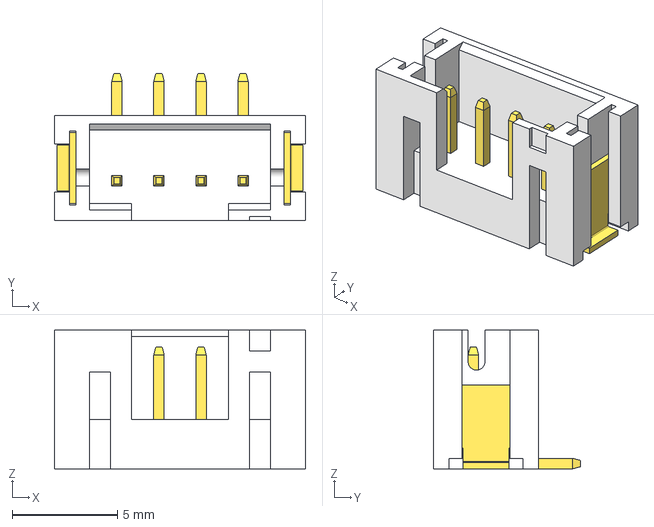
[picture p137: CAD file, 2021-07-02]
3D/JST-B4B-PH-SM4-TB.step
11.9 x 7.00 x 6.60 mm
