JitterCompany/KicadComponents/3D/JST-B8B-PH-K-S.step

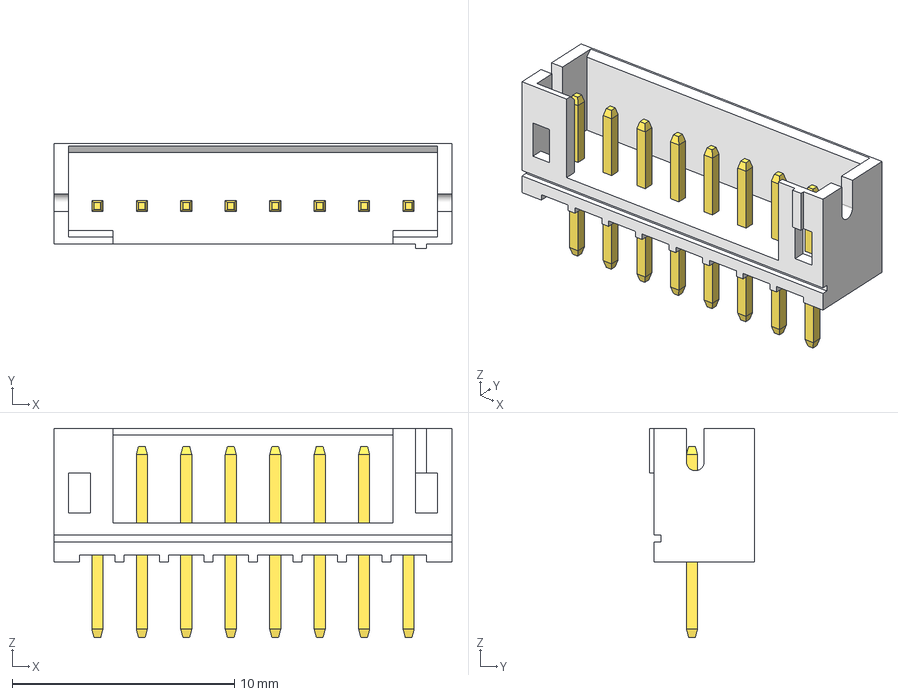
[picture p139: CAD file, 2021-07-02]
3D/JST-B8B-PH-K-S.step
17.9 x 4.70 x 9.40 mm
