JitterCompany/KicadComponents/3D/JST-B15B-PH-K-S.step

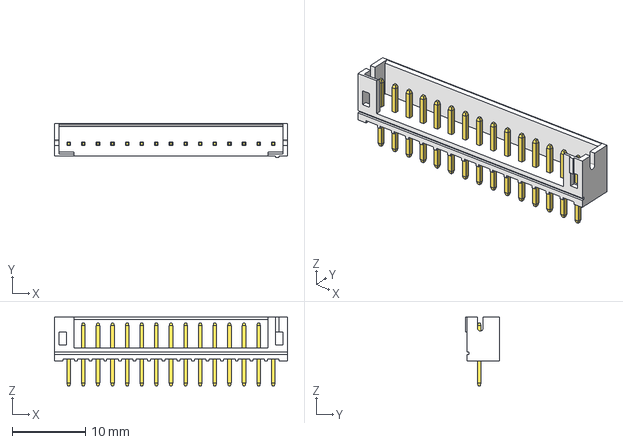
[picture p140: CAD file, 2021-07-02]
3D/JST-B15B-PH-K-S.step
31.9 x 4.70 x 9.40 mm
