JitterCompany/KicadComponents/3D/JST-B16B-PH-SM4-TB.step

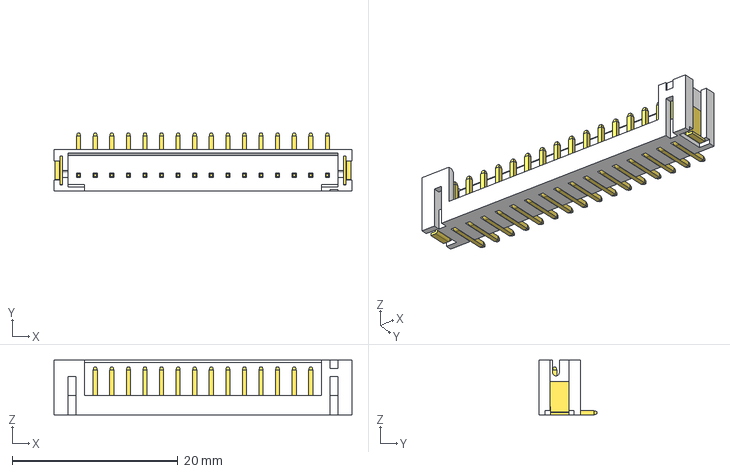
[picture p141: CAD file, 2021-07-02]
3D/JST-B16B-PH-SM4-TB.step
36.0 x 7.00 x 6.60 mm
