JitterCompany/KicadComponents/3D/JST-B2B-PH-K-S.step

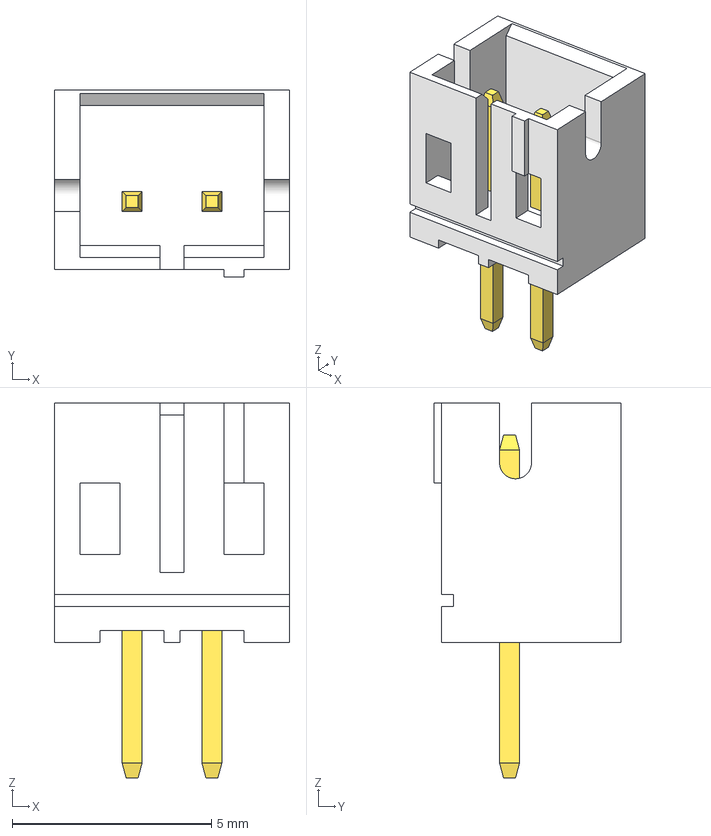
[picture p142: CAD file, 2021-07-02]
3D/JST-B2B-PH-K-S.step
5.90 x 4.70 x 9.40 mm
