JitterCompany/KicadComponents/3D/JST-B9B-PH-SM4-TB.step

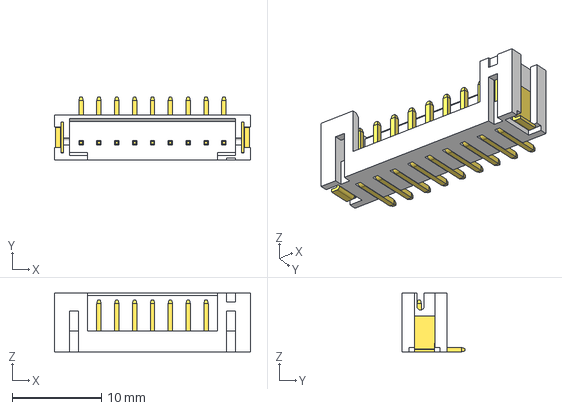
[picture p143: CAD file, 2021-07-02]
3D/JST-B9B-PH-SM4-TB.step
22.0 x 7.00 x 6.60 mm
