JitterCompany/KicadComponents/(list of files, cad)

Other CAD files:
3D/jitter_batt_clip_18650_empty.step
3D/TE_T4141012041-000.stp
3D/1002427_ME_fit.stp
3D/1053091202.stp
3D/1053101206.stp
3D/1053141204.stp
3D/1054291206.stp
3D/18650.step
3D/2920L110_60MR.STEP
3D/2x20_header_STP_610020243021_rev1.stp
3D/430450221.stp
3D/430450421.stp
3D/430450800.stp
3D/43650-0403.stp
3D/447640401.stp
3D/490107670612.stp
3D/679304124022_vertical.stp
3D/691304330003_Wurth_WR-1x03_push-in.stp
3D/691305330003_Wurth_WR-1x03P3.81mm_Vertical_latch.stp
3D/691311500103_Wurth_WR-1x03P5.08mm_Vertical.stp
3D/691321100002_Wurth_WR-1x02P3.50mm_Vertical.stp
3D/691321100005_Wurth_WR-1x05P3.50mm_Vertical.stp
3D/691321300003_Wurth_WR-1x03P3.81mm_Vertical.stp
3D/691322110002_Wurth_WR-1x02P3.50mm_Horizontal.stp
3D/691322110003_Wurth_WR-1x03P3.50mm_Horizontal.stp
3D/691322110004_Wurth_WR-1x04P3.50mm_Horizontal.stp
3D/691322110005_Wurth_WR-1x05P3.50mm_Horizontal.stp
3D/691322110006_Wurth_WR-1x06P3.50mm_Horizontal.stp
3D/691322110008_Wurth_WR-1x08P3.50mm_Horizontal.stp
3D/691322110012_Wurth_WR-1x12P3.50mm_Horizontal.stp
3D/691322310002_Wurth_WR-1x02P3.81mm_Horizontal.stp
3D/691322310003_Wurth_WR-1x03P3.81mm_Horizontal.stp
3D/691361100002_Wurth_WR-1x02_Plug.stp
3D/691361100005_Wurth_WR-1x05_Plug.stp
3D/8SIOC.stp
3D/A6S-1102-H.step
3D/A6S-4102-H.step
3D/AAA Battery.STEP
3D/ABPMAN-series-pressure-sensor.STEP
3D/ADXL355BEZ-RL.stp
3D/AEDR-8300_encoder.STEP
3D/AFBR-S50MV85G.stp
3D/APA102 2020 LED.STEP
3D/APDA1815_cp.step
3D/ASVTX-13.STEP
3D/B2B-XH-AM.STEP
3D/B57211P0100M301.stp
3D/B8B-XH-A.STEP
3D/BG95.step
3D/CMWX1ZZABZ.STEP
3D/CRYSTAL_SMD_TXC_7A-2Pin_5.0x3.2mm.step
3D/CRYSTAL_TXC_9C_TXC.step
3D/CSD17552Q3A.stp
3D/CUI UJ2-MIBH-4-SMT-TR-67 Micro USB Waterproof.STEP
3D/Conn_HIROSE_FH12-6S-0.5SH_55_eec.STEP
3D/Crystal_3.2x1.5_ABS07-series.STEP
3D/D-DO214AC-0002-00019.step
3D/DCT__R-PDSO-G8.stp
3D/DF40HC(3.0)-100DS-0.4V.stp
3D/DeltaS24series.step
3D/ElCapLA-1.5-4x5-black.step
3D/ElCapLA-1.5-4x5.step
3D/ElCapLA-1.5-4x7-black.step
3D/ElCapLA-1.5-4x7.step
3D/ElCapLA-2.0-5x11-black.step
3D/ElCapLA-2.0-5x11.step
3D/ElCapLA-2.0-5x5-black.step
3D/ElCapLA-2.0-5x5.step
3D/ElCapLA-2.0-5x7-black.step
3D/ElCapLA-2.0-5x7.step
3D/ElCapLA-2.5-6.3x11-black.step
3D/ElCapLA-2.5-6.3x11.step
3D/ElCapLA-2.5-6.3x12-black.step
3D/ElCapLA-2.5-6.3x12.step
3D/ElCapLA-2.5-6.3x5-black.step
3D/ElCapLA-2.5-6.3x5.step
3D/ElCapLA-2.5-6.3x7-black.step
3D/ElCapLA-2.5-6.3x7.step
3D/ElCapLA-3.5-8x12-black.step
3D/ElCapLA-3.5-8x12.step
3D/ElCapLA-3.5-8x14-black.step
3D/ElCapLA-3.5-8x14.step
3D/ElCapLA-3.5-8x16-black.step
3D/ElCapLA-3.5-8x16.step
3D/ElCapLA-5.0-10x12-black.step
3D/ElCapLA-5.0-10x12.step
3D/ElCapLA-5.0-10x16-black.step
3D/ElCapLA-5.0-10x16.step
3D/ElCapLA-5.0-10x17-black.step
3D/ElCapLA-5.0-10x17.step
3D/ElCapLA-5.0-10x20-black.step
3D/ElCapLA-5.0-10x20.step
3D/ElCapLA-5.0-13x20-black.step
3D/ElCapLA-5.0-13x20.step
3D/ElCapLA-5.0-13x25-black.step
3D/ElCapLA-5.0-13x25.step
3D/ElCapLA-7.5-16x25-black.step
3D/ElCapLA-7.5-16x25.step
3D/ElCapLA-7.5-16x30-black.step
3D/ElCapLA-7.5-16x30.step
3D/ElCapLA-7.5-16x35-black.step
3D/ElCapLA-7.5-16x35.step
3D/ElCapLA-7.5-18x25-black.step
3D/ElCapLA-7.5-18x25.step
3D/ElCapLA-7.5-18x30-black.step
3D/ElCapLA-7.5-18x30.step
3D/ElCapLA-7.5-18x35-black.step
3D/ElCapLA-7.5-18x35.step
3D/ElCapLA-7.5-18x40-black.step
3D/ElCapLA-7.5-18x40.step
3D/FFC_stiffener_6.5x5x0.2.step
3D/FH12-10S-0.5SH.STEP
3D/FH12-12S-0.5SH.stp
3D/FH12-6S-0.5SV.stp
3D/HSMC-C230_LED_red_right_angle_0402.STEP
3D/HSMQ-C230_LED_green_right_angle_0402.STEP
3D/HSMR-C230_LED_blue_right_angle_0402.STEP
3D/HSMT8.STEP
3D/JST-06FLH-SM1-TB.step
3D/JST-B10B-PH-SM4-TB.step
3D/JST-B12B-PH-K-S.step
3D/JST-B12B-PH-SM4-TB.step
3D/JST-B13B-PH-SM4-TB.step
3D/JST-B14B-PH-K-S.step
3D/JST-B2B-PH-SM4-TB.step
3D/JST-B3B-PH-K-S.step
3D/JST-B3B-PH-SM4-TB.step
3D/JST-B4B-PH-K-S.step
3D/JST-B6B-PH-K-S.step
3D/JST-B7B-PH-K-S.step
3D/JST-B7B-PH-SM4-TB.step
3D/JST-B9B-PH-K-S.step
3D/JST_B2B-PH-SM4-TB.step
3D/JST_B3B-PH-SM4-TB.step
3D/JST_PH_B6B-PH-SM4-TB_1x06-1MP_P2.00mm_Vertical].STEP
3D/JST_S2B-PH-SM4-TB.STEP
3D/JST_S2B-ZR-SM4A-TF.STEP
3D/JST_S3B-PH-SM4-TB.STEP
3D/JST_S4B-PH-SM4-TB.STEP
3D/JST_S4B-ZR-SM4A-TF.STEP
3D/JST_S6B-PH-SM4-TB.STEP
3D/KSZ8794CNXCC-TR.step
3D/L712RAS_switchcraft_dc_jack.step
3D/LED_0804_rigthangle_blue_LTST-S220.STEP
3D/LED_0804_rigthangle_green_LTST-S220.STEP
3D/LED_0804_rigthangle_red_LTST-S220.STEP
3D/LMQ61460.stp
3D/M8S-04PFFR-SF8001.stp
3D/MAX16052AUT.stp
3D/MAX5322EAIT.step
3D/MF-GSMF300_36X.STEP
3D/MM60-52B1-G1-R850.step
3D/MM60-EZH039-B5.step
3D/MPVZ5010GW6U.SLDPRT
3D/MPVZ5010GW6U.STEP
3D/Molex_503480-1400.stp
3D/PEL12D-4x18G-xxxxx.stp
3D/PG-TSDSON-8.stp
3D/PLT10HH101150PNL.step
3D/PTSM_0.5_4-HH0-2.5-SMD.STEP
3D/Panasonic-ALZ12B24.step
3D/Pin header jumper.STEP
3D/PowerDI5060-8-Type-C.stp
3D/PowerPAK SO-8.step
3D/S6B-ZR.STEP
3D/SF53S006VCBR2000.step
3D/SFH_2440_160916_geometry.STEP
3D/SFW15R-1STE1LF.stp
3D/SIM8051-6-0-14-01-A.stp
3D/SKQYAB.STEP
3D/SMA_right_angle_TE_619540-1.step
3D/SMD_SOT23-6.step
3D/SMD_resistor_1206.STEP
3D/SMTU 2450N-1-LF.STEP
3D/SMTU 2450N-1-LF_with_battery.STEP
3D/SRP-5030_inductor.step
3D/SRP6060FA.stp
3D/SSOP_axial_port_1317A.STEP
3D/TDSON-8-33-P-v01_00-EN.stp
3D/TPD3F303DPVR.step
3D/TPD3F303DQDR.step
3D/UFBGA73.STEP
3D/USB3150-30-130-A.STEP
3D/VARTA_3V600HR.STEP
3D/VL6180X v5.step
3D/VSONP-8-1EP_5x6_Pitch1.27mm.step
3D/WE-LHMI-1040.step
3D/WE-LHMI-1365.stp
3D/WE-SCC-1260_rev1__CommonMode.stp
3D/WE-SL5_HC_744273.stp
3D/WE-TVSP-DO-214AC-Bidirectional_rev1.stp
3D/WE-VS-1206_rev1.stp
3D/Wurth_USBA_61400416021 (rev1).stp
3D/Wurth_USB_MicroB_614105150721_vertical.step
3D/Wurth_USB_MicroB_629105150521 (rev1).stp
3D/battery-cr2450.stp
3D/blackpill_mcu_board.STEP
3D/boxed_connector_13x2_2.54mm.STEP
3D/button_ALPS_SKRKAEE020.STEP
3D/button_SKQYAB.STEP
3D/capacitor_SMD_12.5x13.5__panasonic_H13.STEP
3D/ct3151sp-0-BLK-300_banana.step
3D/enclosure_100x76x35.STEP
3D/fuse_2410.stp
3D/header_1.27_5x2_boxed.STEP
3D/inductor_taiyo_NRS8030.STEP
3D/keystone_1043__1043p_batteryholder.STEP
3D/keystone_1043__non_polarized.STEP
3D/keystone_55_batteryclip_aaa.STEP
3D/keystone_56_batteryclip_aaa.STEP
3D/m20-7910842_asm.stp
3D/m20-7920442_asm.stp
3D/m50-3100545_asm.stp
3D/mPCIe-spec.STEP
3D/microfit_2x2_rightangle_430450409.stp
3D/mpr-series-long-port-with-gel-gage-cad-model.stp
3D/mps_dcdc_ult_smt_a.step
3D/ms302-10_2.step
3D/pin_header_a-sl254-ea-g10mp1.stp
3D/pin_header_a-sl254-ea-g3mp1.STEP
3D/rivet_DIN660_M2_3mm.STEP
3D/rotary_encoder_RGB__SF-COM-10982.STEP
3D/s7121-42r.step
3D/sot-523.step
3D/spacer_M2x5mm_Wurth_9774050243R.STEP
3D/spacer_M4x6mm_Wurth_9774060482R.STEP
3D/spring_contact_TE_2306334-3.stp
3D/switch_eoz_09.03201.STEP
3D/tbu-ca.stp
3D/vishay_powerpak_SC70-6L.step
3D/vls252010cx-1.step
3D/w3544b_7-65_26_3.stp
3D/we_8p8c_74980111211.stp
3D/wifi_lora_32_v2.STEP
