JitterCompany/KicadComponents/(threads)

Thread 1 (2024-04-23):

filename collisions for two parts

ijager, 2024-04-23:
Got this error while cloning this repo:

```
warning: the following paths have collided (e.g. case-sensitive paths
on a case-insensitive filesystem) and only one from the same
colliding group is in the working tree:

  'Jitter_Footprints/DCT_R-PDSO-G8_3x3mm_P0.65mm.kicad_mod'
  'Jitter_Footprints/DCT_r-pdso-g8_3x3mm_P0.65mm.kicad_mod'
```
