JitterCompany/KicadComponents/blocks/schema.kicad_blocks/PWM output 12V.kicad_block/PWM output 12V.kicad_sch

## KiCad design blocks/schema.kicad_blocks/PWM output 12V.kicad_block/PWM output 12V.kicad_sch (2026-08-17)

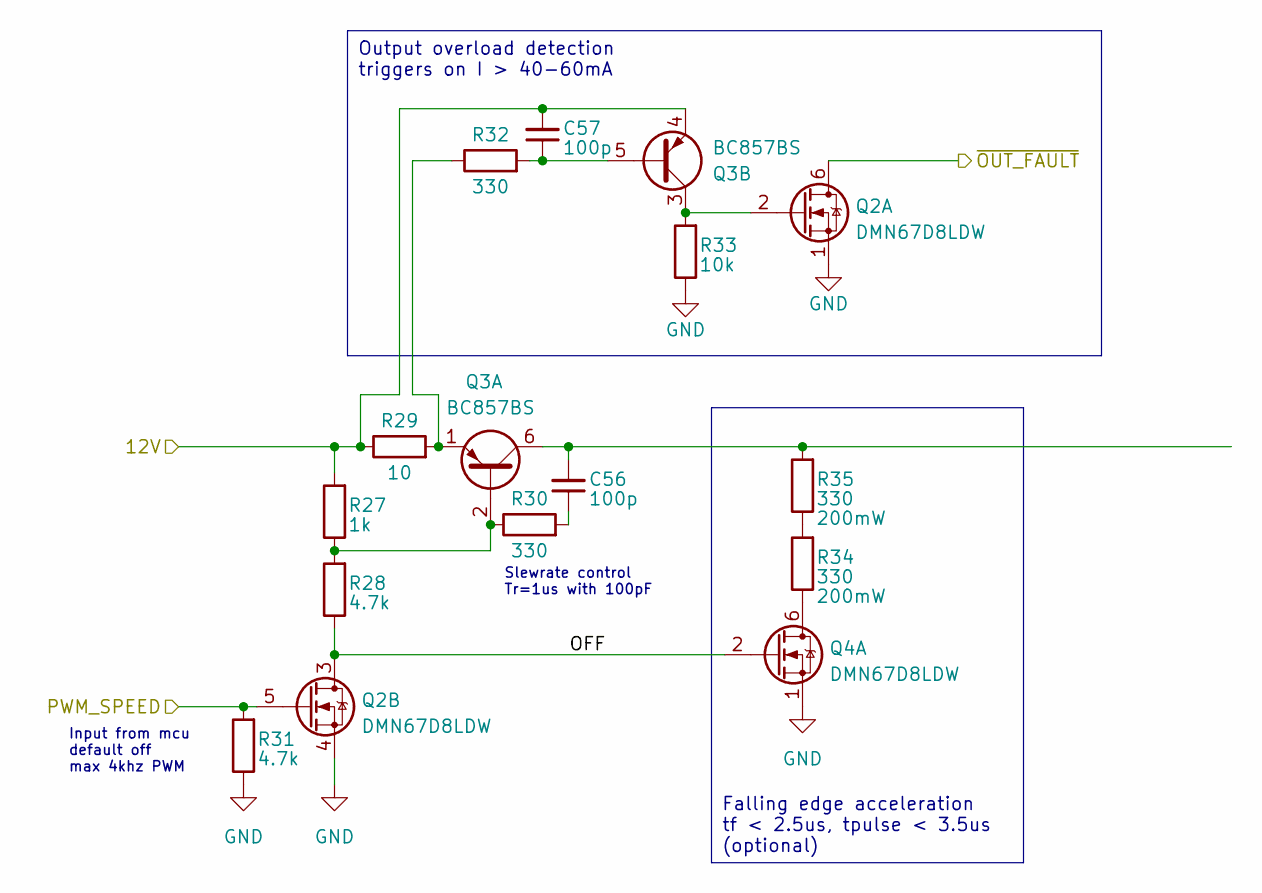
[picture p146: schematic PWM output 12V.kicad_sch]

Parts:
C56, C57: 100p; C_0603_1608Metric
Q2, Q4: DMN67D8LDW; SOT-363_SC-70-6; rating vgs_max=30; MPN DMN67D8LDW-7; Mouser 621-DMN67D8LDW-7
Q3: BC857BS; SOT-363_SC-70-6
R27: 1k; R_0603_1608Metric
R28, R31: 4.7k; R_0603_1608Metric
R29: 10; R_0603_1608Metric
R30, R32: 330; R_0603_1608Metric
R33: 10k; R_0603_1608Metric
R34, R35: 330; R_0603_1608Metric; rating 200mW

Connections:
12V: C57.2, Q3.4 (E2), R27.2, R29.1
GND: Q2.1 (S), Q2.4 (S), Q4.1 (S), R31.1, R33.1
unnamed: C56.1, R30.2
unnamed: C56.2, Q3.6 (C1), R35.2
unnamed: C57.1, Q3.5 (B2), R32.2
unnamed: Q2.2 (G), Q3.3 (C2), R33.2
unnamed: Q3.1 (E1), R29.2, R32.1
unnamed: Q3.2 (B1), R27.1, R28.2, R30.1
unnamed: Q4.6 (D), R34.1
unnamed: R34.2, R35.1
OFF: Q2.3 (D), Q4.2 (G), R28.1
PWM_SPEED: Q2.5 (G), R31.2
~OUT_FAULT: Q2.6 (D)

Notes on the sheet:
Slewrate control Tr=1us with 100pF
Input from mcu default off max 4khz PWM
Falling edge acceleration tf < 2.5us, tpulse < 3.5us (optional)
Output overload detection triggers on I > 40-60mA
