JitterCompany/KicadComponents/blocks/schema.kicad_blocks/dc_dc_3v8_3a.kicad_block/dc_dc_3v8_3a.kicad_sch

## KiCad design blocks/schema.kicad_blocks/dc_dc_3v8_3a.kicad_block/dc_dc_3v8_3a.kicad_sch (2026-08-17)

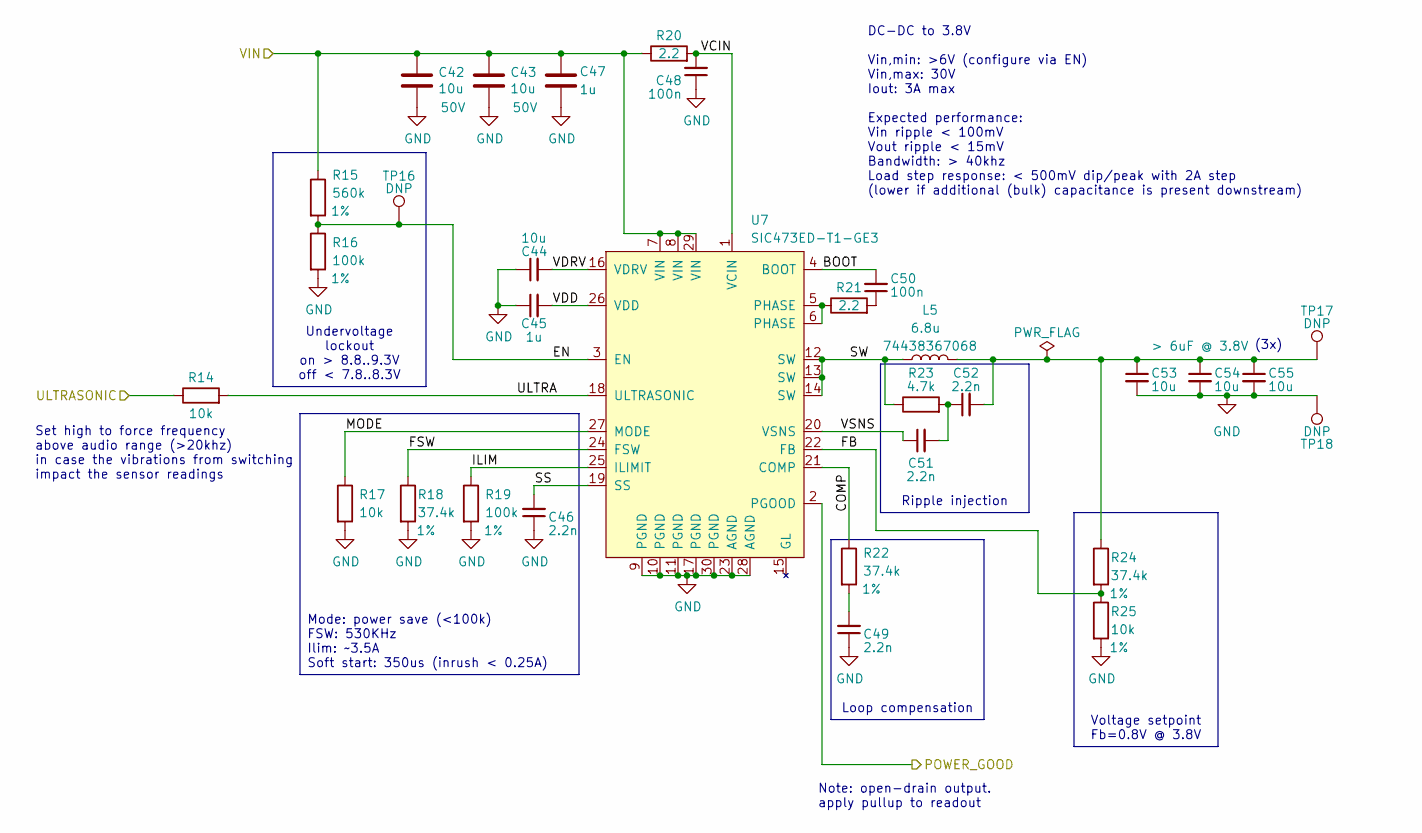
[picture p147: schematic dc_dc_3v8_3a.kicad_sch]

Parts:
C42, C43: 10u; C_1210_3225Metric; rating 50V; MPN CL32A106KBJNNNE; Mouser 187-CL32A106KBJNNNE
C44, C53: 10u; C_0805_2012Metric; rating > 6uF @ 3.8V, >=16V; MPN CL21A106KOQNNNE
C45: 1u; C_0603_1608Metric
C46, C49, C51, C52: 2.2n; C_0603_1608Metric; rating C0G/NPO, >=25V, <=20%; MPN GRT1885C1H222JA02D
C47: 1u; C_0603_1608Metric; rating 35V; MPN CGA3E1X7R1V105K080AC; Mouser 810-CGA3E1X7R1V105KC
C48, C50: 100n; C_0603_1608Metric
C54, C55: 10u; C_0805_2012Metric; rating > 6uF @ 3.8V; MPN CL21A106KOQNNNE
L5: 6.8u; rating Rdc=48mOhm, Isat,10%=3.7; MPN 74438367068; Mouser 710-74438367068
R14, R17: 10k; R_0603_1608Metric
R15: 560k; R_0603_1608Metric; rating 1%
R16, R19: 100k; R_0603_1608Metric; rating 1%
R18, R22, R24: 37.4k; R_0603_1608Metric; rating 1%
R20, R21: 2.2; R_0603_1608Metric
R23: 4.7k; R_0603_1608Metric; rating 1%
R25: 10k; R_0603_1608Metric; rating 1%
TP16, TP17, TP18: DNP; TestPoint_THTPad_D1.0mm_Drill0.5mm
U7: SIC473ED-T1-GE3; Vishay_MLP55-27L; MPN SIC473ED-T1-GE3; Mouser 78-SIC473ED-T1-GE3

Connections:
BOOT: C50.2, U7.4 (BOOT)
COMP: R22.1, U7.21 (COMP)
EN: R15.2, R16.1, TP16.1, U7.3 (EN)
FB: R24.2, R25.1, U7.22 (FB)
FSW: R18.1, U7.24 (FSW)
GND: C42.2, C43.2, C44.1, C45.1, C46.1, C47.1, C48.1, C49.1, C53.2, C54.2, C55.2, R16.2, R17.2, R18.2, R19.2, R25.2, TP18.1, U7.9 (PGND), U7.10 (PGND), U7.11 (PGND), U7.17 (PGND), U7.23 (AGND), U7.28 (AGND), U7.30 (PGND)
ILIM: R19.1, U7.25 (ILIMIT)
MODE: R17.1, U7.27 (MODE)
unnamed: C49.2, R22.2
unnamed: C50.1, R21.2
unnamed: C51.2, C52.1, R23.2
unnamed: C52.2, C53.1, C54.1, C55.1, L5.2, R24.1, TP17.1
unnamed: R21.1, U7.5 (PHASE), U7.6 (PHASE)
POWER_GOOD: U7.2 (PGOOD)
SS: C46.2, U7.19 (SS)
SW: L5.1, R23.1, U7.12 (SW), U7.13 (SW), U7.14 (SW)
ULTRA: R14.2, U7.18 (ULTRASONIC)
ULTRASONIC: R14.1
VCIN: C48.2, R20.2, U7.1 (VCIN)
VDD: C45.2, U7.26 (VDD)
VDRV: C44.2, U7.16 (VDRV)
VIN: C42.1, C43.1, C47.2, R15.1, R20.1, U7.7 (VIN), U7.8 (VIN), U7.29 (VIN)
VSNS: C51.1, U7.20 (VSNS)

Notes on the sheet:
Note: open-drain output. apply pullup to readout
Set high to force frequency above audio range (>20khz) in case the vibrations from switching impact the sensor readings
DC-DC to 3.8V Vin,min: >6V (configure via EN) Vin,max: 30V Iout: 3A max Expected performance: Vin ripple < 100mV Vout ripple < 15mV Bandwidth: > 40khz Load step response: < 500mV dip/peak with 2A step (lower if additional (bulk) capacitance is present downstream)
(3x)
Mode: power save (<100k) FSW: 530KHz Ilim: ~3.5A Soft start: 350us (inrush < 0.25A)
Loop compensation
Ripple injection
Voltage setpoint Fb=0.8V @ 3.8V
Undervoltage lockout on > 8.8..9.3V off < 7.8..8.3V
