JitterCompany/KicadComponents/blocks/schema.kicad_blocks/low-noise LDO.kicad_block/low-noise LDO.kicad_sch

## KiCad design blocks/schema.kicad_blocks/low-noise LDO.kicad_block/low-noise LDO.kicad_sch (2026-08-17)

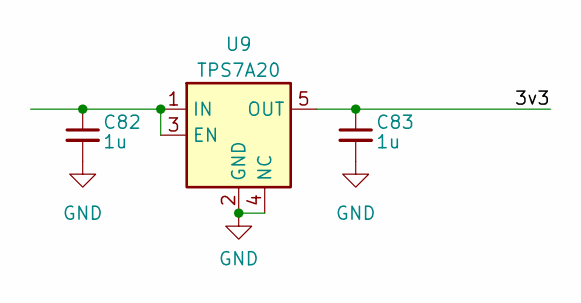
[picture p148: schematic low-noise LDO.kicad_sch]

Parts:
C82, C83: 1u; C_0603_1608Metric
U9: TPS7A20; TSOT-23-5; MPN TPS7A2033PDBVR; Mouser 595-TPS7A2033PDBVR

Connections:
3v3: C83.1, U9.5 (OUT)
GND: C82.2, C83.2, U9.2 (GND), U9.4 (NC)
unnamed: C82.1, U9.1 (IN), U9.3 (EN)
