JitterCompany/KicadComponents/blocks/schema.kicad_blocks/nanoSIM slot.kicad_block/nanoSIM slot.kicad_sch

## KiCad design blocks/schema.kicad_blocks/nanoSIM slot.kicad_block/nanoSIM slot.kicad_sch (2026-08-17)

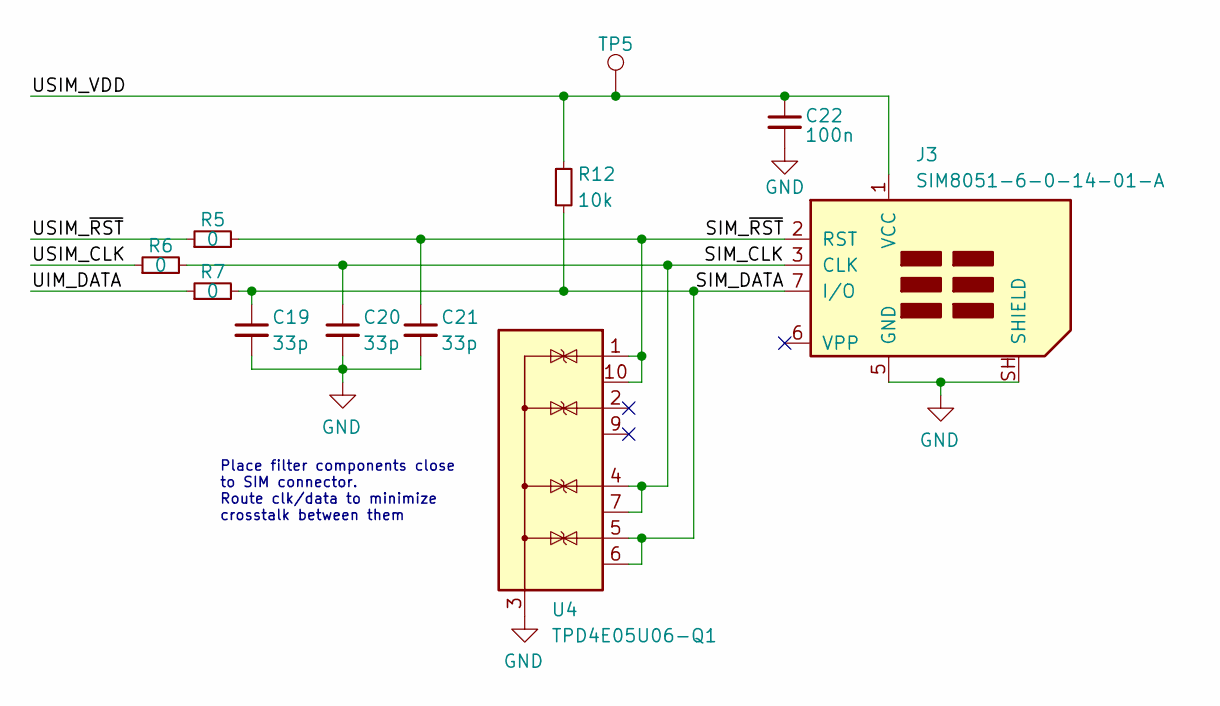
[picture p149: schematic nanoSIM slot.kicad_sch]

Parts:
C19, C20, C21: 33p; C_0603_1608Metric; rating 50V
C22: 100n; C_0603_1608Metric
J3: SIM8051-6-0-14-01-A; nanoSIM_SIM8051-6-0-14_small_court; MPN SIM8051-6-0-14-01-A; Mouser 640-SIM8051601401A
R5, R6, R7: 0; R_0603_1608Metric
R12: 10k; R_0603_1608Metric
TP5: TestPoint; TestPoint_Pad_D1.0mm
U4: TPD4E05U06-Q1; USON-10_2.5x1.0mm_P0.5mm; MPN TPD4E05U06QDQARQ1; Mouser 595-PD4E05U06QDQARQ1

Connections:
GND: C19.2, C20.2, C21.2, C22.2, J3.5 (GND), J3.SH (SHIELD), U4.3 (G), U4.8 (G)
SIM_CLK: C20.1, J3.3 (CLK), R6.2, U4.4 (IO3), U4.7 (NC)
SIM_DATA: C19.1, J3.7 (I/O), R7.2, R12.2, U4.5 (IO4), U4.6 (NC)
SIM_~RST: C21.1, J3.2 (RST), R5.2, U4.1 (IO1), U4.10 (NC)
UIM_DATA: R7.1
USIM_CLK: R6.1
USIM_VDD: C22.1, J3.1 (VCC), R12.1, TP5.1
USIM_~RST: R5.1

Notes on the sheet:
Place filter components close to SIM connector. Route clk/data to minimize crosstalk between them
