JitterCompany/KicadComponents/blocks/schema.kicad_blocks/power_switch_5v5.kicad_block/power_switch_5v5.kicad_sch

## KiCad design blocks/schema.kicad_blocks/power_switch_5v5.kicad_block/power_switch_5v5.kicad_sch (2026-08-17)

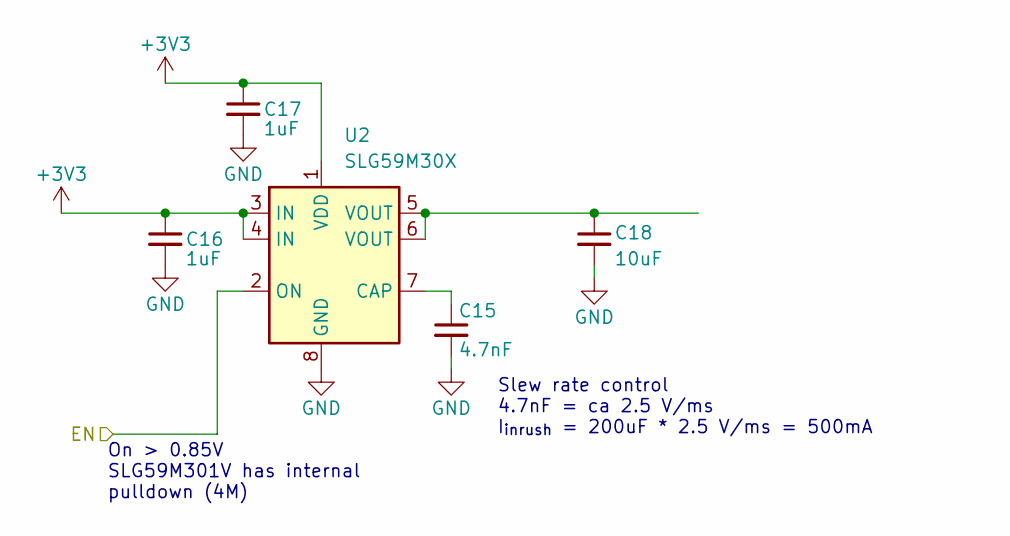
[picture p150: schematic power_switch_5v5.kicad_sch]

Parts:
C15: 4.7nF; C_0603_1608Metric
C16, C17: 1uF; C_0603_1608Metric
C18: 10uF; C_0805_2012Metric; rating > 6uF @ 3.3V; MPN CL21A106KOQNNNE
U2: SLG59M30X; DFN200X150X80-8N; MPN SLG59M301V; Mouser 402-SLG59M301V

Connections:
+3V3: C16.1, C17.1, U2.1 (VDD), U2.3 (IN), U2.4 (IN)
EN: U2.2 (ON)
GND: C15.2, C16.2, C17.2, C18.2, U2.8 (GND)
unnamed: C15.1, U2.7 (CAP)
unnamed: C18.1, U2.5 (VOUT), U2.6 (VOUT)

Notes on the sheet:
On > 0.85V SLG59M301V has internal pulldown (4M)
Slew rate control 4.7nF = ca 2.5 V/ms I_{inrush} = 200uF * 2.5 V/ms = 500mA
