JitterCompany/KicadComponents/blocks/schema.kicad_blocks/temperature sensor.kicad_block/temperature sensor.kicad_sch

## KiCad design blocks/schema.kicad_blocks/temperature sensor.kicad_block/temperature sensor.kicad_sch (2026-08-25)

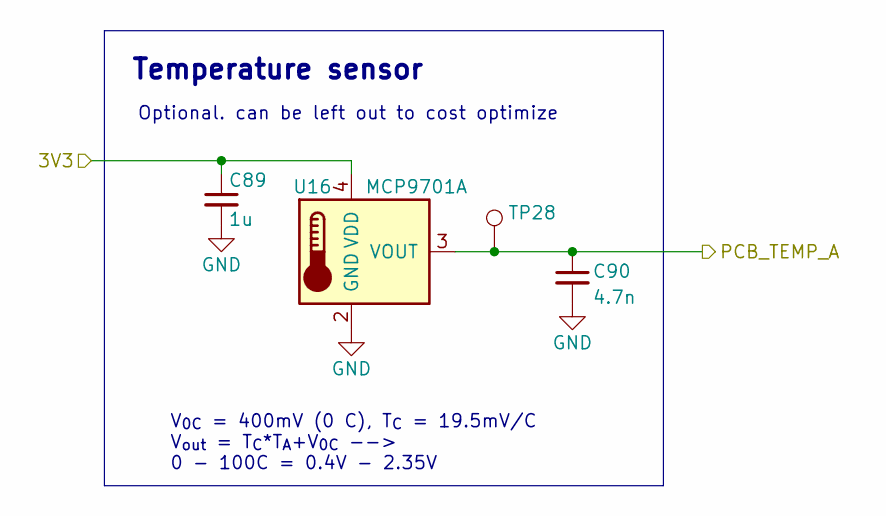
[picture p151: schematic temperature sensor.kicad_sch]

Parts:
C89: 1u; C_0603_1608Metric
C90: 4.7n; C_0603_1608Metric; rating X7R, 50V
TP28: DNP; TestPoint_Pad_D1.0mm
U16: MCP9701A; SOT-353_SC-70-5; MPN MCP9701AT-E/LT; mouser# 579-MCP9701AT-E/LT

Connections:
3V3: C89.1, U16.4 (VDD)
GND: C89.2, C90.2, U16.2 (GND)
PCB_TEMP_A: C90.1, TP28.1, U16.3 (VOUT)

Notes on the sheet:
Optional. can be left out to cost optimize
Temperature sensor
V_{0C} = 400mV (0 C), T_{C} = 19.5mV/C V_{out} = T_{C}*T_{A}+V_{0C} --> 0 - 100C = 0.4V - 2.35V
