JitterCompany/KicadComponents/(commit log)

2018-10-16 Add our existing symbols and footprints from blinky library
2018-10-16 Rename footprint libraries
2018-10-17 Add some components
    [D-DO214AC-0002-00019.stp]
2018-10-17 Add some more 3D STEP files
    Rename .stp to .step for consistency.
    [A6S-1102-H.step, A6S-4102-H.step, D-DO214AC-0002-00019.step, D-DO214AC-0002-00019.stp]
2018-10-17 Add LTC4412 Ideal Diode Controller
2018-10-17 Add Power mosfet + HSMT8 footprint
    [HSMT8.STEP]
2018-10-18 Component Q_NMOS_DMN2011UFDF-7: fix footprint link
2018-10-18 Add 3D models for crystals
    [CRYSTAL_SMD_TXC_7A-2Pin_5.0x3.2mm.step, Crystal_3.2x1.5_ABS07-series.STEP]
2018-10-18 Add some 3D footprints
    [JST_B2B-PH-SM4-TB.step, JST_B3B-PH-SM4-TB.step, SMD_SOT23-6.step]
2018-10-18 add / fix some 3d footprints
    The kingbright kpda-1806 (model apda-1806) does not seem to work in 3D?
    [APDA1806.step, SMD_resistor_1206.STEP]
2018-10-18 Fix kingbright KPDA-1806 LED 3D footprint
    The 3D origin was way off. Fixed with FreeCad (Kicad Stepup tool)
    [APDA1806.step, APDA1815_cp.step]
2018-10-22 Add footprints:
    - Horizontal SMD pin header (2.54 pitch)
    - L712RAS IP67 DC jack
    [L712RAS_switchcraft_dc_jack.step, pin_header_a-sl254-ea-g10mp1.stp]
2018-10-23 PowerPAK footprint: adjust silkscreen
2018-10-23 Add JTAG / SWD header footprint
    [header_1.27_5x2_boxed.STEP]
2018-11-21 Add multiple footprints
    [CUI UJ2-MIBH-4-SMT-TR-67 Micro USB Waterproof.STEP, VARTA_3V600HR.STEP, button_ALPS_SKRKAEE020.STEP, pin_header_a-sl254-ea-g3mp1.STEP]
2018-11-28 Add components:
    - BQ2002T (NiMH charger)
    - LT1618EDD (DC-DC boost converter with constant-current)
    [SSOP_axial_port_1317A.STEP]
2018-11-29 Add multiple footprints + parts related to project 8001
    [JST_S2B-ZR-SM4A-TF.STEP, SKQYAB.STEP, button_SKQYAB.STEP, vishay_powerpak_SC70-6L.step]
2018-12-11 Add several footprints + parts related to project 8001
    [APA102 2020 LED.STEP, inductor_taiyo_NRS8030.STEP]
2018-12-19 Add special headers for JTAG converter board
    - one with no silklayer
    - one with mirrored (Y) pin numbers
2019-02-06 Slight update for microUSB footprint
2019-02-06 Add footprint for the Wurth LHMI-1040 size Inductor
    [WE-LHMI-1040.step]
2019-03-06 Add copper/silk jitter icon
2019-03-06 Add tooling hole with slightly larger paste hole
    This might prevent the stencil from jamming when lifting from pcb
2019-03-13 Add footprint for 12-pin FFC cable 'connector'
    [FFC_stiffener_6.5x5x0.2.step]
2019-03-19 Add BQ24610 Li-Ion charger
2019-03-20 Add two power mosfet parts: SI7617DN (P) and CSD17578Q3A (N)
2019-05-07 Add power mosfets
2019-06-12 Add Some components
    - LMV431A shunt regulator
    - Si7060 I2C temperature sensor
2019-06-12 Add a lot of footprints
    - BatteryHolder footprints for Keystone 1042(P) and/or1043(P)
    - Enclosure_100x76x35
    - Fuse_2410_6125
    - JST PH SMD header (2-, 3-, 4-, 6-pins)
    - Inductor Bourns SRP6060FA
    - Inductor Bourns_SRR1280
    - MountingHole M2 threaded_5mm
    - Mosfet: PG-TDSON-8-33
    - Mosfet: PowerPAK_SO-8_Single
    - TSDSON-8
    - VSONP-8-1EP_5x6_P1.27mm
    [JST_S2B-PH-SM4-TB.STEP, JST_S3B-PH-SM4-TB.STEP, JST_S4B-PH-SM4-TB.STEP, JST_S6B-PH-SM4-TB.STEP, PG-TSDSON-8.stp, PowerPAK SO-8.step, SRP6060FA.stp, TDSON-8-33-P-v01_00-EN.stp]
2019-06-14 Add some mechanical footprints
    - MountingHole_2.7mm_M2.5_Pad_Via__compact.kicad_mod is based on the
    standard M2.5 mounting hole, but more compact.
    - hole_1.2mm_nonplated.kicad_mod is simply a NPTH (the only way to add
    this to a board is via footprints)
2019-06-27 Add some components + footprints
    Add two schematic components for mosfets.
    Most of the footprints are variants of standard library parts that have
    slightly different dimensions.
    [PTSM_0.5_4-HH0-2.5-SMD.STEP, PowerDI5060-8-Type-C.stp, capacitor_SMD_12.5x13.5__panasonic_H13.STEP]
2019-10-01 Add AEDR-8300 optical encoder and Wurth M4 6mm smd spacer
    [spacer_M4x6mm_Wurth_9774060482R.STEP]
2019-10-01 Fix 3D model for smd spacer
2019-10-01 Footprint AEDR-8300: Add 3D shape
    [AEDR-8300_encoder.STEP]
2019-10-02 Add blackpill board and 6 pin smd jst ph header
    [JST_PH_B6B-PH-SM4-TB_1x06-1MP_P2.00mm_Vertical].STEP]
2019-10-03 Footprint library: use 'jitter:' alias
    Do not use a custom environment variable, as the step file exporter does
    not seem to like that..
2019-10-03 Footprint for blackpill board: add 3D footprint
    [blackpill_mcu_board.STEP]
2019-10-09 Add Heltec lora-wifi-esp32 breakout and rotary encoder
    [rotary_encoder_RGB__SF-COM-10982.STEP, wifi_lora_32_v2.STEP]
2019-10-09 Change mousebite footprint
2019-10-09 Add 3D models for USB and banana plug
    [Wurth_USBA_61400416021 (rev1).stp, Wurth_USB_MicroB_629105150521 (rev1).stp, ct3151sp-0-BLK-300_banana.step]
2019-10-09 Add Tooling hole for dual sided SMD assembly
2019-10-10 Add NFC and LED components for business card
2019-10-30 Add JitterLogo
2020-01-09 Add 3D footprint for slide_switch_09.03201.02
    [switch_eoz_09.03201.STEP]
2020-01-09 Jitter_Logos: mark footprints 'virtual'
    This way they won't show up on the BOM etc.
2020-01-09 Fix M4_threaded_6mm footprint
2020-01-09 Add slightly smaller mousebite footprints
    These might cut away slightly cleaner because the holes are closer to
    the board edge
2020-01-10 add 3d step models for molex connector and rotary switch
    [Molex_503480-1400.stp, PEL12D-4x18G-xxxxx.stp]
2020-01-27 Add/update footprints
    Update VL6180X: add 3D footprint
    Add SMTU 2450N battery holder + 3D footprint
    Add 3D footprint for SFH 2440 photodiode
    [SFH_2440_160916_geometry.STEP, SMTU 2450N-1-LF.STEP, SMTU 2450N-1-LF_with_battery.STEP, VL6180X v5.step]
2020-01-28 Fix footprint SMTU2450N: courtyard caused DRC errors
2020-01-29 Fix footprint VL6180X: mark footprint as 'SMD'
    This is an SMD footprint, not a through hole..
2020-01-29 Update jtag footprint: improve silkscreen
2020-01-30 Fix symbol for pressure sensor (pin bidirectional instead of output)
2020-01-30 Fix 3D footprints: use 'jitter:' prefix instead of '/'
2020-02-10 Logo footprint: add 'DNI' hint
2020-02-24 Add inverted GND text
2020-02-24 Add footprints: Murata lora, antennas, cap touch etc
    [CMWX1ZZABZ.STEP]
2020-03-22 Add footprints: 7001-related
    [691322110002_Wurth_WR-1x02P3.50mm_Horizontal.stp, 691322110003_Wurth_WR-1x03P3.50mm_Horizontal.stp, 691322110004_Wurth_WR-1x04P3.50mm_Horizontal.stp, 691322110005_Wurth_WR-1x05P3.50mm_Horizontal.stp, 691322110006_Wurth_WR-1x06P3.50mm_Horizontal.stp, 691322110008_Wurth_WR-1x08P3.50mm_Horizontal.stp, 691322110012_Wurth_WR-1x12P3.50mm_Horizontal.stp, ABPMAN-series-pressure-sensor.STEP]
2020-03-24 Add 7001-related footprints, fix bugs in #2af3bdfd
    [2x20_header_STP_610020243021_rev1.stp, DeltaS24series.step, WE-SCC-1260_rev1__CommonMode.stp, WE-TVSP-DO-214AC-Bidirectional_rev1.stp, WE-VS-1206_rev1.stp, mps_dcdc_ult_smt_a.step]
2020-04-03 Add more 7001-related footprints (for rev2)
    [Conn_HIROSE_FH12-6S-0.5SH_55_eec.STEP]
2020-04-03 Add vertical 5-pin pluggable terminal block
    [691321100005_Wurth_WR-1x05P3.50mm_Vertical.stp, 691361100005_Wurth_WR-1x05_Plug.stp]
2020-04-03 Add wavesoldering-compatible mounting holes
2020-05-19 Add some footprints (6001,7001 related)
    [691361100002_Wurth_WR-1x02_Plug.stp, 8SIOC.stp, DCT__R-PDSO-G8.stp, JST-06FLH-SM1-TB.step, MPVZ5010GW6U.SLDPRT, S6B-ZR.STEP, battery-cr2450.stp, m20-7910842_asm.stp]
2020-05-26 Add 3D for mPCIe + Wurth microUSB, improve pinsocket footprint
    [mPCIe-spec.STEP]
2020-05-26 Add footprints for right-angle 402 LEDs and SMA connector
    [HSMC-C230_LED_red_right_angle_0402.STEP, HSMQ-C230_LED_green_right_angle_0402.STEP, HSMR-C230_LED_blue_right_angle_0402.STEP, SMA_right_angle_TE_619540-1.step, Wurth_USB_MicroB_614105150721_vertical.step]
2020-05-28 Add 6-pin FFC connector, RPI zero 3D shape
    [FH12-6S-0.5SV.stp]
2020-07-15 Add new components for Telecom and Devboard
    [CRYSTAL_TXC_9C_TXC.step]
2020-07-16 Fix hidden power pins.
    Hidden pins that overlap with power pins (pin stacking) should be
    passive. Otherwise the emit global net labels that can cause conflict.
2020-07-16 Add 3d model for boxed header 13x2
    [boxed_connector_13x2_2.54mm.STEP]
2020-07-20 Update schematic symbols
2020-07-21 Add spring contact + AAA battery connectors
    [AAA Battery.STEP, keystone_55_batteryclip_aaa.STEP, keystone_56_batteryclip_aaa.STEP, spring_contact_TE_2306334-3.stp]
2020-08-07 Add / update multiple footprints
    [ASVTX-13.STEP, FH12-10S-0.5SH.STEP]
2020-08-17 Add footprint for shielding can, pin jumper, add 3D UFBGA73
    [Pin header jumper.STEP, UFBGA73.STEP, ms302-10_2.step, vls252010cx-1.step]
2020-09-22 Add a lot of footprints (25xx related)
    [2920L110_60MR.STEP, B2B-XH-AM.STEP, B8B-XH-A.STEP, MF-GSMF300_36X.STEP, tbu-ca.stp]
2020-10-01 Fix bugs in Neutrik XLR footprints, add wavesolder-compatible M3 mounting holes
2020-10-06 Add footprint for nano sim slot
2020-10-09 Add 3D model for nano sim
    [SIM8051-6-0-14-01-A.stp]
2021-01-15 Add harwin S7121-42R spring contact
    [s7121-42r.step]
2021-01-25 Add footprints for ADXL355, M2 rivet, mounting holes and more
    [ADXL355BEZ-RL.stp, rivet_DIN660_M2_3mm.STEP]
2021-01-26 harwin S7121-42R spring contact: wider pads for better solderability
    Pads were exactly the size of the contacts themselves. The manufacturer
    has no clear drawing, but they do have downloadable foootprints which is
    where the new dimensions are based on
2021-02-16 Add Quectel BG95, 12-pin FFC connector
    [BG95.step, FH12-12S-0.5SH.stp]
2021-02-19 Add multiple components + footprints (4G / 868 antenna, RPI CM4 etc)
    [1002427_ME_fit.stp, DF40HC(3.0)-100DS-0.4V.stp, w3544b_7-65_26_3.stp]
2021-02-24 Modify antenna footprint for DRC-check compliance, add 0.5mm pitch SIM ESD variant
    [TPD3F303DPVR.step]
2021-02-26 Add commonmode choke, Wurth REDFIT and more
    [490107670612.stp, WE-SL5_HC_744273.stp]
2021-03-09 Add Ethernet switch + connector, microfit connector, fix CM4 symbol & more
    [KSZ8794CNXCC-TR.step, microfit_2x2_rightangle_430450409.stp, we_8p8c_74980111211.stp]
2021-03-11 Bugfixes and a few new components
    - Fix REDFIT footprint (mechanical hole too small)
    - fix uart_host header
    - add ATSAME53J18A-A symbol (the -A version has no pad 65)
    - add some more footprints
    [LMQ61460.stp, SFW15R-1STE1LF.stp, WE-LHMI-1365.stp, m50-3100545_asm.stp]
2021-03-16 Fix/improve footprints
    - QFN40P800X800X90-65N: pin 1 marking in KiCad style instead of dot
    - TI_VQFN-HR-14: fix pin properties (the corner pins would not connect
    to planes)
    - spring_contact_harwin_S7121R: this is an SMD component, NOT through
    hole!
2021-04-27 Add some chip packages, Molex nano-fit 3x2 connector
    [1054291206.stp]
2021-04-27 Add library sybmol/footprint for NUCLEO-H7*5ZI-Q devkit
2021-05-03 Add various symbols + 3D footprints
    - multiple microfit/nano-fit connectors (add 3D footprints)
    - Panasonic relay (add 3D footprint)
    - new common-mode choke footprint
    [1053091202.stp, 1053101206.stp, 1053141204.stp, 430450221.stp, 430450421.stp, 430450800.stp, PLT10HH101150PNL.step, Panasonic-ALZ12B24.step]
2021-05-04 Add Microfit 2x2 PCB-mount plug footprint
    [447640401.stp]
2021-05-06 Add stm32g071kxUxN footprint
    Note: there are 2 variants of the QFN-32 footprint for this series. This
    is the PD version.
2021-05-06 Update redfit connector footprint
    Add arrows that point in the direction of the cable and the board edge.
2021-06-18 PRM footprints en 3D
    [M8S-04PFFR-SF8001.stp, MAX16052AUT.stp, MAX5322EAIT.step]
2021-06-18 Add various component footprints
    [JST_S4B-ZR-SM4A-TF.STEP, LED_0804_rigthangle_blue_LTST-S220.STEP, LED_0804_rigthangle_green_LTST-S220.STEP, LED_0804_rigthangle_red_LTST-S220.STEP]
2021-06-24 nieuwe footprints van horizontale capacitors en 2 nieuwe footprints
    [B57211P0100M301.stp, ElCapLA-1.5-4x5-black.step, ElCapLA-1.5-4x5.step, ElCapLA-1.5-4x7-black.step, ElCapLA-1.5-4x7.step, ElCapLA-2.0-5x11-black.step, ElCapLA-2.0-5x11.step, ElCapLA-2.0-5x5-black.step]
2021-06-29 Fix MAX5322EAIT symbol, 3D footprints
2021-06-30 add distance measurement module
    [AFBR-S50MV85G.stp]
2021-07-02 JST 3d models added
    [JST-B10B-PH-K-S.step, JST-B10B-PH-SM4-TB.step, JST-B11B-PH-K-S.step, JST-B11B-PH-SM4-TB.step, JST-B12B-PH-K-S.step, JST-B12B-PH-SM4-TB.step, JST-B13B-PH-K-S.step, JST-B13B-PH-SM4-TB.step]
2021-07-05 component CSD17552Q3A mosfet added
    [CSD17552Q3A.stp, MAX6160EUS-T.step]
2021-07-09 new component: cap, tlv, lmv
    [EEEFPV680XAV.stp, LMV339IRUCR.stp, PESD3V3L5UF115.STEP, TLV4333IPWR.stp]
2021-07-12 Add LMR36506R3 DC/DC controller and some Inductor footprints
    [WE-LQFS-4828.stp, WE-TPC_4818.stp]
2021-07-13 Improve mosfet schematic (pin types)
2021-07-15 added new component and doser logo
    [PESD3V3L5UY,115.stp]
2021-07-19 add new jst 3d and afbrs50mv85g
    [JST-S8B-PH-SM4-TB.step]
2021-08-17 Make keepout smaller for JST footprint
    Remove corners from bounded rect keepout
2021-11-19 Update multiple footprints
2021-11-19 Add a lot of new footprints
    [BGA-6_1x1.5mm_2x3p0.4 v2.step, CONEC_43-01197.stp, CONEC_43-01199.stp, CONEC_43-02639.stp, FH12-15S-0.5SH.stp, FH12-6S-0.5SV.step, Honeywell_ABP2-L-SN_SMT_leadles.step, Honeywell_ABP2-RR_SMT.step]
2022-02-28 Add various connector footprints
    [B10B-PH-SM4-TB.STEP, PTSM_0.5_8-HH0-2.5-SMD.STEP, TE_T4141012041-000.stp, jst-b4b-xh-a-1.step]
2022-02-28 Add ABP2 pressure sensor footprint
2022-02-28 Add reverse-mounted 2-color LED
    [WE-WL-SBRW-1205.stp]
2022-04-29 Add lots of new components
    [B8PS-VH.STEP, Crystal_SMD5032.step, L_CommonModeChoke_Coilcraft_0805USB.stp, TBU-DFxxx.STP, TE_T4141012051-000.stp, mf-r400.stp]
2022-04-29 Create multiple sub-libraries for specific kinds of components
    All components in one library is getting a bit too much. New components
    should be added to a specific sub-library. Jitter_Components will
    eventually be deprecated or remain as a category or 'other' components.
2022-04-29 Update README: kicad6 + new libraries
2022-07-07 Update library with various parts
    [CUI_V78E05-500-SMT.step, Transformer_Ethernet_Wuerth_749020100A.stp, WE-LHMI_8040.stp, tdfn8-1.5x2.step]
2022-07-21 Add Jitter_Connectors symbol library with refdit debug connectors
2022-07-27 Add JLink Connector and improve debug connectors
2022-09-07 Add various components & footprints
    (most are related to project 1112)
    [DLM0NSN900HY2D_choke.STEP, MRJ-5381-M1.step, TE-1717478-1.stp, keystone_254_batteryclip_18650.STEP]
2022-10-07 Added ADC and SI1003 symbols for the FrogWatch 2.0
2022-10-19 Fix MM60-EZH039-B5-R850 footprint: adjust size of alignment hole
2022-10-26 Included the ADC footprint for the Frogwatch, updated symbol and added KiCad Jitter worksheet.
2022-12-05 added some components with 3d model from time ago
    [ADS1284IRHFT.stp, SI1003.stp, SN74LV125AD.step]
2023-02-02 Add a lot of new component/footprints
    Some existing footprints were fine-tuned based on experience with them
    in previous PCB revisions.
    [SIM8060-6-1-14-00-A.stp, Stocko_MKS_1853-6-0-303_1x3_P2.50mm_Vertical.step, TE_640456-8.step, TE_8-188275-4.step, WE-TPC_5828.stp, molex_705430003.stp, relay_CUI__PR24-24V-900-1C.step]
2023-04-21 Added 30 pin FPC header footprint.
2023-04-21 Added TDK inductor footprint.
2023-04-21 Added TI-VQFN-HR battery charger IC footprint.
2023-04-21 Added Wurth MicroSD footprint.
2023-05-05 Copied Keystone battery holder, C&K button and USB C footprints from VP project to Jitter libs.
2023-05-05 Updated C&K footprint and symbol.
2023-05-05 Footprint: fix link to 3D symbols jitter -> JITTER
2023-05-05 Add 3D footprint for 18650 battery + clips
    [18650.step, keystone_54_batteryclip_18650.step, keystone_57_re_preloaded.step]
2023-05-12 Added connectors for the FrogWatch project.
    [FH12-30S-0.5SH.stp, Harting_09185066324.STP, Harting_09185206324.STP]
2023-05-31 Harting connectors: adjust colors
    [Harting_09185066324.STP, Harting_09185206324.STP]
2023-05-31 Add harting_0919520X824741 connector, PV2F240 series button
    [PV2F240xx.stp, harting_0919520X824741.STP]
2023-06-01 microSD Wurth 693071010811: add 3D model
    [MicroSD.stp, microSD_Wurth_693071010811.stp]
2023-06-01 Add some connectors
    [Molex_436500304.step, TE-1717445-6.step]
2023-06-08 Battery connector: improve location of 3D footprint (was floating above PCB)
2023-06-09 README: add note about Kicad7
2023-06-09 Keystone PN2894: adjust courtyard (spring clip extended past courtyard)
2023-09-11 Add multiple footprints & symbols, mostly project 4108 related
    [Amphenol_FFC_s10051922-1010elf_10circuits_lowprofile.stp, FH12-30S-0.5SV.stp, Molex_FFC_527461071_1mm_10circuits.stp, SOT-416.step, WSON8-8x6.step, vqfn-hr-29.step]
2023-09-15 Update components
    [TPD6F002DSVR.step, WE-CNSW_0805_CNSW.stp, WSON-12_3x1.35mm_P0.5mm.step]
2023-09-15 Update symbols & footprints related to 4108
2023-10-18 Added WR-WTB 1.5mm Male footprint + 3D model.
    [679304124022_vertical.stp]
2023-10-18 Added VP circle connector.
2023-10-20 Fixed wrong pin number.
2023-12-15 Added HTS1510 symbol and footprint for VP ronde banen print.
2024-01-26 Added Quectel EC25 symbol and footprint.
2024-01-26 Added mini PCIe full card footprint.
2024-02-02 Added symbols, footprints and step files for custom EC25.
    [Laird_BMI-S-202-F.STP, SRP0512.stp]
2024-02-16 Updated some footprints for custom EC25.
2024-02-19 Molex_Micro-Fit_3.0_43650-0304: fix 3D component heigth above board
2024-02-19 BatteryHolder_Keystone_PN2894_CR1220: add keepout / dashed line indicating where battery is inserted
2024-02-19 Add M3 mounting hole variant
2024-02-19 18650 battery model: update model to account for tolerances (cell can be up to 18.5mm dia)
    [18650.step]
2024-02-19 Update/tweak footprints related to project 2503
2024-02-19 add 3D models for battery clamp
    [jitter_batt_clip_18650_clamped.step, jitter_batt_clip_18650_empty.step]
2024-02-19 Add PreciDip_811 footprints
    [slc_connector_811-s1-004-30-014101.stp]
2024-02-19 Add various footprints related to 4108-batt (fuse/batt protection ICs etc)
    [43650-0403.stp, SCF4030-12-02.stp, TCO_Bourns_SA_series.step, TI_VSON8-3x3.stp, TI_WSON8-DMS.step, contact_2mm.step]
2024-02-23 Added symbol and updated footprint for EC2x.
2024-02-23 Added footprints for custom EC2x board.
2024-04-05 Add netties, RF switch, adjust UFL, logo
    Logo: mark as exempt-from-courtyard
    UFL: adjust courtyard (it was a bit large)
2024-05-10 Rename Jitter_Logos and Jitter_Footprints librarie: add '.pretty' suffix
    Since KiCad 8 this seems to be required for the libarries to work
2024-08-13 Add lots of footprints
    [691321100002_Wurth_WR-1x02P3.50mm_Vertical.stp, CSP6_BAL-UWB-01E3_STM.step, ESP32-S3-WROOM-2-N32R8V--3DModel-STEP-510211.STEP, PTSM_0.5_2-HH0-2.5-SMD.STEP, Stocko_MKS_1854-6-0-404_1x4_P2.50mm_Vertical.step, Stocko_MKS_2862-6-0-1212_1x12_P2.50mm_Horizontal.step, TE_5-520314-5_1x05_P2.54mm_Horizontal.stp, TE_5499786-1.stp]
2024-08-22 Add some footprints (mostly 260x related)
    [FH12-20S-0.5SV.stp, JST_S10B-PH-SM4-TB.STEP, Stocko_MKS_2853-6-0-303_1x3_P2.50mm_Horizontal.step]
2025-04-25 Update 4108-related footprints
2025-04-25 Fix missing 3D models for some footprints
    [GCT_USB4120-03-C_REVA.step, PreciDip_811_6P.step]
2025-04-29 Add pcb art root logo
2025-04-29 pcb art root logo: fix fabrication attributes
    no courtyard and no DRC errors for exposed copper
2025-06-10 fix IDC header footprint name
2025-12-03 Add special ABP2LSN series footprint without the venting hole
    To be used only in PCB designs that incorporate their own venting solution
2026-04-21 Add mirrored cortex-jtag footprint
    intended to plug into a 10-pin jtag socket (as if it were a cable)
2026-08-17 Add lots of footprints & symbols
    [691304330003_Wurth_WR-1x03_push-in.stp, 691305330003_Wurth_WR-1x03P3.81mm_Vertical_latch.stp, 691311500103_Wurth_WR-1x03P5.08mm_Vertical.stp, 691321300003_Wurth_WR-1x03P3.81mm_Vertical.stp, 691322310002_Wurth_WR-1x02P3.81mm_Horizontal.stp, 691322310003_Wurth_WR-1x03P3.81mm_Horizontal.stp, DGN0008G_VSSOP-8_EP.stp, M12A-05PFFP-SF8001.step]
2026-08-17 Add some kicad10 schematic building blocks
    [PWM output 12V.kicad_sch, dc_dc_3v8_3a.kicad_sch, low-noise LDO.kicad_sch, nanoSIM slot.kicad_sch, power_switch_5v5.kicad_sch, temperature sensor.kicad_sch]
2026-08-25 Add some components+footprints
    [DHVQFN-14.step, PT-1340P-P10-PQ.step, Wurth_microSD_693072010801.stp, temperature sensor.kicad_sch]
2026-08-26 Add connector (its in kicad libs but weird rotation of 3D footprint)
    [Hirose_FH12-40S-0.5SH_1x40-1MP_P0.50mm_Horizontal.step]
2026-09-18 Fix swd/uart connector symbols
    Electrical pin types and arrow directions for some of them were wrong
    The correct direction is:
    - ClientSide TX pin (tx_to_host): arrow 'leaving the connector' (electrical type: input)
    - HostSide RX pin (tx_to_host): arrow 'arriving into connector' (electrycal type: output)
    note that electrical type appears contradictionary but this is because
    in Kicad the electrical type of a symbol is always *from the perspective
    of that symbol*. E.g. a connector that serves as an *output* for the PCB
    will have type *input*, meaning something in the schema must drive it.
2026-09-18 Fix 3D footprint for JLink_PinHeader_2x10_2.54
2026-09-18 Add micro-size logo (~1mm high)
2026-11-04 EG915N: default footprint Quectel_LGA126 (126 pads), not the 102-pad BG95
2026-11-04 Add SL modem interface symbols, mPCIe form factor (card side, host side)
    Pins grouped by extension (Core, M, U, S, X, P) with labels. Card side has all
    pins on the right, host side has power on top. RFU/DNU pins hidden. Each
    extension pin has a <name>_NC no_connect alternate for an unused extension.
2026-11-04 EG915N symbol per Hardware Design V1.5, derived symbols per MPN
    - Pin names and types per HD V1.5 Table 6 (SLEEP_IND, USIM1_*, GRFC_1/2, MIC_N/P,
    ~{RESET}, ~{W_DISABLE}); PPS_GNSS (51) visible, it was a hidden RESERVED pin
    from the no-GNSS variant. AUX_RTS/CTS in the Aux UART group.
    - Blocks Quectel marks * (not supported yet): Aux UART, antenna tuner GRFC,
    WAKEUP_IN, USIM2_DET, as no-connect pins.
    - Variant pins with a <name>_NC alternate: GNSS 49/51, ADC 2/24 (EU only).
    - EG915NEAAG-N05-SGNSA and EG915NEAAC-N05-SNNSA extend EG915N with the MPN.
2026-11-06 EG915N variants as standalone symbols, add EG915NEUAP-N06-SGNSA
    EAAC: no GNSS (49/51), no ADC (2/24). EAAG: no ADC. EUAP (EU, GNSS, ADC): all pins.
    Absent pins are hidden RESERVED no-connect, so every pad keeps a pin.
    No _NC alternates in the variants. Base EG915N symbol unchanged.
2026-11-06 SL modem symbols: extension E, pin 19 ~{ANT_EXT} (external antenna detect/force)
2026-11-06 Footprint L_Molded_3.2x2.5x1.2mm: molded power inductor, 1.2 mm max high
    Fits Bourns SRP3212A and Fenghua PIM322512 (and other 322512 parts).
    Pads 1.4x2.8 mm, gap 0.9 mm: inside both recommended lands.
    3D model SRP3212A.stp.
2026-11-06 Jitter_IC: TPS3840DLxxDBVR supervisor (open-drain, SOT-23-5)
2026-11-09 Jitter_IC: 74LVC1G123DC monostable (Nexperia, VSSOP-8)
2026-11-09 Jitter_IC: TPS25940LRVCR eFuse (latch-off, WQFN-20 RVC)
    Stock footprint QFN-20-1EP_3x4mm_P0.5mm_EP1.65x2.65mm matches TI's
    RVC0020A land pattern. IN/OUT/EP stacked, extra pins hidden.
    Price 2026-11: Mouser $1.48, JLC $1.40.
2026-11-12 RWU0007A 3D model; SIM8051 and PG-TSNP model paths as ${JITTER}
    TI STEP (Ultra Librarian) for the TPS61022 footprint, checked for pin 1 and
    pad alignment at zero offset. The :JITTER: alias does not resolve in
    kicad-cli, so the pcb_release 3D gate fails on it.
2026-11-13 Jitter_Logos: SIM card_small and SIM card_smallest insert markers
    SIM card outline with knockout Fira Code letters, chamfer at the SIM8051
    pin 7 corner, so the marker shows how the card goes in.
    2.4x3.3 mm and 2.1x2.95 mm, smaller siblings of the SIM card logo.
2026-11-13 Jitter_IC: NXU0204BQX (DHVQFN-14), alt TXU0204BQAR; TXU0204PWR datasheet link
    Same pinout as TXU0204PWR. Exposed pad is pin 15, a hidden GND pin
    stacked on pin 7 (TI recommends grounding it). TI BQA and Nexperia
    SOT762-1 share body, terminals and EP size, so one footprint fits both.
    TXU0204PWR pointed at the TXU0304 datasheet.
2026-11-13 3D model paths: :JITTER:file -> ${JITTER}/file
    The :JITTER: alias only resolves in the KiCad GUI. kicad-cli and the
    pcb_release 3D gate need the ${JITTER} variable. All referenced models
    exist in 3D/.
