JitterCompany/KicadComponents/(notices)

Notices in the files:
3D/SOT-363_SC-70-6.step:
Copyright (C) 2025, KiCAD
This work is licensed under the
[Creative Commons CC-BY-SA 4.0 License](https://creativecommons.org/licenses/by-sa/4.0/legalcode),
with the following exception:
project files under this or any other license agreement. However, if you wish to distribute
3D/wago_237-102.stp:
author */ ('License CC BY-ND 4.0'),
